2AMLogic/sky130-sar-adc/layout/cdac-array/README.md

# cdac-array/ — differential CDAC array layout (issue #100)

Physical layout for the differential charge-redistribution CDAC array
(`design/cdac/cdac_array.sch`) and its unit cell
(`design/cdac/cdac_unit_cell.sch`), drawn full-custom with `klt`'s
draw → DRC → extract → LVS flow.

```sh
layout/bin/setup-venv.sh              # once, or after bumping requirements.txt
source sim/env.sh                      # exports PDK_ROOT/PDK for xschem
layout/cdac-array/bin/run-flow.sh      # ~8 seconds; exit 0 iff all twelve verdicts hold
cat layout/cdac-array/reports/$(cat layout/cdac-array/reports/LATEST)/record.md
```

## Files

```
layout/cdac-array/
  bin/
    cdac_layout.py             # the generator: emits both top cells' GDS
    generate-lvs-reference.py  # xschem-netlists design/cdac/*.sch -> LVS reference
    render-record.py           # renders record.md, asserts the twelve verdicts
    run-flow.sh                # draw -> DRC -> precheck x2 -> extract -> LVS,
                               #   one record per run
  reference/
    cdac_array.lvs-reference.spice      # GENERATED from the schematic
    cdac_unit_cell.lvs-reference.spice  # GENERATED from the schematic
  reports/
    LATEST                     # record-id of the most recent run
    <record-id>/               # append-only: the GDS, drc/extract/lvs/draw JSON,
                               # the extracted netlist, the reference, record.md
```

Records follow `sim/`'s and `layout/trivial-cell/`'s append-only rule: a
re-run mints a new `<YYYYMMDD>-<HHMMSS>-<short-sha>` directory and never
edits an existing one.

## What the flow asserts

`run-flow.sh` exits non-zero unless **all twelve** of these hold, every one
read out of `klt`'s own JSON envelope rather than off a process exit code:

| # | Verdict |
| --- | --- |
| 1 | `klt drc` **clean** on `cdac_unit_cell` |
| 2 | `klt lvs` **match** on `cdac_unit_cell` vs. `design/cdac/cdac_unit_cell.sch` |
| 3 | `klt drc` **clean** on `cdac_array` |
| 4 | `klt lvs` **match** on `cdac_array` vs. `design/cdac/cdac_array.sch` |
| 5 | `klt extract` finds exactly 1024 MiM caps + 18 nfet + 18 pfet in `cdac_array` |
| 6 | Every bit 8..1 has its unit-cap centroid exactly on the array's centre in Y |
| 7 | Bits 8..4 additionally have it exactly on the centre in X |
| 8 | Every bit's P-side and N-side X centroids coincide |
| 9 | `klt precheck --grid-um 0.001` **pass** on `cdac_unit_cell` (its own database grid) |
| 10 | `klt precheck --grid-um 0.005` **pass** on `cdac_unit_cell` (sky130's manufacturing grid) |
| 11 | `klt precheck --grid-um 0.001` **pass** on `cdac_array` |
| 12 | `klt precheck --grid-um 0.005` **pass** on `cdac_array`, all 1024 units |

Verdicts 1–8 are numbered as they were before issue #498; 9–12 were added by
it and appended rather than interleaved so the numbering this document's own
prose uses did not shift under it.

One committed record predates that decision and does not show it:
`reports/20261001-084525-79abbf8/record.md`, the first post-resize record, was
rendered by a pre-final `render-record.py` that interleaved the four precheck
verdicts at 2/3/6/7, so it cannot be reproduced from its own committed JSON
envelopes by the renderer in this tree. It is left in place — records here are
append-only — and superseded by `reports/20261001-133221-7487784/`, a re-run of
the same flow at the same geometry whose `record.md` re-renders byte-for-byte
from its own envelopes. All twelve verdicts hold in both; only the numbering
differs.

Verdicts 6–8 exist because **1–4 have no opinion at all about placement**:
DRC and LVS are topology-only, silent about where a matched device
physically sits. Verdict 5 is independent confirmation of the same
extracted-device-count fact verdict 4's own literal comparison already
requires (see "`options.combine_devices` — issue #148" below); it stays as
a belt-and-braces check on the extraction side alone, cheap and orthogonal
to the LVS pairing. Verdicts 6–8 pin the placement using centroids computed
from the same placement functions the geometry is drawn from. Without
them, a matching-poor rewrite of this generator that still drew exactly
1024 unit elements in the wrong places would sail through 1–5.

Verdicts 9–12 exist because **1 and 3 are silent about manufacturing-grid
legality**, and that silence is not obvious: `klt drc`'s curated `sky130` deck
carries no `*.ongrid` rule on any layer (grep its own
`rules_checked`/`rules_skipped` lists in any `drc.json` here — there is no
OFFGRID entry), while the PDK's own shipped signoff deck
(`$PDK_ROOT/sky130A/libs.tech/klayout/drc/sky130A.lydrc`, `OFFGRID = true`) runs
`<layer>.ongrid(0.005)` by default on every metal/via layer this block draws. A
"DRC clean" record here therefore said nothing either way about the 5 nm grid
until these verdicts existed. They are a **gate, not an advisory metric**, per
[DR-019](../../spec/decision-records/DR-019-cdac-unit-cap-grid-legal-plate-resize.md)'s
standing policy for any block in this repo that draws a MiM cap.

They were added with DR-019's resize (#498) because before it they could not
have passed: on the old `CAPM_SIDE = 1.898` µm plate (1898 nm, not a multiple of
5) the same command reports **1** off-grid `capm` (89/44) shape in
`cdac_unit_cell` and **1024** in `cdac_array` — one per drawn unit, every one of
them the plate itself, measured directly against
`reports/20260924-233346-66dca3c/`'s committed GDS. On the 1.9000 µm plate both
are **0**, on both grids. `layout/halflsb-offset/`, which inherits this plate
size through DR-009, went 48 → 0 in the same pass.

The LVS reference is **regenerated from the schematic on every run**
(step 0 of `run-flow.sh`), never trusted from the committed copy: a match
against a stale reference proves nothing about today's schematic.

## `options.combine_devices` — issue #148

**`reports/20260825-132454-51cbdd4/`'s LVS "match" verdict did not
reproduce.** Re-running `klt lvs` today against that record's own committed,
byte-identical `cdac_array.gds`/`cdac_array.lvs-reference.spice`, with the
same toolchain versions its own provenance block stamps, reports
**mismatch** (48 errors), not match — and that mismatch reproduces 100% of
the time (10/10 repeat runs against those exact artefacts), so the original
"match" was itself the anomaly, not today's "mismatch" (see issue #148 for
the full diagnosis, including a version matrix ruling out a `klt`/`klayout`
version-drift explanation). **`reports/20260905-220338-9fb9b04/` (this
sub-block's current `LATEST`) supersedes it** with a fix that reproduces
match on every repeat run against its own committed artefacts (20/20, on
the `klt==0.4.0`/`klayout==0.30.12` pin `layout/requirements.txt` now
carries).

Root cause: the original flow's LVS request set `options.combine_devices:
true`, needed (at the time) to fold each bit's `w` physically drawn unit
capacitors into one device before comparing against a reference that
declared one combined `C` card of `w × C_unit` per bit. `w` ranges up to
256 here (the MSB), and issue #148 found that `klayout.db.Netlist.
combine_devices()` does not reliably re-sum `w` identical-valued parallel
capacitors at that scale: it correctly *sums* the capacitor device class's
secondary `A`/`P` (area/perimeter) parameters across the group, but on
some runs leaves the *primary* `C` (capacitance) parameter at a single
input instance's own unmerged unit value instead of the summed total —
silently, with **no exception and no `device.combine_incomplete` warning**
(the documented, already-mitigated nondeterminism from
klayout-tools#1185), so `klt lvs`'s own retry-on-exception mitigation for
that issue has nothing to catch. Depending on which numeric outcome a
given run happens to hit, the comparison can come back as: a spurious
`device.property` mismatch on `a`/`p` (when `C` summed correctly but the
reference has no syntax to declare the layout's now-nonzero combined
`A`/`P`, since a plain SPICE `C` card only carries a value); a spurious
mismatch on `c` itself (when `C` did not sum); or, on the original 2026-08-25
run, evidently neither — a lucky pass.

**The fix (issue #148) does not touch the reference-vs-layout `A`/`P`
question at all — it removes `combine_devices` from the picture entirely.**
`bin/generate-lvs-reference.py` now emits `w` separate unit-value `C` cards
per bit (one reference card per physically drawn unit capacitor) instead of
one combined card of `w × C_unit`, and `bin/run-flow.sh`'s LVS request sets
`options.combine_devices: false`. `klt lvs` now performs a literal,
uncombined, device-for-device comparison — 1024 drawn unit capacitors
against 1024 reference unit cards — which needs no device-merging pass on
either side and is a *strictly stronger* check than the folded comparison
ever was: it already fails if the array is not built from exactly `w`
identical unit elements per bit, with no separate extracted-device-count
verdict required to prove that fact (verdict 5, above, is now a redundant
but harmless independent confirmation of the same thing).

This is a `klayout-tools`/KLayout defect, not a usage error in this repo's
own LVS request (`combine_devices: true` was klt's own documented, intended
mechanism for exactly this folding use case): filed generically (no
design-specific detail, per `CLAUDE.md`'s friction protocol) at
[klayout-tools#1497](https://github.com/2AMLogic/klayout-tools/issues/1497)
-- a distinct failure mode from the already-tracked #1185/#466
(`RuntimeError`-on-partial-match, which has a documented retry mitigation):
this one never raises, so the existing exception-based mitigation for
#1185 cannot catch or retry against it. Should a future `klayout-tools`
release close #1497 with a guarantee that a combined device's primary
parameter (`C`) survives combining intact, `combine_devices: true` plus a
combined-card reference could be restored — but the per-unit form above is
simpler, needs no such guarantee, and is not planned to change back
without a concrete reason to.

## VDD and SELp/SELn landing geometry — issue #165

`cdac_array`'s `VDD` pin used to be a bare `nwell` rectangle with no tap or
contact drawn on it, and each `SELp<i>`/`SELn<i>` (i=0..8) pin used to be a
bare poly strap held at exactly the switch transistors' own channel width
end to end. Both were LVS-clean at this sub-block's own scope (the reference
subckt's ports only need to resolve to *some* named node), but neither had
any drawn conductor a top-level assembly (issue #103) could physically land
a wire on — sky130 has no global n-well connectivity fallback the way it
does for an unconnected p-substrate body (which is why `GND` connects for
free chip-wide but `VDD` did not).

Fixed with:

- **`VDD`**: a real n-well tap (`tap.drawing` + li1 + a licon1 column,
  mirroring `layout/comparator/bin/build_layout.py`'s own `tap_shapes()`
  recipe) contacted up through mcon to a met1 landing pad, placed in the
  open gap between the VREFN riser and the first switch's own diffusion —
  clear of every switch's geometry.
- **`SELp<i>`/`SELn<i>`**: a poly landing extension merged onto each gate-tie
  strap *outside* the diffusion-overlap region — specifically inside
  `SwitchTemplate.GAP_UM`'s own vertical clearance between the nfet and pfet
  blocks, which is diffusion-free by construction — offset away from the
  switch's own drain li1 riser, ending in a licon1/li1 pad sized to the same
  0.42 µm-square field-poly convention `klt gen mos_array`'s own gate pads
  use. The strap itself is untouched at its original channel width, so
  nothing here can be read as widening the transistors' extracted gate
  length.

Verified directly against `klt extract`'s per-device report: every one of
the 18 switch transistors' `L=0.15U` is byte-identical before and after (see
the PR for issue #165), and DRC/LVS both stay clean.

## `VSS` landing geometry — issue #377

Issue #165's parenthesis above — *"`GND` connects for free chip-wide"* — is
true of the **extraction deck** and false of the **layout**, and that gap is
what issue #377 closes here. `cdac_array`'s fourth schematic port (`VSS`,
every switch NFET's bulk) had no drawn conductor of its own at all. Unlike
`VDD` it was not even visible as an uncontactable bare layer: sky130's deck
synthesises one global p-substrate net by construction, so the port resolved
to that global and both `klt extract` and `klt lvs` were satisfied while this
block drew *no ground conductor whatsoever*. The composed assembly's analog
return therefore reached this block through substrate resistance — real, but
not something `klt drc` grades or this repo draws. That is the residue
[DR-012](../../spec/decision-records/DR-012-analog-ground-pad.md)'s own "Open
items" named.

Fixed with the p-substrate counterpart of the `VDD` tie above, by the same
`body_tap()` helper (in sky130 a tap is an n-tap or a p-tap purely by which
tub it sits in, so the drawn shapes are identical and only the placement
differs):

- **`VSS`**: `tap.drawing` + li1 + a licon1 column on **bare substrate**,
  directly below the `VDD` n-well tap and sharing its x, in the empty stripe
  between the switch row's own NFET diffusion (bottom edge y = −30.00) and
  the VREFN met2 rail — contacted up through mcon to a met1 landing pad
  carrying a `VSS` met1.pin label at (1.00, −31.60). That pad is what
  `layout/sar-adc-top/`'s analog ground mesh
  ([DR-013](../../spec/decision-records/DR-013-analog-ground-mesh.md)) lands
  a via riser on.

Clearances, and which of them this flow's DRC verdict actually backs: 0.60 µm
to the NFET block above (sky130's `difftap.3` tap-to-diffusion spacing is
0.27 µm) and 2.59 µm to the n-well's own bottom edge (`nwell.5a`, 0.34 µm)
are **not graded** — the pinned curated deck authors no rule on
`tap.drawing` (65/44) and none on n-well-to-tap spacing at all — so
`cdac_layout.py`'s `_assert_vss_tap_clearances()` asserts them in the
generator instead, where a future switch-row move fails loudly rather than
silently. The met1 landing pad's 2.84 µm to the VREFP rail and 1.79 µm to
the nearest switch riser *are* graded (`met1.space.1`), by every DRC run.

The reference side moved with the layout, not ahead of it:
`generate-lvs-reference.py` used to rename the schematic's `VSS` to `vsubs`
"for a block with no substrate tap of its own", which this block no longer
is, so the rename is retired for `cdac_array` and the reference now says what
the schematic says. `cdac_unit_cell` draws no tap of its own and keeps it.
Record `20260924-233346-66dca3c`: DRC clean on both cells, LVS match on both,
1060/1060 devices, 42/42 nets, 24/24 pins — all unchanged. One finding fewer
than the superseded record, and narrowly: `device.body_unverified` stops
firing on `cdac_array` because its substrate net is now a *named drawn
conductor* (`VSS`) rather than the deck's anonymous global. The deck's
`connect_global` still ties the eighteen NFET bodies together by
construction; nothing here verifies a per-device body tie, and
`cdac_unit_cell` still reports the warning, correctly.

That record is also this flow's first run on `klayout-tools==0.6.0`. A
same-source baseline on the new pin was run first and reproduced the
superseded `20260917-180543-527ec73` exactly (clean/match, 2 findings,
1060/42/24), so the delta above is this change's, not the bump's.

---

# The matching strategy

This is the block's matching-critical sub-block: its unit-capacitor ratios
*are* the converter's INL/DNL, and no amount of DRC/LVS cleanliness speaks
to them. What follows is the deliberate strategy, stated so it can be
argued with — and, where it is measurable, measured in each record.

## 1. Unit elements, never scaled plates

`design/cdac/cdac_array.sch` writes bit `i`'s weight as `MF=2**i` on one
`cap_mim_m3_1` symbol, and `design/cdac/README.md` is explicit that this is
netlist shorthand for `2**i` *parallel unit cells*, "**NOT** a claim about
physical placement". This layout takes that literally: **1024 physically
identical unit capacitors**, 512 per side, one drawn unit per unit of
weight. Every one of them is the same shape — same 1.900 µm capm plate,
same met3 bottom plate, same via2 position, same via1/met1 stub geometry —
so that whatever the process does to one unit, it does to all of them.

This is not merely stylistic. sky130's MiM model (and `klt extract`'s deck)
carries a **perimeter** term as well as an area term, so a single plate of
`w` times the unit area is *not* `w` unit capacitors: it has
`√w` times the perimeter, not `w` times. Ratio accuracy in a
binary-weighted CDAC depends on the weights being exact multiples, and only
a unit-element decomposition delivers that by construction. (It also means
the LVS reference for a bit of weight `w` is `w` separate unit-value `C`
cards, not one combined card of `w × C_unit` — see "`options.combine_devices`
— issue #148" below for why the reference is literal unit cards rather than
a scaled single device.)

## 2. Common centroid in X: dyadic mirror-pair columns

The array is 64 columns × 16 rows on a 3.4 µm pitch, so a column holds 8
units per side. Bits 8..4 own 32/16/8/4/2 columns, always as
**mirror-symmetric pairs about the array's vertical centre line**, and each
bit's columns are spread with a *dyadic* ("ruler") interleave — the largest
bit takes every other column slot, the next takes every other remaining
slot, and so on:

```
h (distance rank from the centre): 0  1  2  3  4  5  6  7  8 ...
bit owning that column:            8  7  8  6  8  7  8  5  8 ...
```

The mirror pairing cancels a **linear** X gradient exactly (verdict 7). The
dyadic spread is what makes the arrangement robust to a **quadratic**
(bowl-shaped) gradient as well: every bit samples the same distribution of
distances from the centre, so a bowl scales every bit's weight by
approximately the same factor — a gain error, not a nonlinearity, and gain
errors do not cost INL or DNL.

## 3. Differential interleave in Y, with a parity flip at the midline

Rows alternate P/N so that a Y gradient sees both sub-arrays equally. A
naive strict alternation would still leave the P set and the N set offset by
one row pitch (P on rows 0,2,4,… averages one row below N on 1,3,5,…), so
the parity **flips at the array's horizontal midline**: P owns the even rows
in the lower half and the odd rows in the upper half. The two sides' Y
centroids then coincide exactly, for every bit (verdict 6 and the record's
own centroid table).

Because P and N share the *same columns* for every bit, their X centroids
coincide by construction too (verdict 8) — a differential pair of
sub-arrays placed side by side, rather than interleaved, would instead have
its whole differential gain riding on the X gradient between the two halves.

## 4. The residuals, stated plainly

A binary-weighted array has a smallest element that cannot be split
symmetrically. Ours are:

- **bit3** owns a single column (col 31) and the
  **bit2+bit1+bit0+termination group** owns a single column (col 32). They
  sit either side of the centre line, so their X centroids are ∓1.7 µm
  (half a column pitch) rather than 0. The two offsets are equal and
  opposite, so the *side total* is still centred; the residual is a
  1.7 µm lever arm on groups worth 8 and 8 units out of 512.
- **bit0 and the termination unit** are one unit per side, so their P/N
  pairs are one row pitch (3.4 µm) apart in Y rather than coincident. This
  is the minimum achievable separation for a single-unit bit.

Both residuals are printed in every record's centroid table, not hidden.

## 5. The guard frame — and why it carries no capm

The array is ringed by one row/column of **guard plates**: the identical
met3 bottom-plate geometry and via2 landing as a real unit, tied to VREFN
(left/right/top collected on met2, the bottom row on met1 so its collector
does not have to cross 128 column straps on their own layer), but with the
**MiM top plate omitted**.

The omission is forced, and it is worth being blunt about the consequence:

- Under `klt` 0.3.0's sky130 extraction deck, *any* capm drawn over met3 is
  recognised as a capacitor device. The deck's dummy-device marker layer
  (`(83, 20)`, which suppresses drawn-but-non-functional MOS, resistor,
  bipolar and diode devices) is **not** consulted for drawn capacitors, so a
  capm-bearing dummy cannot be suppressed. Nor can it be neutralised by
  shorting its plates: the deck's `top_plate_via` overlap exclusion removes
  *every* via3-on-met3 overlap in the layout once any capm exists, so met4
  cannot be routed down to met3 anywhere, and a dummy's top plate has no
  path back to its own bottom plate.
- The result is that a capm dummy ring would appear in the extracted netlist
  as extra capacitors with no schematic counterpart — i.e. it would trade an
  LVS-clean result (an acceptance criterion of issue #100) for an
  etch-density guard.

So this layout guards the **bottom-plate (met3) level** — pattern density,
plate-edge lithography and the etch environment of the outermost active
plates — and leaves the **capm level** unguarded. What that costs is
bounded and uniform in the direction that matters: every column contributes
exactly one unit per side to each of the two edge *rows*, so a
row-edge effect is a pure gain term shared by all bits, with no INL/DNL
contribution. Only the two edge *columns* are bit-specific, and they carry
32 units per side out of 512.

Per `CLAUDE.md`'s friction protocol both tool gaps above are filed
**generically** at `2AMLogic/klayout-tools` — tool behaviour only, no
design detail: klayout-tools#1387 (the `dummy` marker is not honoured for
drawn capacitors) and klayout-tools#1388 (the top-plate-via exclusion is
chip-wide on a zero-oversize deck, so one drawn cap disconnects every
ordinary via between the bottom-plate metal and the metal above it). A
future `klt` that closes #1387 would let this ring grow a capm plate with
no other change to the generator — `draw_unit_cap(..., capm=False)` is a
one-flag switch — and the guard plates would then need only the deck's
dummy-marker layer added on top.

## 6. What this layout does *not* claim

- **No matching evidence.** Nothing here measures σ(ΔC/C), INL or DNL. The
  strategy above is an argument from symmetry, plus centroid arithmetic; the
  evidence is a Monte-Carlo mismatch campaign (issues #28/#29) run against
  a netlist that instantiates literal parallel unit cells. `design/cdac/
  README.md` §3 already flags that an `MF`-scaled schematic netlist may
  understate array mismatch if ngspice scales one mismatch term instead of
  drawing `w` independent ones — this layout is exactly the `w` independent
  units that concern is about.
- **No parasitic extraction.** `klt extract`'s device recognition is not an
  RC extraction; the met2 bottom-plate straps and met4 top-plate rails carry
  real parasitic capacitance to the top plates that is not in any number
  here.
- **No routing-parasitic balancing.** The per-bit strap lengths differ
  (a bit's straps run from its own columns to its own bus row), so the
  bottom-plate wiring capacitance is *not* matched between bits. It sits on
  the bottom plate, which is driven hard to VREFP/VREFN by the switch, so it
  costs settling time rather than charge accuracy — but it is unbalanced and
  unquantified, and a future revision that cares should say so with numbers.
- **Spec ratification.** `C_u` and `V_REF` were ratified by DR-003 via issue
  #27; this layout consumes DR-003 Item 3's plate size, as amended by DR-019
  (`1.9000 µm`, `C_u ≈ 8.664 fF`), and would be regenerated, not patched, if
  that changes again.
- **Grid legality — now checked here, and clean** (verdicts 9–12, added by
  issue #498). This was a known, measured failure until DR-019: on the old
  `CAPM_SIDE = 1.898` µm plate, `klt precheck --grid-um 0.005` reports 1024
  off-grid `capm` shapes in `cdac_array` and 1 in `cdac_unit_cell`, because
  1898 is not a multiple of sky130's 5 nm manufacturing grid and neither the
  plate's corners nor any via/pad a router centres on them can land on-grid.
  `layout/halflsb-offset/`'s own census (#495) is what surfaced the question,
  and
  [DR-019](../../spec/decision-records/DR-019-cdac-unit-cap-grid-legal-plate-resize.md)
  (#496) answered it: it reads the PDK's own shipped signoff DRC deck
  directly, confirms the grid check is real (not a klt-only convention), and
  resizes `C_u`'s plate to a 5 nm-grid-legal `1.9000 µm` rather than waiving
  it. Issue #498 carried that through here (`CAPM_SIDE = 1.900`), re-ran the
  flow, and added the two precheck stages as gating verdicts; the census is
  now 0 across all 1024 instances.

## Provenance

Flow structure (record convention, "assert verdicts from the JSON envelope,
never the exit code", `setup-venv.sh` reuse) follows
`layout/trivial-cell/`'s own flow in this repo, which was in turn ported
from `2AMLogic/sky130-bandgap` per `CLAUDE.md`'s harness-bootstrap
instruction. The layout itself is drawn from `design/cdac/*.sch` and device
physics only — clean room, per `CLAUDE.md`: no other party's CDAC
implementation was consulted, measured, netlisted or reconstructed.

## Tool-pin note

This sub-block requires `klayout-tools` **0.3.0** (bumped from 0.2.0 in
`layout/requirements.txt` by this work). 0.2.0's sky130 extraction deck
stops its `metals`/`vias` connectivity at met1, so a MiM-cap array — whose
bottom plates live on met3 and whose top-plate rails live on met4 — is not
extractable at all on that pin. The bump has one piece of fallout outside
this directory: `layout/trivial-cell/reference.spice` carried 8 M-cards
because 0.2.0 could not tell a dummy MOS from a real one, and 0.3.0 can, so
that reference is now 4 M-cards. Its header records the change; the
six-verdict trivial-cell flow passes on the new pin.

## `klt 0.4.0` → `0.5.0` re-run (issue #323): no change

This flow's sign-off record rested on `klt 0.4.0` (`reports/20260906-020815-38cdbd3/`)
while `layout/requirements.txt` had already moved to `klt 0.5.0` for the other
sub-blocks and the top-level composition — a version-parity gap, not a known
defect (see the parent issue for why that gap mattered). Re-run under the
pinned `klt 0.5.0` (`reports/20260917-180543-527ec73/`, now `reports/LATEST`):
`drc.json` and `lvs.json` (for both `cdac_unit_cell` and `cdac_array`) are
field-identical to the superseded record —

| Field (source, `cdac_array`) | `klt 0.4.0` | `klt 0.5.0` | Delta |
| --- | --- | --- | --- |
| `drc.json` `status` / `violation_count` | clean / 0 | clean / 0 | none |
| `lvs.json` `status` | match | match | none |
| `lvs.json` `mismatch_count` / `error_count` | 2 / 0 | 2 / 0 | none |
| `lvs.json` `counts.devices` (layout/reference/matched) | 1060/1060/1060 | 1060/1060/1060 | none |
| `lvs.json` `counts.nets` (layout/reference/matched) | 42/42/42 | 42/42/42 | none |
| `lvs.json` `counts.pins` (layout/reference/matched) | 24/24/24 | 24/24/24 | none |
| `lvs.json` `category_counts` | `device.body_unverified: 1, topology: 1` | `device.body_unverified: 1, topology: 1` | none |

`cdac_unit_cell`'s own DRC/LVS (clean / match, 3/3/3 devices, 7/7/7 nets) and
the drawn common-centroid geometry (unit capacitance, per-net unit counts,
per-net centroids) are likewise unchanged between the two records. No
regression — including no change in the sub-block's capacitor-heavy device
mix, which is the class of change klayout-tools#1876 (§3 of
`docs/chipalooza/challenge-4-proposal.md`) affected elsewhere in this
repo's `klt 0.5.0` re-runs — so no upstream `klayout-tools` issue was filed
for this re-run.
