2AMLogic/sky130-sar-adc/layout/sar-sequencer/README.md

# layout/sar-sequencer/ — SAR logic/sequencer physical layout (issue #102)

Physical layout for the SAR logic/sequencer sub-block: an (N+1)-stage
walking-one ring sequencer plus a 10-bit SAR register, captured in
`design/sar_sequencer.sch`/`.sym` (issue #55) on `sky130_fd_sc_hd` standard
cells. This directory places and routes that netlist and runs it through the
`klt` DRC/LVS flow, following `layout/README.md`'s (and `layout/trivial-cell/`'s)
conventions.

## Which `klt` flow, and why

**`klt place-and-route` (OpenROAD), not the full-custom `klt draw` flow.**
This sub-block is pure digital standard-cell logic with no analog matching/
symmetry judgement call (unlike the sampling front end, CDAC array, or
comparator sub-blocks) — placement and routing is exactly the kind of
decision a placer/router should make, not a hand-drawn one.

**`klt place-and-route` directly, *not* `klt synthesize` first.** `klt
synthesize` runs Yosys/ABC technology mapping from **RTL** — but this
sub-block has no RTL. `design/sar_sequencer.sch` already specifies exact
`sky130_fd_sc_hd` cell instances (dfrtp_1/mux2_1/or4_1/or3_1/inv_1) and
connectivity, already behaviorally verified against that exact netlist by
`sim/sar-sequencer-behavioral/`'s own testbench. Re-synthesizing from scratch
RTL through Yosys/ABC would let the tool pick *different* cells/drive
strengths than the ones already captured and simulated — laying out an
un-simulated netlist instead of the reviewed one. `layout/sar-sequencer/netlist/sar_sequencer.v`
is therefore a **hand-verified 1:1 structural transliteration** of the
schematic's own SPICE X-card connectivity (cross-checked line-for-line
against a real netlist snapshot in
`sim/sar-sequencer-behavioral/netlist-snapshots/*.spice`) into Verilog module-
instantiation syntax — not RTL synthesis output — and is fed straight to `klt
place-and-route`.

**Clock constraint**: `requests/place-and-route.json`'s `clock_period_ns:
83.33` (12 MHz) is `spec/decision-records/DR-006-sar-sequencer-bit-count-and-timing-budget.md`'s
own derived `f_clk,max` (the faster, more timing-demanding end of its
provisional `1.2 MHz – 12 MHz` range) — not an arbitrary number.

**Power delivery (`requests/place-and-route.json`'s `power` block)**: a real
PDN (`tapcell` well/substrate ties, `VPWR`/`VGND` global-connect, and
met1/met4/met5 straps — parameters taken from
`OpenROAD-flow-scripts`'s own published `platforms/sky130hd/pdn.tcl`
reference config, Apache/BSD-licensed EDA tooling config, not anyone's
silicon), not the row-rail-only obstruction `klt place-and-route` draws by
default when `power` is omitted. This is required for a *connected* `VPWR`/
`VGND`, not just an obstruction-shaped one — see "LVS reference provenance"
below for why an unconnected PDN made this sub-block's own LVS
un-passable, independent of any `klt` tool gap.

## Running the flow

```sh
layout/bin/setup-venv.sh              # once, or after bumping requirements.txt
source sim/env.sh                      # exports PDK_ROOT/PDK
layout/sar-sequencer/bin/run-flow.sh   # ~1-2 minutes; place-and-route -> DRC -> LVS
```

Requires an `openroad` binary on `$PATH` in addition to `layout/README.md`'s
own prerequisites (`klt place-and-route` invokes it as a subprocess) — see
`docs/environment-setup.md`.

Each run mints a new timestamped, append-only record under
`reports/<record-id>/` (same convention as `layout/trivial-cell/reports/`,
see `layout/README.md`): the input netlist, the resolved P&R request, the
routed GDS/DEF, the post-route netlist, the generated LVS reference, every
`klt` JSON envelope, and a human-readable `record.md`. `reports/LATEST`
points at the newest record id.

## Current status (as of the record referenced by `reports/LATEST`)

- **Place-and-route: succeeds.** Floorplan → global/detailed placement →
  clock-tree synthesis → global/detailed routing all complete at the 12 MHz
  clock constraint above with **zero setup/hold timing violations**.
- **DRC: clean.** `klt drc --deck sky130` reports 0 violations against the
  routed GDS.
- **LVS: clean.** `klt lvs` reports `status: "match"`, 760/760 devices and
  395/395 nets matched, 0 mismatches — see "LVS reference provenance" below
  for the three-part fix that got here from the `mismatch` verdict PR #105
  originally recorded.

## WITHDRAWN 2026-09-24 (issue #363): the "112 metal minimum-area violations" were a measurement artifact

**This section used to be a dated waiver over 112 sub-minimum-area shapes,
issued under issue #333 on 2026-09-19. It is withdrawn, not reaffirmed: there
were never 112 violations, and there are none now.** The count came from
`docs/chipalooza/measure_metal_min_area.py`, which issue #363 found
**under-merges** the region it measures.

The script built its region as `kdb.Region(); region.insert(iter);
region.merge()`. `Region#insert(RecursiveShapeIterator)` carries each shape's
GDS user properties across, and KLayout's merge is **property-aware**: two
overlapping polygons whose property sets differ are never merged into one. The
DEF→GDS merge attaches a net-name property (`[[1, "VPWR"]]`, `[[1, "VGND"]]`)
to every PDN strap and none to the via cells sitting inside it, so a covered
via pad stayed its own polygon and was counted as a standalone violation. Every
one of the 112 was of exactly that kind — a tech-LEF via enclosure that *is*
merged into the wire it terminates in the drawn GDS, which is precisely what
the LEF expects of it.

Re-measured 2026-09-24 against the same
`reports/20260917-180601-527ec73/sar_sequencer.gds`, same pinned toolchain
(`klayout 0.30.12`, open_pdks `c6d73a35f524070e85faff4a6a9eef49553ebc2b`),
with the corrected construction:

| Rule | Threshold | Merged polygons (pre-#363 → corrected) | Shapes below (pre-#363 → corrected) |
| --- | --- | --- | --- |
| `m1.6` | 0.083 um² | 499 → 224 | 96 → **0** |
| `m2.6` | 0.0676 um² | 305 → 92 | 6 → **0** |
| `m3.6` | 0.240 um² | 40 → 18 | 8 → **0** |
| `m4.4a` | 0.240 um² | 18 → 2 | 0 → **0** |
| `m5.4` | 4.0 um² | 4 → 2 | 2 → **0** |

**112 → 0.** The "merged polygons" column is the tell: the corrected
construction merges roughly half as many polygons out of the same drawn
shapes, because the property-tagged ones can finally merge with the untagged
ones they overlap.

**Independent corroboration.** This flow's own record predates the
`klayout-tools==0.6.0` bump, so its `drc.json` carries no `area`-kind rule. But
this block's GDS is composed verbatim into `layout/sar-adc-top/`, whose current
record `20260924-190817-f3622fc` was minted on the 0.6.0 pin and whose
`drc.json` `coverage.rules_checked` **does** include `met1.area.1` …
`met5.area.1` (52 rules, status `clean`, **0 violations**) over geometry that
contains this block's. Two independent measurements of the same five foundry
rules now agree at zero; before #363 they disagreed, and the hand-rolled one
was wrong.

The regression is pinned by `sim/tests/test_measure_metal_min_area.py` and run
in CI's headless `checks` job, so this count cannot silently drift again.

**Upstream filings, now superseded.** The following were filed (generically,
per CLAUDE.md's friction protocol) against the artifact counts and their
premise, and should be read as withdrawn on this repo's side:

- `2AMLogic/klayout-tools#2139` — filed as the live tool gap for this
  "defect", with a generic 48-stage inverter chain reproducer whose 99 sub-
  `m1.6`/`m5.4` shapes were counted with the same under-merging measurement.
  Its premise does not survive #363. **Corrected upstream 2026-09-24**
  (issue #373): the reproducer was re-run from its own quoted inputs and
  measured both ways on the identical output GDS — 76 shapes below threshold
  under the pre-#363 construction (58 `m1.6` + 18 `m5.4`, the same two
  geometry classes the filing named), **0 under the corrected one**, with
  `klt drc --deck sky130` at the 0.6.0 pin agreeing at 0. `#2139` had already
  been closed upstream (`COMPLETED`, 2026-09-19) by merged PR
  `2AMLogic/klayout-tools#2144`, which ships a post-route minimum-area repair
  pass that the 0.6.0 pin therefore carries; on this reproducer that pass is a
  no-op (`min_area_repair: patches 0, repaired 0, remaining 0`, byte-identical
  merged GDS). No revert was requested: `#2144` defends against tech-LEF via
  enclosures and PDN via landings that are genuinely sub-threshold in
  isolation, which is independent of the inflated count that motivated it.
- `2AMLogic/klayout-tools#2072` / `#2075` — the earlier pair. `#2075`'s
  `klt gen-compose` landing-pad fix was a real, separate defect (issue #326's
  17 shapes were genuinely isolated pads) and stands; the place-and-route half
  `#2139` was filed to supply a reproducer for does not.
- `2AMLogic/klayout-tools#1989` — merged and, as of the 0.6.0 pin, **released**;
  it is what gives `klt drc` its own `met*.area.1` rules and therefore the
  corroboration above.

## `klt 0.4.0` → `0.5.0` re-run (issue #323): no change

This flow's sign-off record rested on `klt 0.4.0` (`reports/20260905-191258-4c6c655/`)
while `layout/requirements.txt` had already moved to `klt 0.5.0` for the other
sub-blocks and the top-level composition — a version-parity gap, not a known
defect (see the parent issue for why that gap mattered). Re-run under the
pinned `klt 0.5.0` (`reports/20260917-180601-527ec73/`, now `reports/LATEST`):
`drc.json` and `lvs.json` are field-identical to the superseded record —

| Field (source) | `klt 0.4.0` | `klt 0.5.0` | Delta |
| --- | --- | --- | --- |
| `drc.json` `status` / `violation_count` | clean / 0 | clean / 0 | none |
| `lvs.json` `status` | match | match | none |
| `lvs.json` `mismatch_count` / `error_count` | 0 / 0 | 0 / 0 | none |
| `lvs.json` `counts.devices` (layout/reference/matched) | 760/760/760 | 760/760/760 | none |
| `lvs.json` `counts.nets` (layout/reference/matched) | 395/395/395 | 395/395/395 | none |
| `lvs.json` `counts.pins` (layout/reference/matched) | 30/28/30 | 30/28/30 | none |
| `lvs.json` `category_counts` | `{}` | `{}` | none |

The 30/28/30 pin-count asymmetry (two post-CTS clock-tree leaf nets promoted
as pins beyond the reference `.SUBCKT`'s 28 declared ports — issue #322) is
unchanged under `klt 0.5.0`, so it is not `klt`-version-sensitive: whatever
is producing it is present in both builds. No regression, so no upstream
`klayout-tools` issue was filed for this re-run.

## LVS reference provenance

`klt extract --deck sky130` is a **flat, transistor-level** extractor (its
own docstring: "extraction is flat"), so a `klt lvs` reference has to be flat
and transistor-level too — a hierarchical reference with `X`-instances of
`sky130_fd_sc_hd__*` standard cells cannot be compared circuit-for-circuit
against a flat layout netlist. `klt extract`'s sky130 deck also generalizes
every drawn NMOS/PMOS into two device classes, `nfet`/`pfet` (not
`nfet_01v8`/`special_nfet_01v8`/`pfet_01v8_hvt`), so the reference has to use
those same two generic model names.

`bin/generate-lvs-reference.py` builds that reference mechanically: it
parses `klt place-and-route`'s own **post-route** `write_verilog` dump (the
gate-level netlist *as actually routed* — `clock_tree_synthesis`/
`repair_design`/`repair_timing` legitimately insert clock buffers and repair
cells beyond the pre-P&R input netlist; verified by direct diff that these
are the *only* additions — no combinational-logic instance, port, or gate-
level connection differs from `netlist/sar_sequencer.v`'s own schematic-
derived topology) and flattens every instance against the sky130 PDK's own
official per-cell transistor-level CDL models
(`$PDK_ROOT/sky130A/libs.ref/sky130_fd_sc_hd/cdl/sky130_fd_sc_hd.cdl`,
Apache-2.0 licensed, SkyWater's own release — not reverse-engineered from
anyone's silicon or netlist).

### History: from `mismatch` (PR #105) to `match` (issue #102's own re-investigation)

PR #105 reached place-and-route + DRC-clean but recorded `klt lvs` as
`mismatch` with `matched: 0` nets/devices on both sides, despite the
reference's device count matching the layout-extracted netlist's own
**exactly** (760 = 760). It root-caused that to a `klt extract`
pin-name-promotion gap on a DEF→GDS-merged layout and filed
`2AMLogic/klayout-tools#1385` (fixed upstream by klt#1391/#1397, released in
klayout-tools 0.4.0). Bumping `layout/requirements.txt`'s pin to 0.4.0 and
switching this flow's LVS step from inline extraction
(`layout.top_cell_pins: true`) to a pre-extraction pass using the new `klt
extract --def-pins <def_path>` (deriving the declared pin set directly from
the routed DEF's own `PINS` section, instead of guessing from GDS label
nesting) did produce clean, canonical top-level pin names — but `klt lvs`
**still** reported a full `mismatch` (0/760, 0/415 nets/devices), even with
an explicit `hints.same_nets` assertion pairing `CLK` to `CLK` outright
rejected. Since `klt lvs` self-compare (the extracted netlist against an
unmodified copy of itself) matched 100% at this same scale, and neither pin
order nor a wholesale net-identity merge broke that self-compare, the
remaining full mismatch was not a `klt` engine limitation — it was a real
topological difference between the routed layout and this reference. Direct
inspection of the extracted netlist found two:

1. **The layout's `VPWR`/`VGND` were not single, unified nets.** `klt
   place-and-route` without a `request.power` block only draws a row-rail
   *obstruction* (`add_pdn_stripe -followpins` + `pdngen -dont_add_pins`,
   with no vertical straps) — enough to keep the router from routing through
   the rail, but not enough to tie every row's local power/ground segment
   into one global net. The routed GDS carried **7 disconnected `VGND`
   islands and 7 disconnected `VPWR` islands** (`VGND`, `VGND$1`..`VGND$6`,
   and the `VPWR` equivalents) — while the reference, like every real
   integration of this sub-block, assumes one global `VPWR` and one global
   `VGND`. Since nearly every device's body/supply terminal touches one of
   these nets, a 7-way split versus a 1-node reference poisoned enough of
   the graph to prevent `NetlistComparer` from establishing *any*
   correspondence, even with an exact device-count match and an explicit
   `same_nets` hint. Fixed by adding a real PDN
   (`requests/place-and-route.json`'s `power` block: `tapcell`
   well/substrate ties, `add_global_connection`/`pdngen` merging every
   `VPWR`/`VPB`/`VDDPE`/`VDDCE`-pattern pin into one `VPWR` net and every
   `VGND`/`VNB`/`VSSE`-pattern pin into one `VGND` net, plus met1/met4/met5
   straps) — parameters taken directly from `OpenROAD-flow-scripts`'s own
   published `platforms/sky130hd/pdn.tcl` reference config (Apache/BSD EDA
   tooling config, not anyone's silicon). This is a place-and-route
   *request* fix in this repo's own files, not a `klt` defect or gap: `klt
   place-and-route` already supports a full PDN via `request.power` — this
   sub-block's own request just hadn't asked for one. With the PDN in
   place, `VPWR`/`VGND` also become genuine promoted top-level pins (a real
   block-level P/G interface `pdngen`'s own `-pins` promotes), so
   `top_ports` in `generate-lvs-reference.py` now declares them too.
2. **`generate-lvs-reference.py` ignored the CDL's `m=` (finger-count)
   parameter.** `sky130_fd_sc_hd__buf_4`'s own CDL declares its output-stage
   transistors as `m=4` (four parallel fingers, not one finger at 4x the
   width) — `klt extract`'s `combine_devices` correctly folds the four
   physically-drawn layout fingers into one schematic-equivalent device at
   4x the per-finger width (confirmed: this sub-block's raw pre-fold
   `device_count` of 778 folds to exactly 760, matching 3 `buf_4` instances
   x 2 multi-finger output transistors x 3 folded-away redundant fingers),
   but the reference generator was reading only the CDL's bare per-finger
   `w=` and ignoring `m=` — understating that folded device's true width 4x
   for every `buf_4` instance's output stage. Fixed by scaling
   `w = CDL's w= * CDL's m=` when building each device's SPICE card (using
   `decimal.Decimal`, not `float`, so e.g. `0.65 * 4` prints as the exact
   `2.6` a human would write). With this fixed, the residual mismatch (24
   entries, all on the three `buf_4` clock-buffer instances'
   `device.unmatched`/`net.merged`/`net.split`) also cleared.

Once both were fixed, a fresh run reached `status: "match"`, 760/760
devices and 395/395 nets, 0 mismatches — with `--def-pins` alone (no
`--def-net-names` needed): `klt lvs` compares topology, not net *names*, so
the merged/joined pin-label names `--def-pins` still leaves in place (e.g.
`A0|DOUT0|Q`) never blocked the match once the underlying connectivity graph
was actually correct. `bin/run-flow.sh` always records whichever verdict
`klt lvs` actually reports, so a regression would show up as `mismatch` in
`record.md` with no script change required to detect it.

### Why the pin counts read 30/28/30, not 28/28/28 (issue #322)

`reports/LATEST`'s `lvs.json` reports `pins: {"layout": 30, "reference": 28,
"matched": 30}` — asymmetric, with the layout/matched side *exceeding* the
reference's own port count. This is **not** a sign of a bad match: `status`
is `"match"` with 0 mismatches/errors and 760/760 devices, 395/395 nets, all
exactly matched. The pin-count field is a separate accounting that only
counts *which* nets got flagged as pins on each side, and it is understood
to be wrong-by-two on the layout side. The figure is kept as recorded here
(not hand-edited) because it is what `klt lvs` actually reported for this
run, and this repo's records are append-only evidence, not smoothed
numbers.

**Root cause, verified directly against this record's own committed
artefacts** (`sar_sequencer.def`, `extract.json`, `lvs.json`,
`sar_sequencer.lvs-reference.spice`):

- `sar_sequencer.def`'s `PINS` block declares exactly the reference's 28
  names (`PINS 28 ;`, confirmed by reading the block — no `CLKNET_*` entry
  is present). `--def-pins` was passed to `klt extract` as documented above,
  so the DEF's declared pin set — not GDS label nesting — is what step 5 of
  `bin/run-flow.sh` asks the extractor to treat as authoritative.
- `extract.json`'s `merged_net_labels[]` records two merged nets whose
  constituent GDS labels include the real `CLK` port label alongside
  internal clock-buffer instance labels (`A`/`X`, the `sky130_fd_sc_hd__buf_4`
  cells' own pin names): `{"net": "A|CLK|X", "labels": ["A", "CLK", "X"]}`
  and `{"net": "CLK|X", "labels": ["CLK", "X"]}`. `extract.json`'s `nets[]`
  entries for both merged nets carry `"pin": true` — that flag comes from
  `klt extract`'s own net-label-merging pin-flagging heuristic, and it
  survives even though `--def-pins` was supplied; those two merged names
  are not in the DEF's declared 28-pin set. This inflates `pin_count` to 30
  and is baked directly into the extracted netlist's own `.SUBCKT` port
  list (`sar_sequencer.extract.spice`), not just a JSON metadata field —
  confirmed by reading that file's `.SUBCKT` line, which lists 30 ports
  including `A|CLK|X`.
- The LVS engine's own reference-side pairing for those two layout pins
  (`lvs.json`'s `net_correspondence`) resolves to `CLKNET_1_0__LEAF_CLK` and
  `CLKNET_1_1__LEAF_CLK` — genuine *internal* nets of the reference
  netlist (OpenROAD's own CTS-inserted clock-buffer leaf nets), confirmed
  absent from `sar_sequencer.lvs-reference.spice`'s 28-port `.SUBCKT` line.
  The reference side is behaving correctly; the false "pin" flag
  originates entirely on the layout-extraction side.

This is a `klt extract` behavior gap, not a request-file choice in this
flow: filed generically (no design-specific detail) at
`2AMLogic/klayout-tools#2000` — a merged net's pin flag isn't gated by an
explicit declared-pin-set input (`--def-pins`/`--pins`), so a merged net
that happens to include a real pin's GDS label among its constituent labels
still gets promoted to a pin regardless of whether the merged net *itself*
is in the declared set. No repo-local fix is applied here: correcting the
`.SUBCKT` port list by hand would mean hand-editing a generated deliverable
of `klt extract` (`sar_sequencer.extract.spice`) after the fact, which
would misrepresent what the tool actually produced for this run — exactly
the "smoothed record" this flow's append-only-evidence convention exists to
avoid. A future run against a `klt` release that fixes
`2AMLogic/klayout-tools#2000` will mint a new dated record with the
corrected count; no script change is needed to pick that up, per
`bin/run-flow.sh`'s "always records whichever verdict `klt lvs` actually
reports" convention above.

## Files

```
layout/sar-sequencer/
  README.md                        # this file
  netlist/
    sar_sequencer.v                # hand-verified structural netlist (not RTL) -- see "Which klt flow" above
  requests/
    place-and-route.json           # klt place-and-route request (clock/floorplan/io/power per above)
  bin/
    run-flow.sh                    # place-and-route -> DRC -> post-route netlist dump -> LVS reference -> extract --def-pins -> LVS -> record
    generate-lvs-reference.py      # flattens a structural Verilog netlist against the PDK's own CDL models
    render-record.py               # renders record.md from the JSON envelopes run-flow.sh produced
  reference/                       # generate-lvs-reference.py's own output -- regenerated per run, git-ignored
  reports/
    LATEST                         # record-id of the most recent run
    <record-id>/                   # append-only: netlist, request, routed GDS/DEF, post-route netlist,
                                    # generated LVS reference, klt JSON envelopes, record.md
```

## Provenance

Structure follows `layout/trivial-cell/`'s own conventions (append-only
timestamped records, `reports/LATEST` pointer, `record.md` provenance
stamping) per `CLAUDE.md`'s "Harness bootstrap" instruction, adapted for the
digital place-and-route flow this sub-block uses instead of `klt gen`/`klt
draw`. Clean room: the topology placed and routed is this repo's own
`design/sar_sequencer.sch` (issue #55); the only external inputs are the
sky130 PDK's own official, freely-licensed standard-cell library (LEF/
liberty/GDS/CDL) and OpenROAD's own placement/routing/CTS algorithms — never
another party's implementation.
