2AMLogic/sky130-sar-adc/sim/spec-coverage.md

<!-- GENERATED FILE -- do not edit by hand.
     Source of truth: sim/spec-coverage.json
     Regenerate:      python3 sim/check_spec_coverage.py --render
     Checked by:      npm run check:spec-coverage (part of npm run check:ci) -->

# Spec-row coverage index

Which `spec/target-spec.md` row is addressed by which committed testbench, which evidence record it rests on, and the exact command a third party runs to reproduce it. This answers "is this row addressed?" without reading every directory under `sim/`.

Generated from `sim/spec-coverage.json` and enforced by `sim/check_spec_coverage.py` (T1 item 9: testbench completeness, cold-start invocation, pinned PDK revision). A claimed spec row with no bench fails the check; so does a stale copy of this file.

## Cold start

One-time machine bootstrap: `docs/environment-setup.md` sections 1-3. Then, from the repo root:

```sh
# One-time machine bootstrap: docs/environment-setup.md sections 1-3
#   (xschem + ngspice + ciel install, `ciel enable` of the pinned
#    open_pdks commit, PDK_ROOT/PDK convention).
source sim/env.sh
python3 sim/run_corners.py --check-env   # exit 3 = tools/PDK missing, 1 = pin drifted
```

followed by the per-bench command in the table below. Each of those commands is checked to appear verbatim in the file named under "documented in", to use only flags its runner actually accepts, and to name the same script the record's own `Written by` footer names.

## Coverage summary

| Spec row | Status | Coverage | Testbench(es) | Evidence record(s) |
|---|---|---|---|---|
| Architecture | DRAFT | benched (structural row, exercised block by block) | `sim/sampling-frontend`<br>`sim/sampling-cdac-handoff`<br>`sim/cdac-array-transfer`<br>`sim/top-plate-cpar`<br>`sim/sar-sequencer-behavioral` | `20260821-072657-433a294.md`<br>`20260824-231304-144edeb.md`<br>`20261001-135431-7487784.md`<br>`20260821-062504-433a294.md`<br>`20261101-183325-60421e38.md`<br>`20260823-152752-47640c8.md` |
| Resolution `N` | RATIFIED | benched (ratified, graded pass/fail) | `sim/sar-sequencer-behavioral` | `20260827-211956-e13bc1e.md` |
| Sample rate | DRAFT | benched (DRAFT row, evidence informational) | `sim/cdac-bit-trial-settling`<br>`sim/sequencer-logic-delay`<br>`sim/sampling-acquisition-settling`<br>`sim/vcm-drive-budget`<br>`sim/input-drive-budget`<br>`sim/reference-drive-budget`<br>`sim/full-conversion-transient`<br>`sim/full-conversion-transient`<br>`sim/full-conversion-transient` | `20261001-140017-7487784.md`<br>`20260906-230516-0904419.md`<br>`20260908-051436-6ccd72d.md`<br>`20260908-100413-f3e2914.md`<br>`20261113-110421-e03343e.md`<br>`20261113-113808-6b72b9f3.md`<br>`20261011-112119-188e94c.md`<br>`20261001-105439-c324f80.md`<br>`20261011-064547-a6dcdd7.md` |
| ENOB | DRAFT | benched (DRAFT row, evidence informational) | `sim/enob-estimate`<br>`sim/full-conversion-transient`<br>`sim/full-conversion-transient`<br>`sim/full-conversion-transient`<br>`sim/full-conversion-transient`<br>`sim/full-conversion-transient` | `20260828-005033-0c70212.md`<br>`20261011-110009-320dbc6.md`<br>`20261010-070734-f968286.md`<br>`20261010-204225-57a55c1.md`<br>`20261011-021527-8d0c19a.md`<br>`20261011-022915-877794b.md`<br>`20261011-023419-877794b.md`<br>`20261011-064924-ad4bfff.md`<br>`20261011-064408-ad4bfff.md` |
| INL / DNL | DRAFT | benched (DRAFT row, evidence informational) | `sim/cdac-array-transfer` | `20261001-124049-5207381.md` |
| `V_REF` | RATIFIED | benched (ratified, graded pass/fail) | `sim/cdac-array-transfer` | `20261001-120402-d24f700.md` |
| LSB (differential) | RATIFIED | benched (ratified, graded pass/fail) | `sim/cdac-array-transfer` | `20261001-120402-d24f700.md` |
| Sampling cap (CDAC unit × array) | RATIFIED | benched (ratified, graded pass/fail) | `sim/cdac-array-transfer` | `20261001-120402-d24f700.md` |
| Comparator input-referred noise | RATIFIED | benched (ratified, graded pass/fail) | `sim/comparator-decision` | `20260827-212404-e13bc1e.md` |
| Kickback | DRAFT | benched (DRAFT row, evidence informational) | `sim/comparator-decision` | `20261106-190623-7bdf8c4.md` |
| Gain error, systematic | DRAFT | NOT benched -- deliberately, see reason | — | — |
| Power | DRAFT | benched (DRAFT row, evidence informational) | `sim/full-conversion-transient`<br>`sim/full-conversion-transient`<br>`sim/full-conversion-transient`<br>`sim/supply-impedance-sensitivity`<br>`sim/supply-impedance-sensitivity`<br>`sim/supply-impedance-sensitivity`<br>`sim/supply-impedance-sensitivity`<br>`sim/supply-impedance-sensitivity`<br>`sim/supply-impedance-sensitivity`<br>`sim/digital-partition` | `20261011-112119-188e94c.md`<br>`20261001-105439-c324f80.md`<br>`20261011-064547-a6dcdd7.md`<br>`20260925-073912-0e385e5.md`<br>`20260925-204633-7339971.md`<br>`20260925-164447-722fcb0.md`<br>`20260926-000929-ce12f9b.md`<br>`20260926-012944-a966fdf.md`<br>`20260926-050045-8e62675.md`<br>`20261010-132019-f757b0e.md` |
| Corners | RATIFIED | benched (methodology row, evidenced by the campaigns that ran it) | `sim/sar-sequencer-behavioral`<br>`sim/cdac-array-transfer`<br>`sim/comparator-decision` | `20260827-211956-e13bc1e.md`<br>`20261001-120402-d24f700.md`<br>`20260827-212404-e13bc1e.md` |

## Per-row detail

### Architecture

- **Status**: DRAFT
- **Claim class**: `structural`
- **Note**: A topology statement (charge-redistribution, differential, top-plate sampling), not a measured quantity: it is realized in design/ and kept honest by design/regen_netlist.sh --check (staleness is failure). The benches below exercise the topology block by block -- none of them asserts a numeric spec value, and none is listed under a numeric row.

**`sim/sampling-frontend`** — Top-plate sampling: in-sample settling and the post-edge delta on TOP_P/TOP_N (issue #52).

- Testbench: `sim/sampling-frontend/testbench/sampling_frontend_dut.spice`
- Runner: `sim/sampling-frontend/run_transient.py`
- Cold start: `python3 sim/sampling-frontend/run_transient.py --record`
- Documented in: `sim/sampling-frontend/run_transient.py`
- Evidence: `sim/sampling-frontend/records/20260821-072657-433a294.md`

**`sim/sampling-cdac-handoff`** — The front-end/array bottom-plate interface as design/sar_adc_top.sch actually wires it (issue #95), and -- at that same assembled top-plate load -- the acquisition residual at the DR-006 worst-case phase budget across the ratified PVT grid (issue #469).

- Testbench: `sim/sampling-cdac-handoff/testbench/sampling_frontend_dut.spice`, `sim/sampling-cdac-handoff/testbench/cdac_array_dut.spice`
- Runner: `sim/sampling-cdac-handoff/run_handoff.py`
- Cold start: `python3 sim/sampling-cdac-handoff/run_handoff.py --corners --record`
- Documented in: `sim/sampling-cdac-handoff/run_handoff.py`
- Evidence: `sim/sampling-cdac-handoff/records/20260824-231304-144edeb.md`
- Evidence: `sim/sampling-cdac-handoff/records/20261001-135431-7487784.md`

**`sim/cdac-array-transfer`** — Charge redistribution: the array's own code-to-output transfer characteristic (issue #53).

- Testbench: `sim/cdac-array-transfer/testbench/tb_cdac_array_transfer.spice`
- Runner: `sim/cdac-array-transfer/run_transfer.py`
- Cold start: `python3 sim/cdac-array-transfer/run_transfer.py --record`
- Documented in: `sim/cdac-array-transfer/README.md`
- Evidence: `sim/cdac-array-transfer/records/20260821-062504-433a294.md`

**`sim/top-plate-cpar`** — Top-plate parasitic capacitance C_par of the as-committed netlist: C(V), leave-one-out composition, per PVT and MiM r+c corner (issue #754; informational, asserts no numeric spec value).

- Testbench: `sim/top-plate-cpar/run_top_plate_cpar.py`
- Deck note: The deck is assembled by the runner from design/sar_adc_top.spice plus testbench-only sources; there is no committed fragment (deck bodies are frozen per record under corners/).
- Runner: `sim/top-plate-cpar/run_top_plate_cpar.py`
- Cold start: `python3 sim/top-plate-cpar/run_top_plate_cpar.py --record`
- Documented in: `sim/top-plate-cpar/README.md`
- Evidence: `sim/top-plate-cpar/records/20261101-183325-60421e38.md`

**`sim/sar-sequencer-behavioral`** — Successive approximation: MSB-first bit-by-bit search and phase sequencing (issue #55).

- Testbench: `sim/sar-sequencer-behavioral/testbench/sar_sequencer_tb_fragment.spice`
- Runner: `sim/sar-sequencer-behavioral/run_testbench.py`
- Cold start: `python3 sim/sar-sequencer-behavioral/run_testbench.py --record`
- Documented in: `sim/sar-sequencer-behavioral/run_testbench.py`
- Evidence: `sim/sar-sequencer-behavioral/records/20260823-152752-47640c8.md`

### Resolution `N`

- **Status**: RATIFIED
- **Claim class**: `ratified-measured`
- **Note**: N = 10 bit, RATIFIED (DR-003 via #27). Graded by issue #28's full ratified-corner campaign: correct MSB-first capture of all 10 bits, correct phase sequencing, and the ring sequencer's auto-restart at every point of the ratified corner set.

**`sim/sar-sequencer-behavioral`** — Ratified N=10 across the full ratified corner set (issue #28).

- Testbench: `sim/sar-sequencer-behavioral/testbench/sar_sequencer_tb_fragment.spice`
- Runner: `sim/sar-sequencer-behavioral/run_testbench.py`
- Cold start: `python3 sim/sar-sequencer-behavioral/run_testbench.py --corners --record`
- Documented in: `sim/sar-sequencer-behavioral/run_testbench.py`
- Evidence: `sim/sar-sequencer-behavioral/records/20260827-211956-e13bc1e.md`
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
