2AMLogic/sky130-sar-adc/sim/yield-requirements.txt

# Pinned klayout-tools (`klt`) build + extra expected to MINT `klt yield`
# envelopes (issue #625). Third pin, deliberately separate from
# layout/requirements.txt (mints layout evidence) and signoff/requirements.txt
# (grades the manifest): it only runs the statistical yield step over the
# persisted samples documents under sim/*/yield-reports/*.samples.json.
#
#   python3 -m venv .venv-yield
#   .venv-yield/bin/pip install -r sim/yield-requirements.txt
#   .venv-yield/bin/klt yield <samples.json> --format json
#
# STATUS AS OF 2026-11-06: THIS PIN RESOLVES. klayout-tools 0.8.0 declares extra
# `yield` -> `klt-yield-native>=0.1.0,<0.2`, and klt-yield-native 0.1.0 (published
# to PyPI 2026-11-05) installed in a fresh venv from this file; `klt yield` ran
# and minted sim/enob-estimate/yield-reports/20261008-233032-8bc3d1f.json (issue
# #803). Without the native extension `klt yield` returns "the klt_yield_native
# extension is not installed", and sim/harness/evidence.py:run_klt_yield()
# records no verdict. This file is the checked statement of what to install;
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
