2AMLogic/sky130-sar-adc/docs/characterization-report-digital.md

# sky130-sar-adc — Digital Partition Characterization

Generated by `sim/report/generate.py` from the immutable digital-partition campaign (`sim/digital-partition/`). **Do not hand-edit.** Regenerate with `python3 sim/report/generate.py --write`; `--check` (wired into `npm run check:report`) fails if this file drifted, the cited record was superseded, or the partition netlist / routed layout changed without a regenerated campaign.

This document backs T1 item 8's *digital* requirement (Fmax, area and power across the corner set). It characterizes the **digital partition only**: the walking-one ring sequencer / 10-bit register plus the top-level standard-cell glue named in `signoff/block-manifest.json`. **A digital clock-frequency bracket is not the ADC's conversion capability or sample rate**, which also depend on the sampling front end, the CDAC settling and the comparator decision time and remain governed by the analog report (`docs/characterization-report.md`) and the still-DRAFT sample-rate row.

Evidence: [`sim/digital-partition/records/20261010-132019-f757b0e.md`](../sim/digital-partition/records/20261010-132019-f757b0e.md) (raw reports and decks under `sim/digital-partition/corners/20261010-132019-f757b0e/`, machine-readable results in `sim/digital-partition/runs/20261010-132019-f757b0e/campaign.json`).

**Item-8 digital checklist (corner coverage, Fmax bracket or declared lower bound, power, area, negative control): MET.**

## Frequency bracket (functional limit of the digital partition)

Search grid 12 MHz x 2^(i/8) (adjacent points 9.05 % apart = the declared tolerance), ceiling 1536 MHz. A censored row is a **lower bound**, not an Fmax.

| Corner | State | Highest passing (MHz) | Next failing (MHz) | Non-monotone |
|---|---|---:|---:|---|
| `ff_27c_1.80v` | bracket | 913.31 | 995.97 | no |
| `fs_27c_1.80v` | bracket | 768.00 | 837.51 | no |
| `sf_27c_1.80v` | bracket | 645.81 | 704.26 | no |
| `ss_27c_1.80v` | bracket | 543.06 | 592.21 | no |
| `tt_-40c_1.80v` | bracket | 704.26 | 768.00 | no |
| `tt_125c_1.80v` | bracket | 768.00 | 837.51 | no |
| `tt_27c_1.62v` | bracket | 592.21 | 645.81 | no |
| `tt_27c_1.80v` | bracket | 704.26 | 768.00 | no |
| `tt_27c_1.98v` | bracket | 837.51 | 913.31 | no |

Negative control (6000 MHz, far too fast): graded FAIL at every corner, as required.

## Power and energy at the provisional 12 MHz operating point

| Corner | Functional | P_active (uW) | P_idle/reset (uW) | E/conversion (pJ) |
|---|---|---:|---:|---:|
| `ff_27c_1.80v` | yes | 10.978 | 6.723 | 10.978 |
| `fs_27c_1.80v` | yes | 10.444 | 6.299 | 10.444 |
| `sf_27c_1.80v` | yes | 10.720 | 6.624 | 10.720 |
| `ss_27c_1.80v` | yes | 10.188 | 6.192 | 10.188 |
| `tt_-40c_1.80v` | yes | 10.276 | 6.277 | 10.276 |
| `tt_125c_1.80v` | yes | 11.077 | 6.779 | 11.077 |
| `tt_27c_1.62v` | yes | 8.333 | 5.073 | 8.333 |
| `tt_27c_1.80v` | yes | 10.548 | 6.441 | 10.548 |
| `tt_27c_1.98v` | yes | 13.131 | 8.043 | 13.131 |

Digital rail `VPWR` (positive) against `VGND`; declared interface loads and a deterministic four-conversion COMP_OUT pattern; input-driver energy is outside the boundary. Full statement of loads, windows and switching pattern is in the record.

## Area (routed artifacts; geometry, not corner-dependent)

- Composed footprint (bounding box of the two placed macros): 9663.8 um^2
- Macro area (sum of the two DEF die areas; macros proven disjoint): 6975.3 um^2
- Placed-cell area (LEF footprints, incl. fill/tap): 5734.2 um^2; logic cells only: 925.9 um^2

## Declared limitations

- Schematic-level transistor SPICE; no extracted parasitics, no routing RC. Not extracted timing and not static timing analysis; full-block post-layout verification remains separate.
- Loads and COMP_OUT arrival are experiment assumptions, not ratified spec values; the 12 MHz point is the provisional DR-006-derived planning figure and the sample-rate target remains DRAFT.
- Interface loads (experiment assumptions, not spec values): PH_SAMPLE 20 fF, PH_PHASE 5 fF, BUSY 5 fF, DOUT 5 fF, SEL 20 fF, CLKN 50 fF, HALF_LSB 20 fF, ADCOUT 10 fF. Their switching energy is inside the power figures; the bracket holds only under these loads.
- COMP_OUT is an ideal source that changes 0.25 T after each launching edge; the comparator decision time is not included, so the bracket is not valid for a later COMP_OUT arrival.
- Code coverage: only the codes 811, 212, 682, 341 are exercised; the all-ones and all-zeros codes are NOT exercised.
- Reset coverage: the power-up reset state, its release and the automatic restart after each conversion. No mid-conversion asynchronous reset is injected, so reset behaviour during a conversion is NOT characterized.
- Idle/reset power is measured with RST_B asserted and the clock running; clock-stopped static leakage is NOT measured.
- Execution: fleet runner klt 0.5.0 vs submitting client klt 0.7.0+g8eec069c7576 (run with `batch.runner_version_check: warn`); see the record's version-skew section.
- Pass means every sampled check held 0.9 T after each launching edge for every one of the four conversions.

## Pins

- PDK: `sky130A @ c6d73a35f524070e85faff4a6a9eef49553ebc2b`
- design/sar_adc_top.sch sha256: `sha256:fbd3643f1988a5ed243a1f14d67251640272dd8ca2d923b69bc907179e0b9fc8`
- design/sar_adc_top.spice sha256 (informational; whole file incl. analog): `sha256:3a519b41e0bea4e82ec20828066ea31d123fe6879d922077ab0c0c5eec0d83e6`
- design/sar_sequencer.sch sha256: `sha256:9d76813255ceb43a7f2dcde6cba04d6396cb9e7767c3e0f2cce178b5db849999`
- digital deck generator sha256 (informational): `sha256:fc70c53ac4f9f79919f9217d456550d21787dd66371e76225b10c07637db91a2`
- digital partition netlist sha256: `sha256:31e3fa2611279013e630c589eeda151b278b6ab0ece7729242e684121df1fdfc`
- frequency grid: `12 MHz x 2^(i/8), ceiling index 56`
- netlist-snapshot sha256: `sha256:faab644936395dadf30eea0d81d4331823ad647f44f0c029c65cbb22ded7cd99`
