2AMLogic/sky130-sar-adc/docs/klt-0.8.0-evaluation/note-20261027.md

# klayout-tools 0.8.0 pin bump (issue #727)

Dated 2026-10-27. Runs used a throwaway venv (`pip install klayout-tools==0.8.0`,
`klt --version` printed `klt 0.8.0`); single-unit runs only, no SPICE.

## What moved, what did not

| pin | before | after | why |
|---|---|---|---|
| `signoff/requirements.txt`, `signoff/run-signoff.sh` | 0.6.0 | **0.8.0** | grader; verdicts unchanged (below) |
| `layout/erc-requirements.txt` | 0.7.0 | **0.8.0** | ERC reads a GDS + JSON spec only; no DRC deck involved |
| `sim/yield-requirements.txt` | `[yield]==0.7.0` | `[yield]==0.8.0` | not a batch-client pin; still unresolvable (below) |
| `layout/requirements.txt` | 0.6.0 | **0.6.0 (held)** | 0.8.0 DRC is not clean (below) |

## Signoff grading (0.6.0 -> 0.8.0)

`klt signoff --manifest signoff/block-manifest.json --check` under 0.8.0 on the
unchanged 0.6.0-era report: `status: match`, `doc_drift: true` (checklist
wording only). `signoff/t1-report.json` was then re-rendered. Comparing the old
and new report item by item, every field other than `text`/`notes` is equal
(25 items, same ids); the top-level fields other than `build`, `items` and
`source_doc_content_hash` are equal. Changed: `build` (0.8.0, `v0.8.0`),
`grading_ruleset_id` `sha256:0d8cc27c...` -> `sha256:46c446d8...`,
`source_doc_content_hash` `sha256:63eeec72...` -> `sha256:a26b9026...`, and
descriptive text. `signoff/check_evidence_hashes.py` still passes.
`signoff/evidence/characterization-report.generic.json` was not regenerated:
the `--check` above passes with it unchanged.

## `klt drc --deck sky130` on the top-level streams (0.8.0, deck hash `sha256:ba0f9788...`, released)

| stream | 0.6.0 (cited) | 0.7.0 (#649 note) | 0.8.0 |
|---|---|---|---|
| `20261001-211249-1ca34e6` (item 3's stream) | 0 | 32726 | **34211** |
| `20261003-041400-571f036` (LATEST) | 0 | 10 | **1495** |

Breakdown of the 0.8.0 findings by rule: first stream: `*.ongrid.1` 32716,
`met2.enclosing_adjacent.via2.1` 1171, `met1.enclosing_adjacent.via.1` 157,
`poly.endcap.diff.1` 91, `met2.enclosing_adjacent.via.1` 66, `via3.width.1` 10.
LATEST stream: the same without the ongrid family. The three
`*.enclosing_adjacent.*` families and `poly.endcap.diff.1` did not appear in the
0.7.0 note's summary of these streams. This note did not triage any of them or
establish whether they are deck changes or real drawn-geometry findings.
**`layout/requirements.txt` therefore stays at 0.6.0**; no spec line was touched.
The LATEST-stream envelope is stored as
`drc-klt-0.8.0.superseding-gds.json` (1.1 MB); the first stream's envelope
(17.7 MB, sha256 `7ac8e4c65fd9baf3...`) is not committed.

## `sim/yield-requirements.txt`

Not a batch-runner pin (its header concerns resolvability). The string moved to
0.8.0, but per the PyPI metadata for 0.8.0 the `yield` extra still requires
`klt-yield-native<0.2,>=0.1.0`; I did not test whether it resolves, so the file's
"does not yet resolve" status is unchanged and unverified for 0.8.0.

## `supply_v` audit (klayout-tools#2867)

Scope: the 17 committed `sim/**/request*.json` files. Every `corners.supply_v`
dict key in them is `vdig` (351 occurrences) and the netlists they reference
contain a voltage source `Vdig` (`Vdig VPWR 0 DC 1.8`; checked by grep, not by
running `klt sim`). Zero keys found that do not name a voltage source. The other
`"supply_v"` hits in `.py` harness files are Python dict keys, not klt request
keys; those were not individually audited. No SPICE was run.

## Not checked

`combine_devices` LVS uses and the `klt artifact` call sites
(`sim/check_artifact_manifests.py` is a stdlib twin and does not call klt) were
not re-run; no LVS was re-run under 0.8.0.
