2AMLogic/sky130-sar-adc/sim/sar-sequencer-behavioral/testbench/sar_sequencer_tb_fragment.spice

* sar_sequencer_tb_fragment.spice -- standalone behavioral testbench
* fragment for design/sar_sequencer.sch (issue #55). Devices/sources only;
* sim/sar-sequencer-behavioral/run_testbench.py supplies the model .lib,
* the sky130_fd_sc_hd combined-cell .include, the freshly-netlisted DUT
* body, and the closing .end -- see that script and sim/README.md
* 'Divergence from the shared PVT/MC harness' note in this experiment's
* own record for why this experiment does not go through
* sim/run_corners.py (that harness's .control block only supports .op
* analysis; this is a transient/digital sequencing check).
*
* Drives an IDEAL comparator-decision stimulus (COMP_OUT) against the
* DUT's CLK/RST_B inputs and exercises two full back-to-back conversions
* with two different fixed target codes, proving MSB-first bit-by-bit
* capture, phase timing, and the ring sequencer's auto-restart.
*
* CLK: 100 ns period (f_clk=10 MHz; DR-006's derived provisional range is
* 1.2-12 MHz). RST_B releases at t=220 ns (before the first rising edge
* at t=250 ns).
* Cycle 1 target code (b9..b0) = 1100101011b = 811 decimal
* Cycle 2 target code (b9..b0) = 0011010100b = 212 decimal
*
* UPDATE (#263): design/sar_sequencer.sch now derives each bit-8..0
* decision from COMP_EFF = XNOR(COMP_OUT, DOUT9), not raw COMP_OUT --
* DOUT9 (this design's free sign bit, decided first with no trial
* perturbation, unaffected by this change) selects which single CDAC side
* each subsequent bit's trial perturbation switches (design/sar_adc_top.sch),
* and the comparator's fixed polarity means "keep the trial" is COMP_OUT=1
* for the DOUT9=1 branch but COMP_OUT=0 for the DOUT9=0 branch -- see
* design/sar_sequencer.sch's own "COMP_EFF" header comment for the full
* derivation. Cycle 1's target code has b9=1, so COMP_EFF=COMP_OUT
* (passthrough) throughout cycle 1 and its stimulus below is UNCHANGED
* (bit i's driven COMP_OUT level already equals its target bit, exactly as
* before this issue). Cycle 2's target code has b9=0, so COMP_EFF=NOT
* (COMP_OUT) for its bit8..0 windows: the driven COMP_OUT level for each of
* those nine windows is the CODE2 target bit INVERTED (bit9's own window is
* unaffected, same direct-capture convention as cycle 1's). EXPECTED_BITS
* in run_testbench.py is unchanged by this -- it still asserts the CODE1/
* CODE2 TARGET values; only what COMP_OUT must be DRIVEN AT to produce that
* target under the new decision-directed logic changed here.
*
* Rail-referenced via the {vdd_val} .param (issue #28's PVT corner
* campaign): the caller (sim/sar-sequencer-behavioral/run_testbench.py)
* supplies `.param vdd_val = <supply_v>` ahead of this fragment so the
* supply axis of the ratified corner set (-40/27/125C, +-10% of 1.8V,
* sky130 process corners -- spec/target-spec.md) can be swept without
* editing this file per corner point.

VVPWR VPWR 0 DC {vdd_val}
VVGND VGND 0 DC 0

VCLK CLK 0 PULSE(0 {vdd_val} 50n 1n 1n 50n 100n)
VRSTB RST_B 0 PWL(0 0 219n 0 221n {vdd_val} 2700n {vdd_val})
VCOMP COMP_OUT 0 PWL(0.0n 0.00 269.9n 0.00 270.1n {vdd_val} 369.9n {vdd_val} 370.1n {vdd_val} 469.9n {vdd_val} 470.1n 0.00 569.9n 0.00 570.1n 0.00 669.9n 0.00 670.1n {vdd_val} 769.9n {vdd_val} 770.1n 0.00 869.9n 0.00 870.1n {vdd_val} 969.9n {vdd_val} 970.1n 0.00 1069.9n 0.00 1070.1n {vdd_val} 1169.9n {vdd_val} 1170.1n {vdd_val} 1469.9n {vdd_val} 1470.1n 0.00 1569.9n 0.00 1570.1n {vdd_val} 1669.9n {vdd_val} 1670.1n 0.00 1769.9n 0.00 1770.1n 0.00 1869.9n 0.00 1870.1n {vdd_val} 1969.9n {vdd_val} 1970.1n 0.00 2069.9n 0.00 2070.1n {vdd_val} 2169.9n {vdd_val} 2170.1n 0.00 2269.9n 0.00 2270.1n {vdd_val} 2369.9n {vdd_val} 2370.1n {vdd_val} 2700.0n {vdd_val})

.tran 0.5n 2700n

* --- cycle 1: full phase-timing coverage + all 10 captured bits ---
.meas tran phsample_c1 find v(ph_sample) at=200.0n
.meas tran phb9_c1 find v(ph_b9) at=300.0n
.meas tran phb8_c1 find v(ph_b8) at=400.0n
.meas tran phb7_c1 find v(ph_b7) at=500.0n
.meas tran phb6_c1 find v(ph_b6) at=600.0n
.meas tran phb5_c1 find v(ph_b5) at=700.0n
.meas tran phb4_c1 find v(ph_b4) at=800.0n
.meas tran phb3_c1 find v(ph_b3) at=900.0n
.meas tran phb2_c1 find v(ph_b2) at=1000.0n
.meas tran phb1_c1 find v(ph_b1) at=1100.0n
.meas tran phb0_c1 find v(ph_b0) at=1200.0n
.meas tran pheoc_c1 find v(ph_eoc) at=1300.0n
.meas tran dout9_c1 find v(dout9) at=1300.0n
.meas tran dout8_c1 find v(dout8) at=1300.0n
.meas tran dout7_c1 find v(dout7) at=1300.0n
.meas tran dout6_c1 find v(dout6) at=1300.0n
.meas tran dout5_c1 find v(dout5) at=1300.0n
.meas tran dout4_c1 find v(dout4) at=1300.0n
.meas tran dout3_c1 find v(dout3) at=1300.0n
.meas tran dout2_c1 find v(dout2) at=1300.0n
.meas tran dout1_c1 find v(dout1) at=1300.0n
.meas tran dout0_c1 find v(dout0) at=1300.0n
.meas tran dout9_early_c1 find v(dout9) at=400.0n

* --- cycle 2: abbreviated phase coverage (proves auto-restart timing) ---
* --- + all 10 captured bits (proves a DIFFERENT code converts correctly) ---
.meas tran phb9_c2 find v(ph_b9) at=1500.0n
.meas tran pheoc_c2 find v(ph_eoc) at=2500.0n
.meas tran dout9_c2 find v(dout9) at=2500.0n
.meas tran dout8_c2 find v(dout8) at=2500.0n
.meas tran dout7_c2 find v(dout7) at=2500.0n
.meas tran dout6_c2 find v(dout6) at=2500.0n
.meas tran dout5_c2 find v(dout5) at=2500.0n
.meas tran dout4_c2 find v(dout4) at=2500.0n
.meas tran dout3_c2 find v(dout3) at=2500.0n
.meas tran dout2_c2 find v(dout2) at=2500.0n
.meas tran dout1_c2 find v(dout1) at=2500.0n
.meas tran dout0_c2 find v(dout0) at=2500.0n
