2AMLogic/sky130-sar-adc/layout/sar-adc-top/reports/20261027-183429-b96026c2/sar_adc_top.extract.lvs.spice

* extracted by klt extract --deck sky130

* cell gen_compose_0
* pin A,A0,B,DOUT0,Q
* pin A,A0,B,DOUT1,Q
* pin A,A0,B,DOUT2,Q
* pin A,A0,B,DOUT3,Q
* pin A,A0,B,DOUT4,Q
* pin A,A0,B,DOUT5,Q
* pin A,A0,B,DOUT6,Q
* pin A,A0,B,DOUT7,Q
* pin A,A0,B,DOUT8,Q
* pin A,A0,B,DOUT9,Q
* pin A,B,BUSY,X
* pin A,CLK
* pin GND,VGND,VSS
* pin RESET_B,RST_B
* pin VCM
* pin VDD
* pin VINN
* pin VINP
* pin VPB,VPWR
* pin VREFN
* pin VREFP
.SUBCKT gen_compose_0 A|A0|B|DOUT0|Q A|A0|B|DOUT1|Q A|A0|B|DOUT2|Q
+ A|A0|B|DOUT3|Q A|A0|B|DOUT4|Q A|A0|B|DOUT5|Q A|A0|B|DOUT6|Q A|A0|B|DOUT7|Q
+ A|A0|B|DOUT8|Q A|A0|B|DOUT9|Q A|B|BUSY|X A|CLK GND|VGND|VSS RESET_B|RST_B VCM
+ VDD VINN VINP VPB|VPWR VREFN VREFP
* device instance $1 r0 *1 51.95,-146.835 nfet
M$1 GND|VGND|VSS A|CLK|X \$3 GND|VGND|VSS nfet L=0.15U W=0.42U AS=0.1092P
+ AD=0.0567P PS=1.36U PD=0.69U
* device instance $2 r0 *1 52.37,-146.835 nfet
M$2 \$4 \$3 GND|VGND|VSS GND|VGND|VSS nfet L=0.15U W=0.42U AS=0.0567P
+ AD=0.1092P PS=0.69U PD=1.36U
* device instance $3 r0 *1 54.12,-146.865 nfet
M$3 \$7 \$3 \$6 GND|VGND|VSS nfet L=0.15U W=0.36U AS=0.066P AD=0.0594P
+ PS=0.745U PD=0.69U
* device instance $4 r0 *1 54.6,-146.865 nfet
M$4 \$13 \$4 \$7 GND|VGND|VSS nfet L=0.15U W=0.36U AS=0.0594P AD=0.1401P
+ PS=0.69U PD=1.1U
* device instance $5 r0 *1 56.945,-146.865 nfet
M$5 \$10 \$4 \$9 GND|VGND|VSS nfet L=0.15U W=0.36U AS=0.0999P AD=0.0711P
+ PS=0.985U PD=0.755U
* device instance $6 r0 *1 57.49,-146.865 nfet
M$6 \$15 \$3 \$10 GND|VGND|VSS nfet L=0.15U W=0.36U AS=0.0711P AD=0.0669P
+ PS=0.755U PD=0.75U
* device instance $7 r0 *1 53.645,-146.835 nfet
M$7 \$6 B|D|PH_B8|Q|S GND|VGND|VSS GND|VGND|VSS nfet L=0.15U W=0.42U AS=0.2205P
+ AD=0.066P PS=1.89U PD=0.745U
* device instance $8 r0 *1 55.43,-146.835 nfet
M$8 \$14 \$9 \$13 GND|VGND|VSS nfet L=0.15U W=0.42U AS=0.1401P AD=0.0441P
+ PS=1.1U PD=0.63U
* device instance $9 r0 *1 55.79,-146.835 nfet
M$9 GND|VGND|VSS RESET_B|RST_B \$14 GND|VGND|VSS nfet L=0.15U W=0.42U
+ AS=0.0441P AD=0.1346P PS=0.63U PD=1.15U
* device instance $10 r0 *1 57.97,-146.835 nfet
M$10 GND|VGND|VSS \$11 \$15 GND|VGND|VSS nfet L=0.15U W=0.42U AS=0.0669P
+ AD=0.12495P PS=0.75U PD=1.015U
* device instance $11 r0 *1 58.715,-146.835 nfet
M$11 \$16 RESET_B|RST_B GND|VGND|VSS GND|VGND|VSS nfet L=0.15U W=0.42U
+ AS=0.12495P AD=0.06405P PS=1.015U PD=0.725U
* device instance $12 r0 *1 59.17,-146.835 nfet
M$12 \$11 \$10 \$16 GND|VGND|VSS nfet L=0.15U W=0.42U AS=0.06405P AD=0.1092P
+ PS=0.725U PD=1.36U
* device instance $13 r0 *1 56.45,-146.725 nfet
M$13 \$9 \$7 GND|VGND|VSS GND|VGND|VSS nfet L=0.15U W=0.64U AS=0.1346P
+ AD=0.0999P PS=1.15U PD=0.985U
* device instance $14 r0 *1 60.21,-146.72 nfet
M$14 C|D|PH_B7|Q|S \$11 GND|VGND|VSS GND|VGND|VSS nfet L=0.15U W=0.65U
+ AS=0.2087P AD=0.169P PS=2.02U PD=1.82U
* device instance $15 r0 *1 35.39,-142.285 nfet
M$15 GND|VGND|VSS A|CLK|X \$18 GND|VGND|VSS nfet L=0.15U W=0.42U AS=0.1092P
+ AD=0.0567P PS=1.36U PD=0.69U
* device instance $16 r0 *1 35.81,-142.285 nfet
M$16 \$19 \$18 GND|VGND|VSS GND|VGND|VSS nfet L=0.15U W=0.42U AS=0.0567P
+ AD=0.1092P PS=0.69U PD=1.36U
* device instance $17 r0 *1 37.085,-142.285 nfet
M$17 \$21 D|X GND|VGND|VSS GND|VGND|VSS nfet L=0.15U W=0.42U AS=0.2205P
+ AD=0.066P PS=1.89U PD=0.745U
* device instance $18 r0 *1 37.56,-142.255 nfet
M$18 \$22 \$18 \$21 GND|VGND|VSS nfet L=0.15U W=0.36U AS=0.066P AD=0.0594P
+ PS=0.745U PD=0.69U
* device instance $19 r0 *1 38.04,-142.255 nfet
M$19 \$22 \$19 \$38 GND|VGND|VSS nfet L=0.15U W=0.36U AS=0.1401P AD=0.0594P
+ PS=1.1U PD=0.69U
* device instance $20 r0 *1 38.87,-142.285 nfet
M$20 \$39 \$25 \$38 GND|VGND|VSS nfet L=0.15U W=0.42U AS=0.1401P AD=0.0441P
+ PS=1.1U PD=0.63U
* device instance $21 r0 *1 39.23,-142.285 nfet
M$21 \$39 RESET_B|RST_B GND|VGND|VSS GND|VGND|VSS nfet L=0.15U W=0.42U
+ AS=0.1346P AD=0.0441P PS=1.15U PD=0.63U
* device instance $22 r0 *1 39.89,-142.395 nfet
M$22 \$25 \$22 GND|VGND|VSS GND|VGND|VSS nfet L=0.15U W=0.64U AS=0.1346P
+ AD=0.0999P PS=1.15U PD=0.985U
* device instance $23 r0 *1 40.385,-142.255 nfet
M$23 \$26 \$19 \$25 GND|VGND|VSS nfet L=0.15U W=0.36U AS=0.0999P AD=0.0711P
+ PS=0.985U PD=0.755U
* device instance $24 r0 *1 40.93,-142.255 nfet
M$24 \$26 \$18 \$40 GND|VGND|VSS nfet L=0.15U W=0.36U AS=0.0669P AD=0.0711P
+ PS=0.75U PD=0.755U
* device instance $25 r0 *1 41.41,-142.285 nfet
M$25 GND|VGND|VSS \$27 \$40 GND|VGND|VSS nfet L=0.15U W=0.42U AS=0.0669P
+ AD=0.12495P PS=0.75U PD=1.015U
* device instance $26 r0 *1 42.155,-142.285 nfet
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
* device instance $92 r0 *1 42.62,-135.985 nfet
M$92 \$115 \$112 \$114 GND|VGND|VSS nfet L=0.15U W=0.36U AS=0.066P AD=0.0594P
+ PS=0.745U PD=0.69U
* device instance $93 r0 *1 43.1,-135.985 nfet
M$93 \$132 \$113 \$115 GND|VGND|VSS nfet L=0.15U W=0.36U AS=0.0594P AD=0.1401P
+ PS=0.69U PD=1.1U
* device instance $94 r0 *1 45.445,-135.985 nfet
M$94 \$118 \$113 \$117 GND|VGND|VSS nfet L=0.15U W=0.36U AS=0.0999P AD=0.0711P
+ PS=0.985U PD=0.755U
* device instance $95 r0 *1 45.99,-135.985 nfet
M$95 \$133 \$112 \$118 GND|VGND|VSS nfet L=0.15U W=0.36U AS=0.0711P AD=0.0669P
+ PS=0.755U PD=0.75U
* device instance $96 r0 *1 42.145,-135.955 nfet
M$96 \$114 D|PH_B6|Q|S GND|VGND|VSS GND|VGND|VSS nfet L=0.15U W=0.42U
+ AS=0.2205P AD=0.066P PS=1.89U PD=0.745U
* device instance $97 r0 *1 43.93,-135.955 nfet
M$97 \$131 \$117 \$132 GND|VGND|VSS nfet L=0.15U W=0.42U AS=0.1401P AD=0.0441P
+ PS=1.1U PD=0.63U
* device instance $98 r0 *1 44.29,-135.955 nfet
M$98 GND|VGND|VSS RESET_B|RST_B \$131 GND|VGND|VSS nfet L=0.15U W=0.42U
+ AS=0.0441P AD=0.1346P PS=0.63U PD=1.15U
* device instance $99 r0 *1 46.47,-135.955 nfet
M$99 GND|VGND|VSS \$119 \$133 GND|VGND|VSS nfet L=0.15U W=0.42U AS=0.0669P
+ AD=0.12495P PS=0.75U PD=1.015U
* device instance $100 r0 *1 47.215,-135.955 nfet
M$100 \$134 RESET_B|RST_B GND|VGND|VSS GND|VGND|VSS nfet L=0.15U W=0.42U
+ AS=0.12495P AD=0.06405P PS=1.015U PD=0.725U
* device instance $101 r0 *1 47.67,-135.955 nfet
M$101 \$119 \$118 \$134 GND|VGND|VSS nfet L=0.15U W=0.42U AS=0.06405P
+ AD=0.1092P PS=0.725U PD=1.36U
* device instance $102 r0 *1 44.95,-135.845 nfet
M$102 \$117 \$115 GND|VGND|VSS GND|VGND|VSS nfet L=0.15U W=0.64U AS=0.1346P
+ AD=0.0999P PS=1.15U PD=0.985U
* device instance $103 r0 *1 44.59,-136.96 nfet
M$103 GND|VGND|VSS A|X$1 \$84 GND|VGND|VSS nfet L=0.15U W=0.65U AS=0.169P
+ AD=0.08775P PS=1.82U PD=0.92U
* device instance $104 r0 *1 45.01,-136.96 nfet
M$104 A|CLK|X \$84 GND|VGND|VSS GND|VGND|VSS nfet L=0.15U W=0.65U AS=0.08775P
+ AD=0.08775P PS=0.92U PD=0.92U
* device instance $105 r0 *1 45.43,-136.96 nfet
M$105 GND|VGND|VSS \$84 A|CLK|X GND|VGND|VSS nfet L=0.15U W=0.65U AS=0.08775P
+ AD=0.08775P PS=0.92U PD=0.92U
* device instance $106 r0 *1 45.85,-136.96 nfet
M$106 A|CLK|X \$84 GND|VGND|VSS GND|VGND|VSS nfet L=0.15U W=0.65U AS=0.08775P
+ AD=0.08775P PS=0.92U PD=0.92U
* device instance $107 r0 *1 46.27,-136.96 nfet
M$107 GND|VGND|VSS \$84 A|CLK|X GND|VGND|VSS nfet L=0.15U W=0.65U AS=0.08775P
+ AD=0.169P PS=0.92U PD=1.82U
* device instance $108 r0 *1 48.71,-135.84 nfet
M$108 A|D|PH_B5|Q|S \$119 GND|VGND|VSS GND|VGND|VSS nfet L=0.15U W=0.65U
+ AS=0.2087P AD=0.169P PS=2.02U PD=1.82U
* device instance $109 r0 *1 50.57,-135.955 nfet
M$109 GND|VGND|VSS A|CLK|X \$121 GND|VGND|VSS nfet L=0.15U W=0.42U AS=0.1092P
+ AD=0.0567P PS=1.36U PD=0.69U
* device instance $110 r0 *1 50.99,-135.955 nfet
M$110 \$122 \$121 GND|VGND|VSS GND|VGND|VSS nfet L=0.15U W=0.42U AS=0.0567P
+ AD=0.1092P PS=0.69U PD=1.36U
* device instance $111 r0 *1 51.95,-136.96 nfet
M$111 GND|VGND|VSS \$86 D|X$3 GND|VGND|VSS nfet L=0.15U W=0.65U AS=0.169P
+ AD=0.11285P PS=1.82U PD=1.045U
* device instance $112 r0 *1 52.495,-136.845 nfet
M$112 \$100 C|D|PH_B7|Q|S GND|VGND|VSS GND|VGND|VSS nfet L=0.15U W=0.42U
+ AS=0.11285P AD=0.0693P PS=1.045U PD=0.75U
* device instance $113 r0 *1 52.975,-136.845 nfet
M$113 \$86 A1|COMP_OUT|OUTP \$100 GND|VGND|VSS nfet L=0.15U W=0.42U AS=0.0693P
+ AD=0.09975P PS=0.75U PD=0.895U
* device instance $114 r0 *1 53.6,-136.845 nfet
M$114 \$102 A|A0|B|DOUT7|Q \$86 GND|VGND|VSS nfet L=0.15U W=0.42U AS=0.09975P
+ AD=0.0693P PS=0.895U PD=0.75U
* device instance $115 r0 *1 54.08,-136.845 nfet
M$115 GND|VGND|VSS \$88 \$102 GND|VGND|VSS nfet L=0.15U W=0.42U AS=0.0693P
+ AD=0.1449P PS=0.75U PD=1.11U
* device instance $116 r0 *1 54.92,-136.845 nfet
M$116 \$88 C|D|PH_B7|Q|S GND|VGND|VSS GND|VGND|VSS nfet L=0.15U W=0.42U
+ AS=0.1449P AD=0.1092P PS=1.11U PD=1.36U
* device instance $117 r0 *1 52.74,-135.985 nfet
M$117 \$124 \$121 \$123 GND|VGND|VSS nfet L=0.15U W=0.36U AS=0.066P AD=0.0594P
+ PS=0.745U PD=0.69U
* device instance $118 r0 *1 53.22,-135.985 nfet
M$118 \$135 \$122 \$124 GND|VGND|VSS nfet L=0.15U W=0.36U AS=0.0594P AD=0.1401P
+ PS=0.69U PD=1.1U
* device instance $119 r0 *1 55.565,-135.985 nfet
M$119 \$127 \$122 \$126 GND|VGND|VSS nfet L=0.15U W=0.36U AS=0.0999P AD=0.0711P
+ PS=0.985U PD=0.755U
* device instance $120 r0 *1 56.11,-135.985 nfet
M$120 \$137 \$121 \$127 GND|VGND|VSS nfet L=0.15U W=0.36U AS=0.0711P AD=0.0669P
+ PS=0.755U PD=0.75U
* device instance $121 r0 *1 52.265,-135.955 nfet
M$121 \$123 A|A_N|D|PH_B9|Q|S GND|VGND|VSS GND|VGND|VSS nfet L=0.15U W=0.42U
+ AS=0.2205P AD=0.066P PS=1.89U PD=0.745U
* device instance $122 r0 *1 54.05,-135.955 nfet
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
M$149 \$176 A1|COMP_OUT|OUTP \$190 GND|VGND|VSS nfet L=0.15U W=0.42U AS=0.0693P
+ AD=0.09975P PS=0.75U PD=0.895U
* device instance $150 r0 *1 35.2,-130.515 nfet
M$150 \$193 A|A0|B|DOUT2|Q \$176 GND|VGND|VSS nfet L=0.15U W=0.42U AS=0.09975P
+ AD=0.0693P PS=0.895U PD=0.75U
* device instance $151 r0 *1 35.68,-130.515 nfet
M$151 GND|VGND|VSS \$178 \$193 GND|VGND|VSS nfet L=0.15U W=0.42U AS=0.0693P
+ AD=0.1449P PS=0.75U PD=1.11U
* device instance $152 r0 *1 36.52,-130.515 nfet
M$152 \$178 D|PH_B2|Q|S GND|VGND|VSS GND|VGND|VSS nfet L=0.15U W=0.42U
+ AS=0.1449P AD=0.1092P PS=1.11U PD=1.36U
* device instance $153 r0 *1 33.55,-130.4 nfet
M$153 GND|VGND|VSS \$176 D|X$5 GND|VGND|VSS nfet L=0.15U W=0.65U AS=0.169P
+ AD=0.11285P PS=1.82U PD=1.045U
* device instance $154 r0 *1 38.13,-131.52 nfet
M$154 A|A0|B|DOUT2|Q \$151 GND|VGND|VSS GND|VGND|VSS nfet L=0.15U W=0.65U
+ AS=0.2087P AD=0.169P PS=2.02U PD=1.82U
* device instance $155 r0 *1 40.45,-130.4 nfet
M$155 GND|VGND|VSS A|CLK \$180 GND|VGND|VSS nfet L=0.15U W=0.65U AS=0.169P
+ AD=0.08775P PS=1.82U PD=0.92U
* device instance $156 r0 *1 40.87,-130.4 nfet
M$156 A|X$1 \$180 GND|VGND|VSS GND|VGND|VSS nfet L=0.15U W=0.65U AS=0.08775P
+ AD=0.08775P PS=0.92U PD=0.92U
* device instance $157 r0 *1 41.29,-130.4 nfet
M$157 GND|VGND|VSS \$180 A|X$1 GND|VGND|VSS nfet L=0.15U W=0.65U AS=0.08775P
+ AD=0.08775P PS=0.92U PD=0.92U
* device instance $158 r0 *1 41.71,-130.4 nfet
M$158 A|X$1 \$180 GND|VGND|VSS GND|VGND|VSS nfet L=0.15U W=0.65U AS=0.08775P
+ AD=0.08775P PS=0.92U PD=0.92U
* device instance $159 r0 *1 42.13,-130.4 nfet
M$159 GND|VGND|VSS \$180 A|X$1 GND|VGND|VSS nfet L=0.15U W=0.65U AS=0.08775P
+ AD=0.169P PS=0.92U PD=1.82U
* device instance $160 r0 *1 48.73,-131.435 nfet
M$160 \$152 D|PH_B6|Q|S GND|VGND|VSS GND|VGND|VSS nfet L=0.15U W=0.42U
+ AS=0.1092P AD=0.0693P PS=1.36U PD=0.75U
* device instance $161 r0 *1 49.21,-131.435 nfet
M$161 GND|VGND|VSS C|D|PH_B7|Q|S \$152 GND|VGND|VSS nfet L=0.15U W=0.42U
+ AS=0.0693P AD=0.0567P PS=0.75U PD=0.69U
* device instance $162 r0 *1 49.63,-131.435 nfet
M$162 \$152 B|D|PH_B8|Q|S GND|VGND|VSS GND|VGND|VSS nfet L=0.15U W=0.42U
+ AS=0.0567P AD=0.0567P PS=0.69U PD=0.69U
* device instance $163 r0 *1 50.05,-131.435 nfet
M$163 \$152 A|A_N|D|PH_B9|Q|S GND|VGND|VSS GND|VGND|VSS nfet L=0.15U W=0.42U
+ AS=0.101875P AD=0.0567P PS=0.99U PD=0.69U
* device instance $164 r0 *1 50.54,-131.52 nfet
M$164 A|X \$152 GND|VGND|VSS GND|VGND|VSS nfet L=0.15U W=0.65U AS=0.101875P
+ AD=0.1755P PS=0.99U PD=1.84U
* device instance $165 r0 *1 49.19,-130.515 nfet
M$165 GND|VGND|VSS A|CLK|X \$182 GND|VGND|VSS nfet L=0.15U W=0.42U AS=0.1092P
+ AD=0.0567P PS=1.36U PD=0.69U
* device instance $166 r0 *1 49.61,-130.515 nfet
M$166 \$183 \$182 GND|VGND|VSS GND|VGND|VSS nfet L=0.15U W=0.42U AS=0.0567P
+ AD=0.1092P PS=0.69U PD=1.36U
* device instance $167 r0 *1 51.36,-130.545 nfet
M$167 \$185 \$182 \$184 GND|VGND|VSS nfet L=0.15U W=0.36U AS=0.066P AD=0.0594P
+ PS=0.745U PD=0.69U
* device instance $168 r0 *1 51.84,-130.545 nfet
M$168 \$194 \$183 \$185 GND|VGND|VSS nfet L=0.15U W=0.36U AS=0.0594P AD=0.1401P
+ PS=0.69U PD=1.1U
* device instance $169 r0 *1 54.185,-130.545 nfet
M$169 \$188 \$183 \$187 GND|VGND|VSS nfet L=0.15U W=0.36U AS=0.0999P AD=0.0711P
+ PS=0.985U PD=0.755U
* device instance $170 r0 *1 54.73,-130.545 nfet
M$170 \$197 \$182 \$188 GND|VGND|VSS nfet L=0.15U W=0.36U AS=0.0711P AD=0.0669P
+ PS=0.755U PD=0.75U
* device instance $171 r0 *1 50.885,-130.515 nfet
M$171 \$184 D|X$3 GND|VGND|VSS GND|VGND|VSS nfet L=0.15U W=0.42U AS=0.2205P
+ AD=0.066P PS=1.89U PD=0.745U
* device instance $172 r0 *1 52.67,-130.515 nfet
M$172 \$195 \$187 \$194 GND|VGND|VSS nfet L=0.15U W=0.42U AS=0.1401P AD=0.0441P
+ PS=1.1U PD=0.63U
* device instance $173 r0 *1 53.03,-130.515 nfet
M$173 GND|VGND|VSS RESET_B|RST_B \$195 GND|VGND|VSS nfet L=0.15U W=0.42U
+ AS=0.0441P AD=0.1346P PS=0.63U PD=1.15U
* device instance $174 r0 *1 55.21,-130.515 nfet
M$174 GND|VGND|VSS \$189 \$197 GND|VGND|VSS nfet L=0.15U W=0.42U AS=0.0669P
+ AD=0.12495P PS=0.75U PD=1.015U
* device instance $175 r0 *1 55.955,-130.515 nfet
M$175 \$198 RESET_B|RST_B GND|VGND|VSS GND|VGND|VSS nfet L=0.15U W=0.42U
+ AS=0.12495P AD=0.06405P PS=1.015U PD=0.725U
* device instance $176 r0 *1 56.41,-130.515 nfet
M$176 \$189 \$188 \$198 GND|VGND|VSS nfet L=0.15U W=0.42U AS=0.06405P
+ AD=0.1092P PS=0.725U PD=1.36U
* device instance $177 r0 *1 53.69,-130.405 nfet
M$177 \$187 \$185 GND|VGND|VSS GND|VGND|VSS nfet L=0.15U W=0.64U AS=0.1346P
+ AD=0.0999P PS=1.15U PD=0.985U
* device instance $178 r0 *1 51.95,-131.405 nfet
M$178 GND|VGND|VSS A|CLK|X \$154 GND|VGND|VSS nfet L=0.15U W=0.42U AS=0.1092P
+ AD=0.0567P PS=1.36U PD=0.69U
* device instance $179 r0 *1 52.37,-131.405 nfet
M$179 \$155 \$154 GND|VGND|VSS GND|VGND|VSS nfet L=0.15U W=0.42U AS=0.0567P
+ AD=0.1092P PS=0.69U PD=1.36U
* device instance $180 r0 *1 53.645,-131.405 nfet
M$180 \$157 D|PH_SAMPLE|SAMPLE|Y GND|VGND|VSS GND|VGND|VSS nfet L=0.15U W=0.42U
+ AS=0.2205P AD=0.066P PS=1.89U PD=0.745U
* device instance $181 r0 *1 54.12,-131.375 nfet
M$181 \$158 \$154 \$157 GND|VGND|VSS nfet L=0.15U W=0.36U AS=0.066P AD=0.0594P
+ PS=0.745U PD=0.69U
* device instance $182 r0 *1 54.6,-131.375 nfet
M$182 \$158 \$155 \$171 GND|VGND|VSS nfet L=0.15U W=0.36U AS=0.1401P AD=0.0594P
+ PS=1.1U PD=0.69U
* device instance $183 r0 *1 55.43,-131.405 nfet
M$183 \$170 \$160 \$171 GND|VGND|VSS nfet L=0.15U W=0.42U AS=0.1401P AD=0.0441P
+ PS=1.1U PD=0.63U
* device instance $184 r0 *1 55.79,-131.405 nfet
M$184 \$170 RESET_B|RST_B GND|VGND|VSS GND|VGND|VSS nfet L=0.15U W=0.42U
+ AS=0.1346P AD=0.0441P PS=1.15U PD=0.63U
* device instance $185 r0 *1 56.45,-131.515 nfet
M$185 \$160 \$158 GND|VGND|VSS GND|VGND|VSS nfet L=0.15U W=0.64U AS=0.1346P
+ AD=0.0999P PS=1.15U PD=0.985U
* device instance $186 r0 *1 56.945,-131.375 nfet
M$186 \$161 \$155 \$160 GND|VGND|VSS nfet L=0.15U W=0.36U AS=0.0999P AD=0.0711P
+ PS=0.985U PD=0.755U
* device instance $187 r0 *1 57.49,-131.375 nfet
M$187 \$161 \$154 \$169 GND|VGND|VSS nfet L=0.15U W=0.36U AS=0.0669P AD=0.0711P
+ PS=0.75U PD=0.755U
* device instance $188 r0 *1 57.97,-131.405 nfet
M$188 GND|VGND|VSS \$162 \$169 GND|VGND|VSS nfet L=0.15U W=0.42U AS=0.0669P
+ AD=0.12495P PS=0.75U PD=1.015U
* device instance $189 r0 *1 58.715,-131.405 nfet
M$189 \$168 RESET_B|RST_B GND|VGND|VSS GND|VGND|VSS nfet L=0.15U W=0.42U
+ AS=0.12495P AD=0.06405P PS=1.015U PD=0.725U
* device instance $190 r0 *1 59.17,-131.405 nfet
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
