2AMLogic/sky130-sar-adc/layout/sar-adc-top/reports/20261027-183429-b96026c2/sar_adc_top.lvs-reference.spice

* sar_adc_top.lvs-reference.spice -- GENERATED, do not edit by hand.
* Regenerate with: layout/sar-adc-top/bin/generate-lvs-reference.py
* Assembles the six already-verified sub-block reference subckts
* below (unmodified) into one hierarchical top-level netlist whose
* composition is DERIVED from design/sar_adc_top.spice on every run
* (issues #387/#401) -- see this script's own module docstring.

* --- from layout/sampling-frontend/reference.spice --------------------
* Hand-written LVS reference netlist for the FULL sampling front end sub-block
* (issue #99), against which layout/sampling-frontend/bin/run-flow.sh's
* composed layout is compared.
*
* Scope: every device design/sampling_frontend.sch instantiates -- eleven
* `sky130_fd_pr__nfet_01v8`, nine `sky130_fd_pr__pfet_01v8` and four
* `sky130_fd_pr__cap_mim_m3_1` -- unlike
* layout/sampling-frontend-wells/reference.spice, which is deliberately the
* PFET-only slice that issue #122 needed to falsify a well-isolation claim.
*
* Topology and device sizing are transcribed 1:1 from
* sim/sampling-frontend/testbench/sampling_frontend_dut.spice -- the
* xschem-derived, already-simulated device fragment for
* design/sampling_frontend.sch (issue #52) -- and generalized to the generic
* `pfet`/`nfet` device classes and the `sky130_fd_pr__model__cap_mim` class
* that `klt extract --deck sky130`'s curated deck reports (the same convention
* layout/comparator/reference.spice, layout/cdac-array/'s generated reference
* and layout/trivial-cell/reference.spice all use, and for the same reason:
* the layout side can only ever report the generic class).
*
* Re-verified against design/sampling_frontend.sch post-issue-#236 (issue
* #245): M_SA_P/M_SA_N's gate moved from SAMPLE to the switch's own gate
* node G_P/G_N (a net reconnection only, no device added/removed), and
* M_CMSWN_P/M_CMSWN_N/M_CMSWP_P/M_CMSWP_N widened from W=1U to W=16U --
* both transcribed 1:1 from the same regenerated
* sim/sampling-frontend/testbench/sampling_frontend_dut.spice fragment this
* file has always tracked, per that schematic's own "Bootstrap precharge
* gating" / "Cmswn/Cmswp sizing" header comments.
*
* THE BODY COLUMN IS LOAD-BEARING, per DR-004 / DR-007.
* In an M-card `M<name> D G S B ...` the fourth net is the body terminal. Four
* of the nine PFETs declare a body that is NOT VDD:
*
*   M_SA_P / M_SE_P  -> BOOST_P
*   M_SA_N / M_SE_N  -> BOOST_N
*
* because BOOST_x rises above VDD during sampling, so a VDD-tied body would
* forward-bias those devices' drain/body junction once BOOST exceeds VDD by a
* diode drop. bin/build_layout.py draws three physically separate n-well
* islands and routes each island's tap to its own domain net, so `klt extract`
* resolves each PMOS body from the island it actually sits in;
* reference.broken-body-tie.spice is the negative control that proves LVS can
* *see* the body column at all.
*
* THE CAPACITOR TOP PLATES ARE ALSO LOAD-BEARING, and are the reason this file
* could not exist before layout/requirements.txt moved to klt 0.4.0. On the
* 0.3.0 pin, `klt extract`'s MiM-cap top-plate-via exclusion was scoped to the
* whole drawn met3 layer rather than to met3 that actually touches a capm
* plate, so every legal via3 in the layout was dropped from the deck's generic
* via3 connectivity and all four cap top plates extracted as isolated,
* single-terminal nets (`extract.json`'s own `single_terminal_nets[]` flagged
* them). reference.broken-topology.spice is the negative control for exactly
* that failure mode: it moves the two sampling caps' top plates off TOP_P/TOP_N
* and must be reported as a mismatch.
*
* Capacitance values are the curated deck's own two-term law for
* sky130_fd_pr__cap_mim_m3_1, C = camimc*W*L + cpmimc*2*(W+L) with
* camimc = 2.0 fF/um^2 and cpmimc = 0.19 fF/um (klt's sky130 extraction deck,
* tt corner), evaluated at the schematic's drawn plate sizes:
*   Cboot: W=L=9.8 um  -> 2.0e-15*96.04   + 1.9e-16*39.2  = 1.99528e-13 F
*   Csamp: W=L=46.9 um -> 2.0e-15*2199.61 + 1.9e-16*187.6 = 4.434864e-12 F
*
* Net names below match design/sampling_frontend.sch's own net names;
* `klt lvs`/`NetlistComparer` compares topology rather than net names, but the
* layout side draws eleven of them as met2.pin labels so the reported net
* correspondence reads directly. GND is the twelfth port: it has no drawn pin
* label, because `klt extract` synthesizes the NMOS body/substrate net
* (`vsubs`) globally and the drawn p-substrate tap merges GND into it (see
* bin/build_layout.py's docstring).
*
* Provenance: pattern (generic device classes, schematic-derived topology,
* positive + negative controls) follows layout/comparator/reference.spice and
* layout/sampling-frontend-wells/reference.spice; the device list is
* re-derived from this repo's own design/sampling_frontend.sch, not copied from
* any sibling or external implementation -- clean-room, per CLAUDE.md.
.SUBCKT sampling_frontend VDD GND SAMPLE VCM VINP VINN TOP_P TOP_N BPREF_P
+ BPREF_N BOOST_P BOOST_N
* --- input sampling switches (the matched differential pair) ---------------
M_MSW_P   VINP    G_P     TOP_P   GND     nfet L=0.15U W=2U
M_MSW_N   VINN    G_N     TOP_N   GND     nfet L=0.15U W=2U
* --- bootstrap / precharge NFETs -------------------------------------------
M_SB_P    BSBOT_P SAMPLEB GND     GND     nfet L=0.15U W=1U
M_SCN_P   BSBOT_P SAMPLE  VINP    GND     nfet L=0.15U W=1U
M_SD_P    G_P     SAMPLEB GND     GND     nfet L=0.5U  W=1U
M_CMSWN_P BPREF_P SAMPLE  VCM     GND     nfet L=0.15U W=16U
M_CMSWN_N BPREF_N SAMPLE  VCM     GND     nfet L=0.15U W=16U
M_SD_N    G_N     SAMPLEB GND     GND     nfet L=0.5U  W=1U
M_SCN_N   BSBOT_N SAMPLE  VINN    GND     nfet L=0.15U W=1U
M_SB_N    BSBOT_N SAMPLEB GND     GND     nfet L=0.15U W=1U
M_INVN    SAMPLEB SAMPLE  GND     GND     nfet L=0.15U W=1U
* --- bootstrap / precharge PFETs (body column per DR-004) ------------------
M_SA_P    BOOST_P G_P     VDD     BOOST_P pfet L=0.5U  W=1U
M_SE_P    G_P     SAMPLEB BOOST_P BOOST_P pfet L=0.15U W=1U
M_SCP_P   BSBOT_P SAMPLEB VINP    VDD     pfet L=0.15U W=1U
M_CMSWP_P BPREF_P SAMPLEB VCM     VDD     pfet L=0.15U W=16U
M_INVP    SAMPLEB SAMPLE  VDD     VDD     pfet L=0.15U W=2U
M_CMSWP_N BPREF_N SAMPLEB VCM     VDD     pfet L=0.15U W=16U
M_SCP_N   BSBOT_N SAMPLEB VINN    VDD     pfet L=0.15U W=1U
M_SE_N    G_N     SAMPLEB BOOST_N BOOST_N pfet L=0.15U W=1U
M_SA_N    BOOST_N G_N     VDD     BOOST_N pfet L=0.5U  W=1U
* --- MiM capacitors: bottom plate first (P1), top plate second (P2) --------
C_CBOOT_P BSBOT_P BOOST_P 1.99528e-13 sky130_fd_pr__model__cap_mim
C_CBOOT_N BSBOT_N BOOST_N 1.99528e-13 sky130_fd_pr__model__cap_mim
C_CSAMP_P BPREF_P TOP_P   4.434864e-12 sky130_fd_pr__model__cap_mim
C_CSAMP_N BPREF_N TOP_N   4.434864e-12 sky130_fd_pr__model__cap_mim
.ENDS sampling_frontend

* --- from layout/cdac-array/reference/cdac_array.lvs-reference.spice --------------------
* cdac_array.lvs-reference.spice -- GENERATED, do not edit by hand.
*
* Regenerate with: layout/cdac-array/bin/generate-lvs-reference.py
* Source of truth: design/cdac/cdac_array.sch (issue #53), netlisted headlessly
* by xschem and rewritten into `klt extract --deck sky130`'s own device
* vocabulary. See that script's docstring for the three rewrites and why
* each is a change of vocabulary rather than of topology.
*
* Unit capacitor: the schematic sizes the MiM plate W=L=1.9000 um (DR-019,
* #496/#498 -- a side that is legal on both the 1 nm database grid and
* sky130's 5 nm manufacturing grid), and the drawn plate is that exact
* value, 1.9 um, with no rounding step between them. Its
* capacitance under the extraction deck's own published coefficients
* (area 2.0 fF/um^2, perimeter 0.19 fF/um) is
* C_unit = 8.664000000e-15 F. A bit of weight w carries `MF=w` in the
* schematic and w drawn unit capacitors in the layout, so its reference is
* w separate C cards of C_unit each -- one per physically drawn unit,
* compared 1:1 against the layout's own w extracted unit devices with no
* `klt lvs` `combine_devices` folding needed on either side (issue #148:
* `Netlist.combine_devices()` does not reliably re-sum w identical-valued
* parallel capacitors into one device for w in the hundreds).
*
* Substrate: the schematic's VSS (every nfet bulk) appears here
* under its own schematic name. No rename is needed: since issue #377
* this layout draws a real p-substrate tap of its own, contacted up to a
* met1 landing pad labelled `VSS`, so `klt extract` reports that net by
* that name rather than by the deck's synthesized `vsubs` global.
.SUBCKT cdac_array VREFP VREFN VDD VSS SELn0 SELp0 SELn1 SELp1 SELn2 SELp2 SELn3 SELp3 SELn4 SELp4 TOP_N TOP_P SELp5 SELn5 SELp6 SELn6 SELn7 SELp7 SELn8 SELp8
Cp0 BOT_p0 TOP_P 8.664000000e-15 sky130_fd_pr__model__cap_mim
Mp0n BOT_p0 SELp0 VREFN VSS nfet L=0.15U W=1U
Mp0p BOT_p0 SELp0 VREFP VDD pfet L=0.15U W=2U
Cp1_0 BOT_p1 TOP_P 8.664000000e-15 sky130_fd_pr__model__cap_mim
Cp1_1 BOT_p1 TOP_P 8.664000000e-15 sky130_fd_pr__model__cap_mim
Mp1n BOT_p1 SELp1 VREFN VSS nfet L=0.15U W=1U
Mp1p BOT_p1 SELp1 VREFP VDD pfet L=0.15U W=2U
Cp2_0 BOT_p2 TOP_P 8.664000000e-15 sky130_fd_pr__model__cap_mim
Cp2_1 BOT_p2 TOP_P 8.664000000e-15 sky130_fd_pr__model__cap_mim
Cp2_2 BOT_p2 TOP_P 8.664000000e-15 sky130_fd_pr__model__cap_mim
Cp2_3 BOT_p2 TOP_P 8.664000000e-15 sky130_fd_pr__model__cap_mim
Mp2n BOT_p2 SELp2 VREFN VSS nfet L=0.15U W=1U
Mp2p BOT_p2 SELp2 VREFP VDD pfet L=0.15U W=2U
Cp3_0 BOT_p3 TOP_P 8.664000000e-15 sky130_fd_pr__model__cap_mim
Cp3_1 BOT_p3 TOP_P 8.664000000e-15 sky130_fd_pr__model__cap_mim
Cp3_2 BOT_p3 TOP_P 8.664000000e-15 sky130_fd_pr__model__cap_mim
Cp3_3 BOT_p3 TOP_P 8.664000000e-15 sky130_fd_pr__model__cap_mim
Cp3_4 BOT_p3 TOP_P 8.664000000e-15 sky130_fd_pr__model__cap_mim
Cp3_5 BOT_p3 TOP_P 8.664000000e-15 sky130_fd_pr__model__cap_mim
Cp3_6 BOT_p3 TOP_P 8.664000000e-15 sky130_fd_pr__model__cap_mim
Cp3_7 BOT_p3 TOP_P 8.664000000e-15 sky130_fd_pr__model__cap_mim
Mp3n BOT_p3 SELp3 VREFN VSS nfet L=0.15U W=1U
Mp3p BOT_p3 SELp3 VREFP VDD pfet L=0.15U W=2U
Cp4_0 BOT_p4 TOP_P 8.664000000e-15 sky130_fd_pr__model__cap_mim
Cp4_1 BOT_p4 TOP_P 8.664000000e-15 sky130_fd_pr__model__cap_mim
Cp4_2 BOT_p4 TOP_P 8.664000000e-15 sky130_fd_pr__model__cap_mim
Cp4_3 BOT_p4 TOP_P 8.664000000e-15 sky130_fd_pr__model__cap_mim
Cp4_4 BOT_p4 TOP_P 8.664000000e-15 sky130_fd_pr__model__cap_mim
Cp4_5 BOT_p4 TOP_P 8.664000000e-15 sky130_fd_pr__model__cap_mim
Cp4_6 BOT_p4 TOP_P 8.664000000e-15 sky130_fd_pr__model__cap_mim
Cp4_7 BOT_p4 TOP_P 8.664000000e-15 sky130_fd_pr__model__cap_mim
Cp4_8 BOT_p4 TOP_P 8.664000000e-15 sky130_fd_pr__model__cap_mim
Cp4_9 BOT_p4 TOP_P 8.664000000e-15 sky130_fd_pr__model__cap_mim
Cp4_10 BOT_p4 TOP_P 8.664000000e-15 sky130_fd_pr__model__cap_mim
Cp4_11 BOT_p4 TOP_P 8.664000000e-15 sky130_fd_pr__model__cap_mim
Cp4_12 BOT_p4 TOP_P 8.664000000e-15 sky130_fd_pr__model__cap_mim
Cp4_13 BOT_p4 TOP_P 8.664000000e-15 sky130_fd_pr__model__cap_mim
Cp4_14 BOT_p4 TOP_P 8.664000000e-15 sky130_fd_pr__model__cap_mim
Cp4_15 BOT_p4 TOP_P 8.664000000e-15 sky130_fd_pr__model__cap_mim
Mp4n BOT_p4 SELp4 VREFN VSS nfet L=0.15U W=1U
Mp4p BOT_p4 SELp4 VREFP VDD pfet L=0.15U W=2U
Cp5_0 BOT_p5 TOP_P 8.664000000e-15 sky130_fd_pr__model__cap_mim
Cp5_1 BOT_p5 TOP_P 8.664000000e-15 sky130_fd_pr__model__cap_mim
Cp5_2 BOT_p5 TOP_P 8.664000000e-15 sky130_fd_pr__model__cap_mim
Cp5_3 BOT_p5 TOP_P 8.664000000e-15 sky130_fd_pr__model__cap_mim
Cp5_4 BOT_p5 TOP_P 8.664000000e-15 sky130_fd_pr__model__cap_mim
Cp5_5 BOT_p5 TOP_P 8.664000000e-15 sky130_fd_pr__model__cap_mim
Cp5_6 BOT_p5 TOP_P 8.664000000e-15 sky130_fd_pr__model__cap_mim
Cp5_7 BOT_p5 TOP_P 8.664000000e-15 sky130_fd_pr__model__cap_mim
Cp5_8 BOT_p5 TOP_P 8.664000000e-15 sky130_fd_pr__model__cap_mim
Cp5_9 BOT_p5 TOP_P 8.664000000e-15 sky130_fd_pr__model__cap_mim
Cp5_10 BOT_p5 TOP_P 8.664000000e-15 sky130_fd_pr__model__cap_mim
Cp5_11 BOT_p5 TOP_P 8.664000000e-15 sky130_fd_pr__model__cap_mim
Cp5_12 BOT_p5 TOP_P 8.664000000e-15 sky130_fd_pr__model__cap_mim
Cp5_13 BOT_p5 TOP_P 8.664000000e-15 sky130_fd_pr__model__cap_mim
Cp5_14 BOT_p5 TOP_P 8.664000000e-15 sky130_fd_pr__model__cap_mim
Cp5_15 BOT_p5 TOP_P 8.664000000e-15 sky130_fd_pr__model__cap_mim
Cp5_16 BOT_p5 TOP_P 8.664000000e-15 sky130_fd_pr__model__cap_mim
Cp5_17 BOT_p5 TOP_P 8.664000000e-15 sky130_fd_pr__model__cap_mim
Cp5_18 BOT_p5 TOP_P 8.664000000e-15 sky130_fd_pr__model__cap_mim
Cp5_19 BOT_p5 TOP_P 8.664000000e-15 sky130_fd_pr__model__cap_mim
Cp5_20 BOT_p5 TOP_P 8.664000000e-15 sky130_fd_pr__model__cap_mim
Cp5_21 BOT_p5 TOP_P 8.664000000e-15 sky130_fd_pr__model__cap_mim
Cp5_22 BOT_p5 TOP_P 8.664000000e-15 sky130_fd_pr__model__cap_mim
Cp5_23 BOT_p5 TOP_P 8.664000000e-15 sky130_fd_pr__model__cap_mim
Cp5_24 BOT_p5 TOP_P 8.664000000e-15 sky130_fd_pr__model__cap_mim
Cp5_25 BOT_p5 TOP_P 8.664000000e-15 sky130_fd_pr__model__cap_mim
Cp5_26 BOT_p5 TOP_P 8.664000000e-15 sky130_fd_pr__model__cap_mim
Cp5_27 BOT_p5 TOP_P 8.664000000e-15 sky130_fd_pr__model__cap_mim
Cp5_28 BOT_p5 TOP_P 8.664000000e-15 sky130_fd_pr__model__cap_mim
Cp5_29 BOT_p5 TOP_P 8.664000000e-15 sky130_fd_pr__model__cap_mim
Cp5_30 BOT_p5 TOP_P 8.664000000e-15 sky130_fd_pr__model__cap_mim
Cp5_31 BOT_p5 TOP_P 8.664000000e-15 sky130_fd_pr__model__cap_mim
Mp5n BOT_p5 SELp5 VREFN VSS nfet L=0.15U W=1U
Mp5p BOT_p5 SELp5 VREFP VDD pfet L=0.15U W=2U
Cp6_0 BOT_p6 TOP_P 8.664000000e-15 sky130_fd_pr__model__cap_mim
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
Cp8_54 BOT_p8 TOP_P 8.664000000e-15 sky130_fd_pr__model__cap_mim
Cp8_55 BOT_p8 TOP_P 8.664000000e-15 sky130_fd_pr__model__cap_mim
Cp8_56 BOT_p8 TOP_P 8.664000000e-15 sky130_fd_pr__model__cap_mim
Cp8_57 BOT_p8 TOP_P 8.664000000e-15 sky130_fd_pr__model__cap_mim
Cp8_58 BOT_p8 TOP_P 8.664000000e-15 sky130_fd_pr__model__cap_mim
Cp8_59 BOT_p8 TOP_P 8.664000000e-15 sky130_fd_pr__model__cap_mim
Cp8_60 BOT_p8 TOP_P 8.664000000e-15 sky130_fd_pr__model__cap_mim
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
