2AMLogic/sky130-sar-adc/layout/sar-sequencer/reports/20261021-104530-ddc1d72/sar_sequencer.lvs-reference.spice

* LVS reference for the SAR logic/sequencer sub-block (issue #102).
*
* Mechanically generated -- DO NOT HAND-EDIT. Regenerate with:
*   layout/sar-sequencer/bin/generate-lvs-reference.py [netlist.v]
*
* Topology source: sar-sequencer/reports/20261021-104530-ddc1d72/sar_sequencer_post_route.v
* (klt place-and-route's own post-route `write_verilog` dump -- see
* layout/sar-sequencer/README.md, 'LVS reference provenance', for
* why the LVS reference has to be the *post-route* netlist, not the
* pre-P&R structural netlist).
*
* Flat, transistor-level (klt extract --deck sky130 is a flat
* extractor), device classes generalized to nfet/pfet (matching that
* deck's own generalization of every drawn NMOS/PMOS regardless of
* flavor). Device models: the sky130 PDK's own official CDL
* (libs.ref/sky130_fd_sc_hd/cdl/sky130_fd_sc_hd.cdl), Apache-2.0
* licensed, SkyWater's own release -- not reverse-engineered.
.SUBCKT sar_sequencer CLK RST_B COMP_OUT PH_B9 PH_B8 PH_B7 PH_B6 PH_B5 PH_B4 PH_B3 PH_B2 PH_B1 PH_B0 PH_EOC PH_SAMPLE BUSY DOUT9 DOUT8 DOUT7 DOUT6 DOUT5 DOUT4 DOUT3 DOUT2 DOUT1 DOUT0 VPWR VGND
Mclkbuf_0_CLK_MMIN1 clkbuf_0_CLK_Ab CLK VGND VGND nfet L=0.15U W=0.65U
Mclkbuf_0_CLK_MMIN2 clknet_0_CLK clkbuf_0_CLK_Ab VGND VGND nfet L=0.15U W=2.60U
Mclkbuf_0_CLK_MMIP1 clkbuf_0_CLK_Ab CLK VPWR VPWR pfet L=0.15U W=1.0U
Mclkbuf_0_CLK_MMIP2 clknet_0_CLK clkbuf_0_CLK_Ab VPWR VPWR pfet L=0.15U W=4.0U
Mclkbuf_1_0__f_CLK_MMIN1 clkbuf_1_0__f_CLK_Ab clknet_0_CLK VGND VGND nfet L=0.15U W=0.65U
Mclkbuf_1_0__f_CLK_MMIN2 clknet_1_0__leaf_CLK clkbuf_1_0__f_CLK_Ab VGND VGND nfet L=0.15U W=2.60U
Mclkbuf_1_0__f_CLK_MMIP1 clkbuf_1_0__f_CLK_Ab clknet_0_CLK VPWR VPWR pfet L=0.15U W=1.0U
Mclkbuf_1_0__f_CLK_MMIP2 clknet_1_0__leaf_CLK clkbuf_1_0__f_CLK_Ab VPWR VPWR pfet L=0.15U W=4.0U
Mclkbuf_1_1__f_CLK_MMIN1 clkbuf_1_1__f_CLK_Ab clknet_0_CLK VGND VGND nfet L=0.15U W=0.65U
Mclkbuf_1_1__f_CLK_MMIN2 clknet_1_1__leaf_CLK clkbuf_1_1__f_CLK_Ab VGND VGND nfet L=0.15U W=2.60U
Mclkbuf_1_1__f_CLK_MMIP1 clkbuf_1_1__f_CLK_Ab clknet_0_CLK VPWR VPWR pfet L=0.15U W=1.0U
Mclkbuf_1_1__f_CLK_MMIP2 clknet_1_1__leaf_CLK clkbuf_1_1__f_CLK_Ab VPWR VPWR pfet L=0.15U W=4.0U
Mclkload0_MMIN1 clkload0_Y clknet_1_0__leaf_CLK VGND VGND nfet L=0.15U W=0.65U
Mclkload0_MMIP1 clkload0_Y clknet_1_0__leaf_CLK VPWR VPWR pfet L=0.15U W=1.0U
Mxbreg0_MI46 xbreg0_clkpos xbreg0_clkneg VGND VGND nfet L=0.15U W=0.42U
Mxbreg0_MI42 xbreg0_db xbreg0_clkneg xbreg0_M0 VGND nfet L=0.15U W=0.36U
Mxbreg0_MI656 xbreg0_net82 xbreg0_s0 xbreg0_net108 VGND nfet L=0.15U W=0.42U
Mxbreg0_MI657 xbreg0_net108 RST_B VGND VGND nfet L=0.15U W=0.42U
Mxbreg0_MI33 xbreg0_net101 RST_B VGND VGND nfet L=0.15U W=0.42U
Mxbreg0_MI4 xbreg0_M0 xbreg0_clkpos xbreg0_net93 VGND nfet L=0.15U W=0.36U
Mxbreg0_MI34 xbreg0_net93 xbreg0_M1 xbreg0_net101 VGND nfet L=0.15U W=0.42U
Mxbreg0_MI655 xbreg0_s0 xbreg0_clkneg xbreg0_net81 VGND nfet L=0.15U W=0.36U
Mxbreg0_MI653 DOUT0 xbreg0_net82 VGND VGND nfet L=0.15U W=0.65U
Mxbreg0_MI654 xbreg0_net81 xbreg0_net82 VGND VGND nfet L=0.15U W=0.42U
Mxbreg0_MI44 xbreg0_clkneg clknet_1_1__leaf_CLK VGND VGND nfet L=0.15U W=0.42U
Mxbreg0_MI647 xbreg0_M1 xbreg0_M0 VGND VGND nfet L=0.15U W=0.64U
Mxbreg0_MI39 xbreg0_db MUXOUT0 VGND VGND nfet L=0.15U W=0.42U
Mxbreg0_MI649 xbreg0_M1 xbreg0_clkpos xbreg0_s0 VGND nfet L=0.15U W=0.36U
Mxbreg0_MI47 xbreg0_clkpos xbreg0_clkneg VPWR VPWR pfet L=0.15U W=0.64U
Mxbreg0_MI43 xbreg0_db xbreg0_clkpos xbreg0_M0 VPWR pfet L=0.15U W=0.42U
Mxbreg0_MI662 xbreg0_net165 xbreg0_net82 VPWR VPWR pfet L=0.15U W=0.42U
Mxbreg0_MI659 xbreg0_net82 RST_B VPWR VPWR pfet L=0.15U W=0.42U
Mxbreg0_MI664 xbreg0_s0 xbreg0_clkpos xbreg0_net165 VPWR pfet L=0.15U W=0.42U
Mxbreg0_MI658 xbreg0_net82 xbreg0_s0 VPWR VPWR pfet L=0.15U W=0.42U
Mxbreg0_MI30 xbreg0_net144 xbreg0_M1 VPWR VPWR pfet L=0.15U W=0.42U
Mxbreg0_MI31 xbreg0_M0 xbreg0_clkneg xbreg0_net144 VPWR pfet L=0.15U W=0.42U
Mxbreg0_MI32 xbreg0_net144 RST_B VPWR VPWR pfet L=0.15U W=0.42U
Mxbreg0_MI660 DOUT0 xbreg0_net82 VPWR VPWR pfet L=0.15U W=1.0U
Mxbreg0_MI45 xbreg0_clkneg clknet_1_1__leaf_CLK VPWR VPWR pfet L=0.15U W=0.64U
Mxbreg0_MI648 xbreg0_M1 xbreg0_M0 VPWR VPWR pfet L=0.15U W=0.84U
Mxbreg0_MI40 xbreg0_db MUXOUT0 VPWR VPWR pfet L=0.15U W=0.42U
Mxbreg0_MI650 xbreg0_M1 xbreg0_clkneg xbreg0_s0 VPWR pfet L=0.15U W=0.42U
Mxbreg1_MI46 xbreg1_clkpos xbreg1_clkneg VGND VGND nfet L=0.15U W=0.42U
Mxbreg1_MI42 xbreg1_db xbreg1_clkneg xbreg1_M0 VGND nfet L=0.15U W=0.36U
Mxbreg1_MI656 xbreg1_net82 xbreg1_s0 xbreg1_net108 VGND nfet L=0.15U W=0.42U
Mxbreg1_MI657 xbreg1_net108 RST_B VGND VGND nfet L=0.15U W=0.42U
Mxbreg1_MI33 xbreg1_net101 RST_B VGND VGND nfet L=0.15U W=0.42U
Mxbreg1_MI4 xbreg1_M0 xbreg1_clkpos xbreg1_net93 VGND nfet L=0.15U W=0.36U
Mxbreg1_MI34 xbreg1_net93 xbreg1_M1 xbreg1_net101 VGND nfet L=0.15U W=0.42U
Mxbreg1_MI655 xbreg1_s0 xbreg1_clkneg xbreg1_net81 VGND nfet L=0.15U W=0.36U
Mxbreg1_MI653 DOUT1 xbreg1_net82 VGND VGND nfet L=0.15U W=0.65U
Mxbreg1_MI654 xbreg1_net81 xbreg1_net82 VGND VGND nfet L=0.15U W=0.42U
Mxbreg1_MI44 xbreg1_clkneg clknet_1_1__leaf_CLK VGND VGND nfet L=0.15U W=0.42U
Mxbreg1_MI647 xbreg1_M1 xbreg1_M0 VGND VGND nfet L=0.15U W=0.64U
Mxbreg1_MI39 xbreg1_db MUXOUT1 VGND VGND nfet L=0.15U W=0.42U
Mxbreg1_MI649 xbreg1_M1 xbreg1_clkpos xbreg1_s0 VGND nfet L=0.15U W=0.36U
Mxbreg1_MI47 xbreg1_clkpos xbreg1_clkneg VPWR VPWR pfet L=0.15U W=0.64U
Mxbreg1_MI43 xbreg1_db xbreg1_clkpos xbreg1_M0 VPWR pfet L=0.15U W=0.42U
Mxbreg1_MI662 xbreg1_net165 xbreg1_net82 VPWR VPWR pfet L=0.15U W=0.42U
Mxbreg1_MI659 xbreg1_net82 RST_B VPWR VPWR pfet L=0.15U W=0.42U
Mxbreg1_MI664 xbreg1_s0 xbreg1_clkpos xbreg1_net165 VPWR pfet L=0.15U W=0.42U
Mxbreg1_MI658 xbreg1_net82 xbreg1_s0 VPWR VPWR pfet L=0.15U W=0.42U
Mxbreg1_MI30 xbreg1_net144 xbreg1_M1 VPWR VPWR pfet L=0.15U W=0.42U
Mxbreg1_MI31 xbreg1_M0 xbreg1_clkneg xbreg1_net144 VPWR pfet L=0.15U W=0.42U
Mxbreg1_MI32 xbreg1_net144 RST_B VPWR VPWR pfet L=0.15U W=0.42U
Mxbreg1_MI660 DOUT1 xbreg1_net82 VPWR VPWR pfet L=0.15U W=1.0U
Mxbreg1_MI45 xbreg1_clkneg clknet_1_1__leaf_CLK VPWR VPWR pfet L=0.15U W=0.64U
Mxbreg1_MI648 xbreg1_M1 xbreg1_M0 VPWR VPWR pfet L=0.15U W=0.84U
Mxbreg1_MI40 xbreg1_db MUXOUT1 VPWR VPWR pfet L=0.15U W=0.42U
Mxbreg1_MI650 xbreg1_M1 xbreg1_clkneg xbreg1_s0 VPWR pfet L=0.15U W=0.42U
Mxbreg2_MI46 xbreg2_clkpos xbreg2_clkneg VGND VGND nfet L=0.15U W=0.42U
Mxbreg2_MI42 xbreg2_db xbreg2_clkneg xbreg2_M0 VGND nfet L=0.15U W=0.36U
Mxbreg2_MI656 xbreg2_net82 xbreg2_s0 xbreg2_net108 VGND nfet L=0.15U W=0.42U
Mxbreg2_MI657 xbreg2_net108 RST_B VGND VGND nfet L=0.15U W=0.42U
Mxbreg2_MI33 xbreg2_net101 RST_B VGND VGND nfet L=0.15U W=0.42U
Mxbreg2_MI4 xbreg2_M0 xbreg2_clkpos xbreg2_net93 VGND nfet L=0.15U W=0.36U
Mxbreg2_MI34 xbreg2_net93 xbreg2_M1 xbreg2_net101 VGND nfet L=0.15U W=0.42U
Mxbreg2_MI655 xbreg2_s0 xbreg2_clkneg xbreg2_net81 VGND nfet L=0.15U W=0.36U
Mxbreg2_MI653 DOUT2 xbreg2_net82 VGND VGND nfet L=0.15U W=0.65U
Mxbreg2_MI654 xbreg2_net81 xbreg2_net82 VGND VGND nfet L=0.15U W=0.42U
Mxbreg2_MI44 xbreg2_clkneg clknet_1_0__leaf_CLK VGND VGND nfet L=0.15U W=0.42U
Mxbreg2_MI647 xbreg2_M1 xbreg2_M0 VGND VGND nfet L=0.15U W=0.64U
Mxbreg2_MI39 xbreg2_db MUXOUT2 VGND VGND nfet L=0.15U W=0.42U
Mxbreg2_MI649 xbreg2_M1 xbreg2_clkpos xbreg2_s0 VGND nfet L=0.15U W=0.36U
Mxbreg2_MI47 xbreg2_clkpos xbreg2_clkneg VPWR VPWR pfet L=0.15U W=0.64U
Mxbreg2_MI43 xbreg2_db xbreg2_clkpos xbreg2_M0 VPWR pfet L=0.15U W=0.42U
Mxbreg2_MI662 xbreg2_net165 xbreg2_net82 VPWR VPWR pfet L=0.15U W=0.42U
Mxbreg2_MI659 xbreg2_net82 RST_B VPWR VPWR pfet L=0.15U W=0.42U
Mxbreg2_MI664 xbreg2_s0 xbreg2_clkpos xbreg2_net165 VPWR pfet L=0.15U W=0.42U
Mxbreg2_MI658 xbreg2_net82 xbreg2_s0 VPWR VPWR pfet L=0.15U W=0.42U
Mxbreg2_MI30 xbreg2_net144 xbreg2_M1 VPWR VPWR pfet L=0.15U W=0.42U
Mxbreg2_MI31 xbreg2_M0 xbreg2_clkneg xbreg2_net144 VPWR pfet L=0.15U W=0.42U
Mxbreg2_MI32 xbreg2_net144 RST_B VPWR VPWR pfet L=0.15U W=0.42U
Mxbreg2_MI660 DOUT2 xbreg2_net82 VPWR VPWR pfet L=0.15U W=1.0U
Mxbreg2_MI45 xbreg2_clkneg clknet_1_0__leaf_CLK VPWR VPWR pfet L=0.15U W=0.64U
Mxbreg2_MI648 xbreg2_M1 xbreg2_M0 VPWR VPWR pfet L=0.15U W=0.84U
Mxbreg2_MI40 xbreg2_db MUXOUT2 VPWR VPWR pfet L=0.15U W=0.42U
Mxbreg2_MI650 xbreg2_M1 xbreg2_clkneg xbreg2_s0 VPWR pfet L=0.15U W=0.42U
Mxbreg3_MI46 xbreg3_clkpos xbreg3_clkneg VGND VGND nfet L=0.15U W=0.42U
Mxbreg3_MI42 xbreg3_db xbreg3_clkneg xbreg3_M0 VGND nfet L=0.15U W=0.36U
Mxbreg3_MI656 xbreg3_net82 xbreg3_s0 xbreg3_net108 VGND nfet L=0.15U W=0.42U
Mxbreg3_MI657 xbreg3_net108 RST_B VGND VGND nfet L=0.15U W=0.42U
Mxbreg3_MI33 xbreg3_net101 RST_B VGND VGND nfet L=0.15U W=0.42U
Mxbreg3_MI4 xbreg3_M0 xbreg3_clkpos xbreg3_net93 VGND nfet L=0.15U W=0.36U
Mxbreg3_MI34 xbreg3_net93 xbreg3_M1 xbreg3_net101 VGND nfet L=0.15U W=0.42U
Mxbreg3_MI655 xbreg3_s0 xbreg3_clkneg xbreg3_net81 VGND nfet L=0.15U W=0.36U
Mxbreg3_MI653 DOUT3 xbreg3_net82 VGND VGND nfet L=0.15U W=0.65U
Mxbreg3_MI654 xbreg3_net81 xbreg3_net82 VGND VGND nfet L=0.15U W=0.42U
Mxbreg3_MI44 xbreg3_clkneg clknet_1_1__leaf_CLK VGND VGND nfet L=0.15U W=0.42U
Mxbreg3_MI647 xbreg3_M1 xbreg3_M0 VGND VGND nfet L=0.15U W=0.64U
Mxbreg3_MI39 xbreg3_db MUXOUT3 VGND VGND nfet L=0.15U W=0.42U
Mxbreg3_MI649 xbreg3_M1 xbreg3_clkpos xbreg3_s0 VGND nfet L=0.15U W=0.36U
Mxbreg3_MI47 xbreg3_clkpos xbreg3_clkneg VPWR VPWR pfet L=0.15U W=0.64U
Mxbreg3_MI43 xbreg3_db xbreg3_clkpos xbreg3_M0 VPWR pfet L=0.15U W=0.42U
Mxbreg3_MI662 xbreg3_net165 xbreg3_net82 VPWR VPWR pfet L=0.15U W=0.42U
Mxbreg3_MI659 xbreg3_net82 RST_B VPWR VPWR pfet L=0.15U W=0.42U
Mxbreg3_MI664 xbreg3_s0 xbreg3_clkpos xbreg3_net165 VPWR pfet L=0.15U W=0.42U
Mxbreg3_MI658 xbreg3_net82 xbreg3_s0 VPWR VPWR pfet L=0.15U W=0.42U
Mxbreg3_MI30 xbreg3_net144 xbreg3_M1 VPWR VPWR pfet L=0.15U W=0.42U
Mxbreg3_MI31 xbreg3_M0 xbreg3_clkneg xbreg3_net144 VPWR pfet L=0.15U W=0.42U
Mxbreg3_MI32 xbreg3_net144 RST_B VPWR VPWR pfet L=0.15U W=0.42U
Mxbreg3_MI660 DOUT3 xbreg3_net82 VPWR VPWR pfet L=0.15U W=1.0U
Mxbreg3_MI45 xbreg3_clkneg clknet_1_1__leaf_CLK VPWR VPWR pfet L=0.15U W=0.64U
Mxbreg3_MI648 xbreg3_M1 xbreg3_M0 VPWR VPWR pfet L=0.15U W=0.84U
Mxbreg3_MI40 xbreg3_db MUXOUT3 VPWR VPWR pfet L=0.15U W=0.42U
Mxbreg3_MI650 xbreg3_M1 xbreg3_clkneg xbreg3_s0 VPWR pfet L=0.15U W=0.42U
Mxbreg4_MI46 xbreg4_clkpos xbreg4_clkneg VGND VGND nfet L=0.15U W=0.42U
Mxbreg4_MI42 xbreg4_db xbreg4_clkneg xbreg4_M0 VGND nfet L=0.15U W=0.36U
Mxbreg4_MI656 xbreg4_net82 xbreg4_s0 xbreg4_net108 VGND nfet L=0.15U W=0.42U
Mxbreg4_MI657 xbreg4_net108 RST_B VGND VGND nfet L=0.15U W=0.42U
Mxbreg4_MI33 xbreg4_net101 RST_B VGND VGND nfet L=0.15U W=0.42U
Mxbreg4_MI4 xbreg4_M0 xbreg4_clkpos xbreg4_net93 VGND nfet L=0.15U W=0.36U
Mxbreg4_MI34 xbreg4_net93 xbreg4_M1 xbreg4_net101 VGND nfet L=0.15U W=0.42U
Mxbreg4_MI655 xbreg4_s0 xbreg4_clkneg xbreg4_net81 VGND nfet L=0.15U W=0.36U
Mxbreg4_MI653 DOUT4 xbreg4_net82 VGND VGND nfet L=0.15U W=0.65U
Mxbreg4_MI654 xbreg4_net81 xbreg4_net82 VGND VGND nfet L=0.15U W=0.42U
Mxbreg4_MI44 xbreg4_clkneg clknet_1_1__leaf_CLK VGND VGND nfet L=0.15U W=0.42U
Mxbreg4_MI647 xbreg4_M1 xbreg4_M0 VGND VGND nfet L=0.15U W=0.64U
Mxbreg4_MI39 xbreg4_db MUXOUT4 VGND VGND nfet L=0.15U W=0.42U
Mxbreg4_MI649 xbreg4_M1 xbreg4_clkpos xbreg4_s0 VGND nfet L=0.15U W=0.36U
Mxbreg4_MI47 xbreg4_clkpos xbreg4_clkneg VPWR VPWR pfet L=0.15U W=0.64U
Mxbreg4_MI43 xbreg4_db xbreg4_clkpos xbreg4_M0 VPWR pfet L=0.15U W=0.42U
Mxbreg4_MI662 xbreg4_net165 xbreg4_net82 VPWR VPWR pfet L=0.15U W=0.42U
Mxbreg4_MI659 xbreg4_net82 RST_B VPWR VPWR pfet L=0.15U W=0.42U
Mxbreg4_MI664 xbreg4_s0 xbreg4_clkpos xbreg4_net165 VPWR pfet L=0.15U W=0.42U
Mxbreg4_MI658 xbreg4_net82 xbreg4_s0 VPWR VPWR pfet L=0.15U W=0.42U
Mxbreg4_MI30 xbreg4_net144 xbreg4_M1 VPWR VPWR pfet L=0.15U W=0.42U
Mxbreg4_MI31 xbreg4_M0 xbreg4_clkneg xbreg4_net144 VPWR pfet L=0.15U W=0.42U
Mxbreg4_MI32 xbreg4_net144 RST_B VPWR VPWR pfet L=0.15U W=0.42U
Mxbreg4_MI660 DOUT4 xbreg4_net82 VPWR VPWR pfet L=0.15U W=1.0U
Mxbreg4_MI45 xbreg4_clkneg clknet_1_1__leaf_CLK VPWR VPWR pfet L=0.15U W=0.64U
Mxbreg4_MI648 xbreg4_M1 xbreg4_M0 VPWR VPWR pfet L=0.15U W=0.84U
Mxbreg4_MI40 xbreg4_db MUXOUT4 VPWR VPWR pfet L=0.15U W=0.42U
Mxbreg4_MI650 xbreg4_M1 xbreg4_clkneg xbreg4_s0 VPWR pfet L=0.15U W=0.42U
Mxbreg5_MI46 xbreg5_clkpos xbreg5_clkneg VGND VGND nfet L=0.15U W=0.42U
Mxbreg5_MI42 xbreg5_db xbreg5_clkneg xbreg5_M0 VGND nfet L=0.15U W=0.36U
Mxbreg5_MI656 xbreg5_net82 xbreg5_s0 xbreg5_net108 VGND nfet L=0.15U W=0.42U
Mxbreg5_MI657 xbreg5_net108 RST_B VGND VGND nfet L=0.15U W=0.42U
Mxbreg5_MI33 xbreg5_net101 RST_B VGND VGND nfet L=0.15U W=0.42U
Mxbreg5_MI4 xbreg5_M0 xbreg5_clkpos xbreg5_net93 VGND nfet L=0.15U W=0.36U
Mxbreg5_MI34 xbreg5_net93 xbreg5_M1 xbreg5_net101 VGND nfet L=0.15U W=0.42U
Mxbreg5_MI655 xbreg5_s0 xbreg5_clkneg xbreg5_net81 VGND nfet L=0.15U W=0.36U
Mxbreg5_MI653 DOUT5 xbreg5_net82 VGND VGND nfet L=0.15U W=0.65U
Mxbreg5_MI654 xbreg5_net81 xbreg5_net82 VGND VGND nfet L=0.15U W=0.42U
Mxbreg5_MI44 xbreg5_clkneg clknet_1_0__leaf_CLK VGND VGND nfet L=0.15U W=0.42U
Mxbreg5_MI647 xbreg5_M1 xbreg5_M0 VGND VGND nfet L=0.15U W=0.64U
Mxbreg5_MI39 xbreg5_db MUXOUT5 VGND VGND nfet L=0.15U W=0.42U
Mxbreg5_MI649 xbreg5_M1 xbreg5_clkpos xbreg5_s0 VGND nfet L=0.15U W=0.36U
Mxbreg5_MI47 xbreg5_clkpos xbreg5_clkneg VPWR VPWR pfet L=0.15U W=0.64U
Mxbreg5_MI43 xbreg5_db xbreg5_clkpos xbreg5_M0 VPWR pfet L=0.15U W=0.42U
Mxbreg5_MI662 xbreg5_net165 xbreg5_net82 VPWR VPWR pfet L=0.15U W=0.42U
Mxbreg5_MI659 xbreg5_net82 RST_B VPWR VPWR pfet L=0.15U W=0.42U
Mxbreg5_MI664 xbreg5_s0 xbreg5_clkpos xbreg5_net165 VPWR pfet L=0.15U W=0.42U
Mxbreg5_MI658 xbreg5_net82 xbreg5_s0 VPWR VPWR pfet L=0.15U W=0.42U
Mxbreg5_MI30 xbreg5_net144 xbreg5_M1 VPWR VPWR pfet L=0.15U W=0.42U
Mxbreg5_MI31 xbreg5_M0 xbreg5_clkneg xbreg5_net144 VPWR pfet L=0.15U W=0.42U
Mxbreg5_MI32 xbreg5_net144 RST_B VPWR VPWR pfet L=0.15U W=0.42U
Mxbreg5_MI660 DOUT5 xbreg5_net82 VPWR VPWR pfet L=0.15U W=1.0U
Mxbreg5_MI45 xbreg5_clkneg clknet_1_0__leaf_CLK VPWR VPWR pfet L=0.15U W=0.64U
Mxbreg5_MI648 xbreg5_M1 xbreg5_M0 VPWR VPWR pfet L=0.15U W=0.84U
Mxbreg5_MI40 xbreg5_db MUXOUT5 VPWR VPWR pfet L=0.15U W=0.42U
Mxbreg5_MI650 xbreg5_M1 xbreg5_clkneg xbreg5_s0 VPWR pfet L=0.15U W=0.42U
Mxbreg6_MI46 xbreg6_clkpos xbreg6_clkneg VGND VGND nfet L=0.15U W=0.42U
Mxbreg6_MI42 xbreg6_db xbreg6_clkneg xbreg6_M0 VGND nfet L=0.15U W=0.36U
Mxbreg6_MI656 xbreg6_net82 xbreg6_s0 xbreg6_net108 VGND nfet L=0.15U W=0.42U
Mxbreg6_MI657 xbreg6_net108 RST_B VGND VGND nfet L=0.15U W=0.42U
Mxbreg6_MI33 xbreg6_net101 RST_B VGND VGND nfet L=0.15U W=0.42U
Mxbreg6_MI4 xbreg6_M0 xbreg6_clkpos xbreg6_net93 VGND nfet L=0.15U W=0.36U
Mxbreg6_MI34 xbreg6_net93 xbreg6_M1 xbreg6_net101 VGND nfet L=0.15U W=0.42U
Mxbreg6_MI655 xbreg6_s0 xbreg6_clkneg xbreg6_net81 VGND nfet L=0.15U W=0.36U
Mxbreg6_MI653 DOUT6 xbreg6_net82 VGND VGND nfet L=0.15U W=0.65U
Mxbreg6_MI654 xbreg6_net81 xbreg6_net82 VGND VGND nfet L=0.15U W=0.42U
Mxbreg6_MI44 xbreg6_clkneg clknet_1_0__leaf_CLK VGND VGND nfet L=0.15U W=0.42U
Mxbreg6_MI647 xbreg6_M1 xbreg6_M0 VGND VGND nfet L=0.15U W=0.64U
Mxbreg6_MI39 xbreg6_db MUXOUT6 VGND VGND nfet L=0.15U W=0.42U
Mxbreg6_MI649 xbreg6_M1 xbreg6_clkpos xbreg6_s0 VGND nfet L=0.15U W=0.36U
Mxbreg6_MI47 xbreg6_clkpos xbreg6_clkneg VPWR VPWR pfet L=0.15U W=0.64U
Mxbreg6_MI43 xbreg6_db xbreg6_clkpos xbreg6_M0 VPWR pfet L=0.15U W=0.42U
Mxbreg6_MI662 xbreg6_net165 xbreg6_net82 VPWR VPWR pfet L=0.15U W=0.42U
Mxbreg6_MI659 xbreg6_net82 RST_B VPWR VPWR pfet L=0.15U W=0.42U
Mxbreg6_MI664 xbreg6_s0 xbreg6_clkpos xbreg6_net165 VPWR pfet L=0.15U W=0.42U
Mxbreg6_MI658 xbreg6_net82 xbreg6_s0 VPWR VPWR pfet L=0.15U W=0.42U
Mxbreg6_MI30 xbreg6_net144 xbreg6_M1 VPWR VPWR pfet L=0.15U W=0.42U
Mxbreg6_MI31 xbreg6_M0 xbreg6_clkneg xbreg6_net144 VPWR pfet L=0.15U W=0.42U
Mxbreg6_MI32 xbreg6_net144 RST_B VPWR VPWR pfet L=0.15U W=0.42U
Mxbreg6_MI660 DOUT6 xbreg6_net82 VPWR VPWR pfet L=0.15U W=1.0U
Mxbreg6_MI45 xbreg6_clkneg clknet_1_0__leaf_CLK VPWR VPWR pfet L=0.15U W=0.64U
Mxbreg6_MI648 xbreg6_M1 xbreg6_M0 VPWR VPWR pfet L=0.15U W=0.84U
Mxbreg6_MI40 xbreg6_db MUXOUT6 VPWR VPWR pfet L=0.15U W=0.42U
Mxbreg6_MI650 xbreg6_M1 xbreg6_clkneg xbreg6_s0 VPWR pfet L=0.15U W=0.42U
Mxbreg7_MI46 xbreg7_clkpos xbreg7_clkneg VGND VGND nfet L=0.15U W=0.42U
Mxbreg7_MI42 xbreg7_db xbreg7_clkneg xbreg7_M0 VGND nfet L=0.15U W=0.36U
Mxbreg7_MI656 xbreg7_net82 xbreg7_s0 xbreg7_net108 VGND nfet L=0.15U W=0.42U
Mxbreg7_MI657 xbreg7_net108 RST_B VGND VGND nfet L=0.15U W=0.42U
Mxbreg7_MI33 xbreg7_net101 RST_B VGND VGND nfet L=0.15U W=0.42U
Mxbreg7_MI4 xbreg7_M0 xbreg7_clkpos xbreg7_net93 VGND nfet L=0.15U W=0.36U
Mxbreg7_MI34 xbreg7_net93 xbreg7_M1 xbreg7_net101 VGND nfet L=0.15U W=0.42U
Mxbreg7_MI655 xbreg7_s0 xbreg7_clkneg xbreg7_net81 VGND nfet L=0.15U W=0.36U
Mxbreg7_MI653 DOUT7 xbreg7_net82 VGND VGND nfet L=0.15U W=0.65U
Mxbreg7_MI654 xbreg7_net81 xbreg7_net82 VGND VGND nfet L=0.15U W=0.42U
Mxbreg7_MI44 xbreg7_clkneg clknet_1_0__leaf_CLK VGND VGND nfet L=0.15U W=0.42U
Mxbreg7_MI647 xbreg7_M1 xbreg7_M0 VGND VGND nfet L=0.15U W=0.64U
Mxbreg7_MI39 xbreg7_db MUXOUT7 VGND VGND nfet L=0.15U W=0.42U
Mxbreg7_MI649 xbreg7_M1 xbreg7_clkpos xbreg7_s0 VGND nfet L=0.15U W=0.36U
Mxbreg7_MI47 xbreg7_clkpos xbreg7_clkneg VPWR VPWR pfet L=0.15U W=0.64U
Mxbreg7_MI43 xbreg7_db xbreg7_clkpos xbreg7_M0 VPWR pfet L=0.15U W=0.42U
Mxbreg7_MI662 xbreg7_net165 xbreg7_net82 VPWR VPWR pfet L=0.15U W=0.42U
Mxbreg7_MI659 xbreg7_net82 RST_B VPWR VPWR pfet L=0.15U W=0.42U
Mxbreg7_MI664 xbreg7_s0 xbreg7_clkpos xbreg7_net165 VPWR pfet L=0.15U W=0.42U
Mxbreg7_MI658 xbreg7_net82 xbreg7_s0 VPWR VPWR pfet L=0.15U W=0.42U
Mxbreg7_MI30 xbreg7_net144 xbreg7_M1 VPWR VPWR pfet L=0.15U W=0.42U
Mxbreg7_MI31 xbreg7_M0 xbreg7_clkneg xbreg7_net144 VPWR pfet L=0.15U W=0.42U
Mxbreg7_MI32 xbreg7_net144 RST_B VPWR VPWR pfet L=0.15U W=0.42U
Mxbreg7_MI660 DOUT7 xbreg7_net82 VPWR VPWR pfet L=0.15U W=1.0U
Mxbreg7_MI45 xbreg7_clkneg clknet_1_0__leaf_CLK VPWR VPWR pfet L=0.15U W=0.64U
Mxbreg7_MI648 xbreg7_M1 xbreg7_M0 VPWR VPWR pfet L=0.15U W=0.84U
Mxbreg7_MI40 xbreg7_db MUXOUT7 VPWR VPWR pfet L=0.15U W=0.42U
Mxbreg7_MI650 xbreg7_M1 xbreg7_clkneg xbreg7_s0 VPWR pfet L=0.15U W=0.42U
Mxbreg8_MI46 xbreg8_clkpos xbreg8_clkneg VGND VGND nfet L=0.15U W=0.42U
Mxbreg8_MI42 xbreg8_db xbreg8_clkneg xbreg8_M0 VGND nfet L=0.15U W=0.36U
Mxbreg8_MI656 xbreg8_net82 xbreg8_s0 xbreg8_net108 VGND nfet L=0.15U W=0.42U
Mxbreg8_MI657 xbreg8_net108 RST_B VGND VGND nfet L=0.15U W=0.42U
Mxbreg8_MI33 xbreg8_net101 RST_B VGND VGND nfet L=0.15U W=0.42U
Mxbreg8_MI4 xbreg8_M0 xbreg8_clkpos xbreg8_net93 VGND nfet L=0.15U W=0.36U
Mxbreg8_MI34 xbreg8_net93 xbreg8_M1 xbreg8_net101 VGND nfet L=0.15U W=0.42U
Mxbreg8_MI655 xbreg8_s0 xbreg8_clkneg xbreg8_net81 VGND nfet L=0.15U W=0.36U
Mxbreg8_MI653 DOUT8 xbreg8_net82 VGND VGND nfet L=0.15U W=0.65U
Mxbreg8_MI654 xbreg8_net81 xbreg8_net82 VGND VGND nfet L=0.15U W=0.42U
Mxbreg8_MI44 xbreg8_clkneg clknet_1_0__leaf_CLK VGND VGND nfet L=0.15U W=0.42U
Mxbreg8_MI647 xbreg8_M1 xbreg8_M0 VGND VGND nfet L=0.15U W=0.64U
Mxbreg8_MI39 xbreg8_db MUXOUT8 VGND VGND nfet L=0.15U W=0.42U
Mxbreg8_MI649 xbreg8_M1 xbreg8_clkpos xbreg8_s0 VGND nfet L=0.15U W=0.36U
Mxbreg8_MI47 xbreg8_clkpos xbreg8_clkneg VPWR VPWR pfet L=0.15U W=0.64U
Mxbreg8_MI43 xbreg8_db xbreg8_clkpos xbreg8_M0 VPWR pfet L=0.15U W=0.42U
Mxbreg8_MI662 xbreg8_net165 xbreg8_net82 VPWR VPWR pfet L=0.15U W=0.42U
Mxbreg8_MI659 xbreg8_net82 RST_B VPWR VPWR pfet L=0.15U W=0.42U
Mxbreg8_MI664 xbreg8_s0 xbreg8_clkpos xbreg8_net165 VPWR pfet L=0.15U W=0.42U
Mxbreg8_MI658 xbreg8_net82 xbreg8_s0 VPWR VPWR pfet L=0.15U W=0.42U
Mxbreg8_MI30 xbreg8_net144 xbreg8_M1 VPWR VPWR pfet L=0.15U W=0.42U
Mxbreg8_MI31 xbreg8_M0 xbreg8_clkneg xbreg8_net144 VPWR pfet L=0.15U W=0.42U
Mxbreg8_MI32 xbreg8_net144 RST_B VPWR VPWR pfet L=0.15U W=0.42U
Mxbreg8_MI660 DOUT8 xbreg8_net82 VPWR VPWR pfet L=0.15U W=1.0U
Mxbreg8_MI45 xbreg8_clkneg clknet_1_0__leaf_CLK VPWR VPWR pfet L=0.15U W=0.64U
Mxbreg8_MI648 xbreg8_M1 xbreg8_M0 VPWR VPWR pfet L=0.15U W=0.84U
Mxbreg8_MI40 xbreg8_db MUXOUT8 VPWR VPWR pfet L=0.15U W=0.42U
Mxbreg8_MI650 xbreg8_M1 xbreg8_clkneg xbreg8_s0 VPWR pfet L=0.15U W=0.42U
Mxbreg9_MI46 xbreg9_clkpos xbreg9_clkneg VGND VGND nfet L=0.15U W=0.42U
Mxbreg9_MI42 xbreg9_db xbreg9_clkneg xbreg9_M0 VGND nfet L=0.15U W=0.36U
Mxbreg9_MI656 xbreg9_net82 xbreg9_s0 xbreg9_net108 VGND nfet L=0.15U W=0.42U
Mxbreg9_MI657 xbreg9_net108 RST_B VGND VGND nfet L=0.15U W=0.42U
Mxbreg9_MI33 xbreg9_net101 RST_B VGND VGND nfet L=0.15U W=0.42U
Mxbreg9_MI4 xbreg9_M0 xbreg9_clkpos xbreg9_net93 VGND nfet L=0.15U W=0.36U
Mxbreg9_MI34 xbreg9_net93 xbreg9_M1 xbreg9_net101 VGND nfet L=0.15U W=0.42U
Mxbreg9_MI655 xbreg9_s0 xbreg9_clkneg xbreg9_net81 VGND nfet L=0.15U W=0.36U
Mxbreg9_MI653 DOUT9 xbreg9_net82 VGND VGND nfet L=0.15U W=0.65U
Mxbreg9_MI654 xbreg9_net81 xbreg9_net82 VGND VGND nfet L=0.15U W=0.42U
Mxbreg9_MI44 xbreg9_clkneg clknet_1_1__leaf_CLK VGND VGND nfet L=0.15U W=0.42U
Mxbreg9_MI647 xbreg9_M1 xbreg9_M0 VGND VGND nfet L=0.15U W=0.64U
Mxbreg9_MI39 xbreg9_db MUXOUT9 VGND VGND nfet L=0.15U W=0.42U
Mxbreg9_MI649 xbreg9_M1 xbreg9_clkpos xbreg9_s0 VGND nfet L=0.15U W=0.36U
Mxbreg9_MI47 xbreg9_clkpos xbreg9_clkneg VPWR VPWR pfet L=0.15U W=0.64U
Mxbreg9_MI43 xbreg9_db xbreg9_clkpos xbreg9_M0 VPWR pfet L=0.15U W=0.42U
Mxbreg9_MI662 xbreg9_net165 xbreg9_net82 VPWR VPWR pfet L=0.15U W=0.42U
Mxbreg9_MI659 xbreg9_net82 RST_B VPWR VPWR pfet L=0.15U W=0.42U
Mxbreg9_MI664 xbreg9_s0 xbreg9_clkpos xbreg9_net165 VPWR pfet L=0.15U W=0.42U
Mxbreg9_MI658 xbreg9_net82 xbreg9_s0 VPWR VPWR pfet L=0.15U W=0.42U
Mxbreg9_MI30 xbreg9_net144 xbreg9_M1 VPWR VPWR pfet L=0.15U W=0.42U
Mxbreg9_MI31 xbreg9_M0 xbreg9_clkneg xbreg9_net144 VPWR pfet L=0.15U W=0.42U
Mxbreg9_MI32 xbreg9_net144 RST_B VPWR VPWR pfet L=0.15U W=0.42U
Mxbreg9_MI660 DOUT9 xbreg9_net82 VPWR VPWR pfet L=0.15U W=1.0U
Mxbreg9_MI45 xbreg9_clkneg clknet_1_1__leaf_CLK VPWR VPWR pfet L=0.15U W=0.64U
Mxbreg9_MI648 xbreg9_M1 xbreg9_M0 VPWR VPWR pfet L=0.15U W=0.84U
Mxbreg9_MI40 xbreg9_db MUXOUT9 VPWR VPWR pfet L=0.15U W=0.42U
Mxbreg9_MI650 xbreg9_M1 xbreg9_clkneg xbreg9_s0 VPWR pfet L=0.15U W=0.42U
Mxinv_sample_MMIN1 PH_SAMPLE BUSY VGND VGND nfet L=0.15U W=0.65U
Mxinv_sample_MMIP1 PH_SAMPLE BUSY VPWR VPWR pfet L=0.15U W=1.0U
Mxmux0_MMNA00 xmux0_xb DOUT0 xmux0_smdNA0 VGND nfet L=0.15U W=0.42U
Mxmux0_MMNA01 xmux0_smdNA0 xmux0_Sb VGND VGND nfet L=0.15U W=0.42U
Mxmux0_MMNA10 xmux0_xb COMP_OUT xmux0_sndNA1 VGND nfet L=0.15U W=0.42U
Mxmux0_MMNA11 xmux0_sndNA1 PH_B0 VGND VGND nfet L=0.15U W=0.42U
Mxmux0_MMIN1 xmux0_Sb PH_B0 VGND VGND nfet L=0.15U W=0.42U
Mxmux0_MMIN2 MUXOUT0 xmux0_xb VGND VGND nfet L=0.15U W=0.65U
Mxmux0_MMPA00 VPWR PH_B0 xmux0_sndPS VPWR pfet L=0.15U W=0.42U
Mxmux0_MMPA01 xmux0_sndPS DOUT0 xmux0_xb VPWR pfet L=0.15U W=0.42U
Mxmux0_MMPA10 VPWR xmux0_Sb xmux0_sndPSb VPWR pfet L=0.15U W=0.42U
Mxmux0_MMPA11 xmux0_sndPSb COMP_OUT xmux0_xb VPWR pfet L=0.15U W=0.42U
Mxmux0_MMIP1 xmux0_Sb PH_B0 VPWR VPWR pfet L=0.15U W=0.42U
Mxmux0_MMIP2 MUXOUT0 xmux0_xb VPWR VPWR pfet L=0.15U W=1.0U
Mxmux1_MMNA00 xmux1_xb DOUT1 xmux1_smdNA0 VGND nfet L=0.15U W=0.42U
Mxmux1_MMNA01 xmux1_smdNA0 xmux1_Sb VGND VGND nfet L=0.15U W=0.42U
Mxmux1_MMNA10 xmux1_xb COMP_OUT xmux1_sndNA1 VGND nfet L=0.15U W=0.42U
Mxmux1_MMNA11 xmux1_sndNA1 PH_B1 VGND VGND nfet L=0.15U W=0.42U
Mxmux1_MMIN1 xmux1_Sb PH_B1 VGND VGND nfet L=0.15U W=0.42U
Mxmux1_MMIN2 MUXOUT1 xmux1_xb VGND VGND nfet L=0.15U W=0.65U
Mxmux1_MMPA00 VPWR PH_B1 xmux1_sndPS VPWR pfet L=0.15U W=0.42U
Mxmux1_MMPA01 xmux1_sndPS DOUT1 xmux1_xb VPWR pfet L=0.15U W=0.42U
Mxmux1_MMPA10 VPWR xmux1_Sb xmux1_sndPSb VPWR pfet L=0.15U W=0.42U
Mxmux1_MMPA11 xmux1_sndPSb COMP_OUT xmux1_xb VPWR pfet L=0.15U W=0.42U
Mxmux1_MMIP1 xmux1_Sb PH_B1 VPWR VPWR pfet L=0.15U W=0.42U
Mxmux1_MMIP2 MUXOUT1 xmux1_xb VPWR VPWR pfet L=0.15U W=1.0U
Mxmux2_MMNA00 xmux2_xb DOUT2 xmux2_smdNA0 VGND nfet L=0.15U W=0.42U
Mxmux2_MMNA01 xmux2_smdNA0 xmux2_Sb VGND VGND nfet L=0.15U W=0.42U
Mxmux2_MMNA10 xmux2_xb COMP_OUT xmux2_sndNA1 VGND nfet L=0.15U W=0.42U
Mxmux2_MMNA11 xmux2_sndNA1 PH_B2 VGND VGND nfet L=0.15U W=0.42U
Mxmux2_MMIN1 xmux2_Sb PH_B2 VGND VGND nfet L=0.15U W=0.42U
Mxmux2_MMIN2 MUXOUT2 xmux2_xb VGND VGND nfet L=0.15U W=0.65U
Mxmux2_MMPA00 VPWR PH_B2 xmux2_sndPS VPWR pfet L=0.15U W=0.42U
Mxmux2_MMPA01 xmux2_sndPS DOUT2 xmux2_xb VPWR pfet L=0.15U W=0.42U
Mxmux2_MMPA10 VPWR xmux2_Sb xmux2_sndPSb VPWR pfet L=0.15U W=0.42U
Mxmux2_MMPA11 xmux2_sndPSb COMP_OUT xmux2_xb VPWR pfet L=0.15U W=0.42U
Mxmux2_MMIP1 xmux2_Sb PH_B2 VPWR VPWR pfet L=0.15U W=0.42U
Mxmux2_MMIP2 MUXOUT2 xmux2_xb VPWR VPWR pfet L=0.15U W=1.0U
Mxmux3_MMNA00 xmux3_xb DOUT3 xmux3_smdNA0 VGND nfet L=0.15U W=0.42U
Mxmux3_MMNA01 xmux3_smdNA0 xmux3_Sb VGND VGND nfet L=0.15U W=0.42U
Mxmux3_MMNA10 xmux3_xb COMP_OUT xmux3_sndNA1 VGND nfet L=0.15U W=0.42U
Mxmux3_MMNA11 xmux3_sndNA1 PH_B3 VGND VGND nfet L=0.15U W=0.42U
Mxmux3_MMIN1 xmux3_Sb PH_B3 VGND VGND nfet L=0.15U W=0.42U
Mxmux3_MMIN2 MUXOUT3 xmux3_xb VGND VGND nfet L=0.15U W=0.65U
Mxmux3_MMPA00 VPWR PH_B3 xmux3_sndPS VPWR pfet L=0.15U W=0.42U
Mxmux3_MMPA01 xmux3_sndPS DOUT3 xmux3_xb VPWR pfet L=0.15U W=0.42U
Mxmux3_MMPA10 VPWR xmux3_Sb xmux3_sndPSb VPWR pfet L=0.15U W=0.42U
Mxmux3_MMPA11 xmux3_sndPSb COMP_OUT xmux3_xb VPWR pfet L=0.15U W=0.42U
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
Mxmux9_MMNA11 xmux9_sndNA1 PH_B9 VGND VGND nfet L=0.15U W=0.42U
Mxmux9_MMIN1 xmux9_Sb PH_B9 VGND VGND nfet L=0.15U W=0.42U
Mxmux9_MMIN2 MUXOUT9 xmux9_xb VGND VGND nfet L=0.15U W=0.65U
Mxmux9_MMPA00 VPWR PH_B9 xmux9_sndPS VPWR pfet L=0.15U W=0.42U
Mxmux9_MMPA01 xmux9_sndPS DOUT9 xmux9_xb VPWR pfet L=0.15U W=0.42U
Mxmux9_MMPA10 VPWR xmux9_Sb xmux9_sndPSb VPWR pfet L=0.15U W=0.42U
Mxmux9_MMPA11 xmux9_sndPSb COMP_OUT xmux9_xb VPWR pfet L=0.15U W=0.42U
Mxmux9_MMIP1 xmux9_Sb PH_B9 VPWR VPWR pfet L=0.15U W=0.42U
Mxmux9_MMIP2 MUXOUT9 xmux9_xb VPWR VPWR pfet L=0.15U W=1.0U
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
