2AMLogic/sky130-sar-adc/(list of files, drawings)

Other design files:
layout/halflsb-offset/reports/20261001-084713-79abbf8/schematic-parity.json
