2AMLogic/sky130-sar-adc/layout/top-glue/reports/20260925-043546-0259924/top_glue_post_route.v

module top_glue (ADCOUT0,
    ADCOUT1,
    ADCOUT2,
    ADCOUT3,
    ADCOUT4,
    ADCOUT5,
    ADCOUT6,
    ADCOUT7,
    ADCOUT8,
    BUSY,
    CLK,
    CLKN,
    DOUT0,
    DOUT1,
    DOUT2,
    DOUT3,
    DOUT4,
    DOUT5,
    DOUT6,
    DOUT7,
    DOUT8,
    DOUT9,
    DUMLOAD_MUX_NC,
    DUMLOAD_XNOR_NC,
    HALF_LSB_EN,
    HALF_LSB_ENN,
    OUTN_NC,
    PH_B9,
    SELn0,
    SELn1,
    SELn2,
    SELn3,
    SELn4,
    SELn5,
    SELn6,
    SELn7,
    SELn8,
    SELp0,
    SELp1,
    SELp2,
    SELp3,
    SELp4,
    SELp5,
    SELp6,
    SELp7,
    SELp8);
 output ADCOUT0;
 output ADCOUT1;
 output ADCOUT2;
 output ADCOUT3;
 output ADCOUT4;
 output ADCOUT5;
 output ADCOUT6;
 output ADCOUT7;
 output ADCOUT8;
 input BUSY;
 input CLK;
 output CLKN;
 input DOUT0;
 input DOUT1;
 input DOUT2;
 input DOUT3;
 input DOUT4;
 input DOUT5;
 input DOUT6;
 input DOUT7;
 input DOUT8;
 input DOUT9;
 output DUMLOAD_MUX_NC;
 output DUMLOAD_XNOR_NC;
 output HALF_LSB_EN;
 output HALF_LSB_ENN;
 input OUTN_NC;
 input PH_B9;
 output SELn0;
 output SELn1;
 output SELn2;
 output SELn3;
 output SELn4;
 output SELn5;
 output SELn6;
 output SELn7;
 output SELn8;
 output SELp0;
 output SELp1;
 output SELp2;
 output SELp3;
 output SELp4;
 output SELp5;
 output SELp6;
 output SELp7;
 output SELp8;

 wire DOUT9N;

 sky130_fd_sc_hd__fill_8 FILLER_0_0 ();
 sky130_fd_sc_hd__fill_8 FILLER_0_107 ();
 sky130_fd_sc_hd__fill_4 FILLER_0_115 ();
 sky130_fd_sc_hd__fill_1 FILLER_0_119 ();
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
    .B(DOUT9N),
    .X(ADCOUT5));
 sky130_fd_sc_hd__xor2_1 xxor_code6 (.A(DOUT6),
    .B(DOUT9N),
    .X(ADCOUT6));
 sky130_fd_sc_hd__xor2_1 xxor_code7 (.A(DOUT7),
    .B(DOUT9N),
    .X(ADCOUT7));
 sky130_fd_sc_hd__xor2_1 xxor_code8 (.A(DOUT8),
    .B(DOUT9N),
    .X(ADCOUT8));
endmodule
