2AMLogic/sky130-sar-adc/layout/seln-inverters/reports/20260917-180644-527ec73/seln_inverters_post_route.v

module seln_inverters (DOUT0,
    DOUT1,
    DOUT2,
    DOUT3,
    DOUT4,
    DOUT5,
    DOUT6,
    DOUT7,
    DOUT8,
    SELn0,
    SELn1,
    SELn2,
    SELn3,
    SELn4,
    SELn5,
    SELn6,
    SELn7,
    SELn8);
 input DOUT0;
 input DOUT1;
 input DOUT2;
 input DOUT3;
 input DOUT4;
 input DOUT5;
 input DOUT6;
 input DOUT7;
 input DOUT8;
 output SELn0;
 output SELn1;
 output SELn2;
 output SELn3;
 output SELn4;
 output SELn5;
 output SELn6;
 output SELn7;
 output SELn8;


 sky130_fd_sc_hd__fill_8 FILLER_0_0 ();
 sky130_fd_sc_hd__fill_8 FILLER_0_107 ();
 sky130_fd_sc_hd__fill_4 FILLER_0_115 ();
 sky130_fd_sc_hd__fill_1 FILLER_0_119 ();
 sky130_fd_sc_hd__fill_8 FILLER_0_121 ();
 sky130_fd_sc_hd__fill_8 FILLER_0_129 ();
 sky130_fd_sc_hd__fill_8 FILLER_0_137 ();
 sky130_fd_sc_hd__fill_4 FILLER_0_145 ();
 sky130_fd_sc_hd__fill_1 FILLER_0_149 ();
 sky130_fd_sc_hd__fill_8 FILLER_0_151 ();
 sky130_fd_sc_hd__fill_8 FILLER_0_159 ();
 sky130_fd_sc_hd__fill_8 FILLER_0_16 ();
 sky130_fd_sc_hd__fill_8 FILLER_0_167 ();
 sky130_fd_sc_hd__fill_2 FILLER_0_175 ();
 sky130_fd_sc_hd__fill_1 FILLER_0_177 ();
 sky130_fd_sc_hd__fill_4 FILLER_0_24 ();
 sky130_fd_sc_hd__fill_2 FILLER_0_28 ();
 sky130_fd_sc_hd__fill_8 FILLER_0_31 ();
 sky130_fd_sc_hd__fill_8 FILLER_0_39 ();
 sky130_fd_sc_hd__fill_8 FILLER_0_47 ();
 sky130_fd_sc_hd__fill_4 FILLER_0_55 ();
 sky130_fd_sc_hd__fill_1 FILLER_0_59 ();
 sky130_fd_sc_hd__fill_8 FILLER_0_61 ();
 sky130_fd_sc_hd__fill_8 FILLER_0_69 ();
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
    .Y(SELn4));
 sky130_fd_sc_hd__inv_1 xinv_seln5 (.A(DOUT5),
    .Y(SELn5));
 sky130_fd_sc_hd__inv_1 xinv_seln6 (.A(DOUT6),
    .Y(SELn6));
 sky130_fd_sc_hd__inv_1 xinv_seln7 (.A(DOUT7),
    .Y(SELn7));
 sky130_fd_sc_hd__inv_1 xinv_seln8 (.A(DOUT8),
    .Y(SELn8));
endmodule
