2AMLogic/sky130-sar-adc/layout/sar-sequencer/reports/20260917-180601-527ec73/sar_sequencer_post_route.v

module sar_sequencer (BUSY,
    CLK,
    COMP_OUT,
    DOUT0,
    DOUT1,
    DOUT2,
    DOUT3,
    DOUT4,
    DOUT5,
    DOUT6,
    DOUT7,
    DOUT8,
    DOUT9,
    PH_B0,
    PH_B1,
    PH_B2,
    PH_B3,
    PH_B4,
    PH_B5,
    PH_B6,
    PH_B7,
    PH_B8,
    PH_B9,
    PH_EOC,
    PH_SAMPLE,
    RST_B);
 output BUSY;
 input CLK;
 input COMP_OUT;
 output DOUT0;
 output DOUT1;
 output DOUT2;
 output DOUT3;
 output DOUT4;
 output DOUT5;
 output DOUT6;
 output DOUT7;
 output DOUT8;
 output DOUT9;
 output PH_B0;
 output PH_B1;
 output PH_B2;
 output PH_B3;
 output PH_B4;
 output PH_B5;
 output PH_B6;
 output PH_B7;
 output PH_B8;
 output PH_B9;
 output PH_EOC;
 output PH_SAMPLE;
 input RST_B;

 wire MUXOUT0;
 wire MUXOUT1;
 wire MUXOUT2;
 wire MUXOUT3;
 wire MUXOUT4;
 wire MUXOUT5;
 wire MUXOUT6;
 wire MUXOUT7;
 wire MUXOUT8;
 wire MUXOUT9;
 wire ORG1;
 wire ORG2;
 wire ORG3;
 wire clknet_0_CLK;
 wire clknet_1_0__leaf_CLK;
 wire clknet_1_1__leaf_CLK;

 sky130_fd_sc_hd__fill_8 FILLER_0_0 ();
 sky130_fd_sc_hd__fill_8 FILLER_0_16 ();
 sky130_fd_sc_hd__fill_4 FILLER_0_24 ();
 sky130_fd_sc_hd__fill_2 FILLER_0_28 ();
 sky130_fd_sc_hd__fill_8 FILLER_0_31 ();
 sky130_fd_sc_hd__fill_8 FILLER_0_39 ();
 sky130_fd_sc_hd__fill_8 FILLER_0_47 ();
 sky130_fd_sc_hd__fill_4 FILLER_0_55 ();
 sky130_fd_sc_hd__fill_1 FILLER_0_59 ();
 sky130_fd_sc_hd__fill_8 FILLER_0_8 ();
 sky130_fd_sc_hd__fill_2 FILLER_0_81 ();
 sky130_fd_sc_hd__fill_8 FILLER_10_0 ();
 sky130_fd_sc_hd__fill_8 FILLER_10_31 ();
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
    .D(PH_B9),
    .RESET_B(RST_B),
    .Q(PH_B8));
 sky130_fd_sc_hd__dfrtp_1 xringb9 (.CLK(clknet_1_0__leaf_CLK),
    .D(PH_SAMPLE),
    .RESET_B(RST_B),
    .Q(PH_B9));
 sky130_fd_sc_hd__dfrtp_1 xringeoc (.CLK(clknet_1_1__leaf_CLK),
    .D(PH_B0),
    .RESET_B(RST_B),
    .Q(PH_EOC));
endmodule
