2AMLogic/sky130-sar-adc/(commit log)

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2026-08-14 spec: add DR-001 recommending the 1.8 V core supply flavor (#4)
    * spec: add DR-001 recommending the 1.8 V core supply flavor
    Stands up spec/decision-records/ (adapted TEMPLATE.md) and drafts DR-001, the
    supply-flavor scoping record that issue #1 ratifies against.
    DR-001 enumerates the sky130A device menu from the installed models rather
    than from assumption, confirming there is no complementary 3.3 V enhancement
    pair (only the native, PMOS-less nfet_03v3_nvt), and recommends the 1.8 V core
    flavor with sky130_fd_sc_hd for the SAR logic. The 5.0 V g5v0d10v5
    arrangement and a numerically gf180-like 3.3 V thick-oxide arrangement are
    deferred outright; a mixed HV-front-end arrangement is deferr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
2026-08-14 fix: repair CI lint/test scripts that referenced nonexistent bandgap paths (#6)
    package.json's lint/test:compile/test:unit scripts and .github/workflows/
    ci.yml were carried over from sky130-bandgap and referenced paths (sim/bin/*,
    layout/bin/*, layout/tests) that don't exist yet in this repo, plus two GNU
    xargs invocations that fail on zero matches. Trim the scripts to what
    actually exists (bash -n loom.sh, xargs -r for empty-input tolerance), drop
    the bandgap-named flow invocations, and stub the pdk-smoke job's PDK-specific
    steps with a placeholder so it won't fail when it runs. Verified npm run
    check:ci exits 0 on a clean checkout, including with throwaway .json/.py
    files present.
    Closes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
2026-08-14 Bootstrap the sim harness (xschem + ngspice PVT + Monte-Carlo) and the klt sky130 layout flow (#7)
    * Bootstrap the sim harness (PVT + Monte Carlo) and the klt sky130 layout flow
    Stands up the two pieces of infrastructure every later result in this repo
    depends on, seeded from the sibling canaries rather than reinvented, and
    proves both of them are *falsifiable* rather than merely green.
    A. sky130 open-PDK flow
    - docs/environment-setup.md: volare PDK install (pinned open_pdks commit),
    PDK_ROOT/PDK convention, headless xschem netlisting, and the end-to-end
    smoke test, followed verbatim on the reference machine.
    - sim/xschemrc, sim/spiceinit, sim/pdk.json, sim/env.sh: the project-local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
    [smoke_test.sch]
2026-08-14 fix: assert Monte Carlo positive-arm variance and fail closed on unverifiable PDK provenance (#9)
    - mc_runner.positive_control_ok() requires the mismatch-enabled draws'
    stdev to exceed a per-measurement min_stdev floor (default 0.0), wired
    into mc_cli's exit status and write_evidence()'s Overall/record output,
    so a regression that silences MC_MM_SWITCH can no longer collapse both
    MC arms to stdev == 0 and still read as a passing negative control.
    - pdk.resolved_commit_verified() signals unverifiable PDK provenance as
    None instead of folding it into resolved_commit()'s display-string
    fallback; toolchain.check_env() now warns (not silently passes) on an
    install whose commit can't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
2026-08-16 docs: add docs/t1-gap.md mapping the ten T1 checklist items to their tracking issues (#32)
    Records the 2026-08-15 T1/bronze re-read verdict (1/10 pass, items 1, 2, 5, 6,
    8, 9 failing) as a dated snapshot in the repo, with each failing item pointed at
    the issue now tracking it and each N/A item pointed at what unblocks it. Notes
    that the sim harness and klt layout flow are not the gap, and restates the rules
    that hold over every item (no grant recorded here, no spec row relaxed,
    ratification is an operator act, staleness is failure).
    README's status list links the new file so the gap is discoverable from the
    front page.
2026-08-17 docs: split README Status bullet to reflect DR-001-ratified supply flavor (#35)
    The supply flavor (1.8 V core, pfet_01v8/nfet_01v8) was ratified
    2026-08-13 via DR-001 (#1), but README still described it as an open
    question. Split the bullet so the ratified flavor is distinguished
    from the still-DRAFT numeric rows (V_REF, LSB, kT/C noise budget,
    ENOB/INL/DNL targets), and keep DR-001's live tripwire visible.
    Closes #33
2026-08-17 spec: draft DR-003 deriving the sky130 numeric spec rows (V_REF, LSB, CDAC unit cap, comparator noise, corner scope) (#36)
    Derives, from the ratified 1.8V core rail (DR-001) and the installed sky130A
    PDK (open_pdks c6d73a35f524070e85faff4a6a9eef49553ebc2b), a proposed value
    for every numeric row #26 asked for: V_REF = VDD = 1.8V (does not trigger
    DR-002 -- stays at the rail); LSB_diff = 3.5156 mV; N=10 confirmed;
    CDAC unit cap C_u ~= 8.65 fF sized from sky130's own MIM local-mismatch
    model (A_C = 2.8 %*um, read off sky130_fd_pr__cap_mim_m3_{1,2}'s own
    mismatch term -- not gf180's literature placeholder), ~415x above the kT/C
    floor; comparator noise budget 28.86%/16.67% of LSB (baseline/stret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
2026-08-19 refactor: remove unused corner/temperature/tolerance defaults from corners.py (#49)
    default_process_corners(), DEFAULT_TEMPERATURES_C, and DEFAULT_SUPPLY_TOLERANCE
    in sim/harness/corners.py were never wired into any production call path --
    runner.run() sources process corners, temperatures, and supply tolerance from
    the testbench manifest with its own separate fallbacks. Drop the dead symbols
    and their now-orphaned unit test; default_mismatch_corners() (live, used by
    mismatch_corner_for() in mc_runner.py) is untouched.
    Closes #48
2026-08-21 design: add dynamic comparator (no preamp) + standalone testbench (#54) (#60)
    Adds design/comparator.sch, a 9-device single-tail dynamic (StrongARM-class)
    latched comparator core (nfet_01v8/pfet_01v8 only, no preamp stage), a
    standalone testbench under sim/comparator-decision/ exercising its decision
    behavior in isolation (regeneration time vs. differential input, mismatch-
    driven offset, input-referred noise), and a new decision record,
    spec/decision-records/DR-004-comparator-topology-and-noise-budget.md,
    recording the no-preamp topology decision and the provisional noise budget
    as provisional (per DR-001/DR-003, neither ratified).
    Verification performed:
    - design/comparator.sch netlists c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
    [comparator.sch]
2026-08-21 feat: differential CDAC array design source (unit cell, array, termination) (#58)
    * feat: add differential CDAC array design source (unit cell, array, termination)
    Implements issue #53's T1 CDAC sub-block: a 9-bit-per-side binary-weighted
    bottom-plate-switching array built from a documented unit cell (cap_mim_m3_1
    + single-control-line CMOS bottom-plate switch, 1.8V core devices only) plus
    a non-switching termination unit per side, sized per DR-003's provisional
    C_u derivation. DR-004 records the switching-scheme choice (conventional
    two-rail, diverging from gf180-sar-adc's MCS/Vcm scheme) and the matching
    strategy. A standalone sim/cdac-array-transfer/ testbench (with its own
    transient-bas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
    [cdac_array.sch, cdac_unit_cell.sch]
2026-08-22 fix: renumber duplicate DR-004 CDAC record to DR-005 (#82)
    spec/decision-records/ had two files claiming DR-004: the CDAC array
    design record (merged via PR #58) and the comparator topology/noise
    record (merged via PR #60). Per spec/README.md's numbering rule, since
    the comparator record merged first, the later-merged CDAC record is the
    one renumbered to DR-005 -- filename, heading, and every live-source
    cross-reference (design/cdac/README.md, cdac_array.sch,
    cdac_unit_cell.sch, sim/cdac-array-transfer/testbench/tb_cdac_array_transfer.spice).
    Append-only evidence (sim/*/netlist-snapshots/*.spice,
    sim/*/records/*.md) is left untouched per spec/README.md's "Two
    append-only trails" section.
    C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
    [cdac_array.sch, cdac_unit_cell.sch]
2026-08-22 chore: resync .github/CONFIGURATION.md from upstream Loom defaults
    Applied to the working tree by `resync-installed.sh` and then left
    uncommitted. `.github/` is on the Loom-shipped allowlist and is walked by the
    resync, so it updates with the rest — but the resync's own commit step stages
    `.loom/` only, so this file stays dirty in every repo the resync touches.
    That is not cosmetic. `fleet-resync.sh` refuses to run against a repo with
    uncommitted work under `.loom/`, `.claude/`, or `.gitignore`, and a repo left
    dirty this way can trip that guard on a later run and stop receiving upstream
    fixes entirely while still reporting as a healthy fleet member. The identical
    diff was found pending i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
2026-08-24 ratification: install the two-key reviewer variant (EE key + market key) (#50)
    Phase C2 of 2AMLogic/2am#372 (autonomous spec ratification). Installs the
    Tier-1-clean EE-key skill verbatim from 2AMLogic/2am's ratification/ee-key/,
    and the generated market-key canary variant (2AMLogic/product's
    generate-canary-variant.py output, lint-clean and selftest-passed) scoped to
    this repo's block class (sar-adc). Enables Phase C3's ratification of the
    currently-held PR through the two-key path.
    Part of 2AMLogic/2am#384 (one of six canary repos; see that issue for the
    other five).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
2026-08-24 feat: add SAR sequencer + clock/phase generation on sky130_fd_sc_hd (#59)
    * feat: add SAR sequencer + clock/phase generation on sky130_fd_sc_hd
    Adds design/sar_sequencer.sch: a 10-bit (provisional) SAR successive-
    approximation sequencer and one-hot clock/phase generator built entirely
    from sky130_fd_sc_hd standard cells (dfrtp_1, mux2_1, or3_1/or4_1, inv_1).
    A walking-one ring of 11 async-reset D flip-flops generates 10 MSB-first
    bit-trial phases plus one EOC phase from a single master CLK, with no
    external start pulse needed (SAMPLE phase is computed combinationally as
    NOT(OR of all ring stages), so the ring auto-restarts). Each SAR-register
    bit is a dfrtp_1 fed through a mux2_1 that capt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
    [sar_sequencer.sch]
2026-08-24 feat: add sampling front-end schematic and standalone transient testbench (#62)
    * feat: add sampling front-end schematic and standalone transient testbench
    Adds design/sampling_frontend.sch (per-side bootstrapped sampling switch,
    VCM reference switching, single-inverter sample/hold clocking) using only
    ratified 1.8V core devices, plus sim/sampling-frontend/'s standalone
    transient testbench and a real evidence record.
    Fixes a real subthreshold-leakage sizing bug found while verifying the
    schematic (Sa/Sd precharge/discharge devices at minimum length drooped the
    bootstrapped node enough to produce a 120mV in-sample settling error;
    L=0.15um -> L=0.5um resolves it, sub-mV settling at every tes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
    [sampling_frontend.sch]
2026-08-24 feat: top-level SAR ADC integration, symbol, and netlist regeneration path (#56) (#96)
    Wires the four sub-block schematics (sampling front end #52, CDAC array #53,
    comparator #54, SAR sequencer #55) into a new top-level schematic
    (design/sar_adc_top.sch), with a generated instantiable symbol
    (design/sar_adc_top.sym) and a mechanically regenerated, provenance-stamped,
    CI-checked full-hierarchy netlist (design/sar_adc_top.spice via
    design/regen_netlist.sh).
    - Adds ipin.sym/opin.sym hierarchical port objects to design/comparator.sch
    and design/sampling_frontend.sch (previously lab_pin-only), aligning all
    four sub-blocks on the port convention design/cdac/cdac_array.sch and
    design/sar_seq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
    [comparator.sch, sampling_frontend.sch, sar_adc_top.sch]
2026-08-24 fix: resolve sampling-frontend/CDAC-array bottom-plate reference mismatch (#97)
    Verifies (sim/sampling-cdac-handoff/) that sampling_frontend's BPREF_P/
    BPREF_N being left permanently dead-ended (sar_adc_top.sch's actual
    BPREF_P_NC/BPREF_N_NC wiring) does not corrupt TOP_P/TOP_N's sampled value:
    during SAMPLE the front end's own bootstrapped switches drive TOP_x
    low-impedance regardless of the CDAC array's real (always-driven, never
    floating) bottom-plate state, and once SAMPLE ends the front end's own
    Csamp_p/Csamp_n become inert isolated capacitors that inject no further
    current. Path (a) resolution: retire the "CDAC hands off BPREF_x" assumption
    in sampling_frontend.sch/DR-004/sar_adc_top.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
    [sampling_frontend.sch, sar_adc_top.sch]
2026-08-25 fix: root-cause and resolve sampling front-end SAMPLE-to-HOLD droop (#61) (#98)
    Adds sim/sampling-frontend/run_hold_kick.py, a six-experiment diagnostic
    that root-causes the several-hundred-mV droop DR-004 flagged as an open
    item: capacitive charge injection onto the floating {TOP_x, BPREF_x}
    island from SAMPLE/SAMPLEB's gate-drain overlap and the sampling switch's
    own gate-source overlap, confirmed by two independent methods (small-signal
    .ac extraction and a large-signal added-load sweep fit, R^2 > 0.98).
    The decisive result (Experiment 6): attaching the real CDAC array
    (design/cdac/cdac_array.sch, #53) to TOP_x exactly as design/sar_adc_top.sch
    (#56) wires it collapses the same charge-in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
2026-08-25 feat: draw the dynamic comparator sub-block layout (partial, issue #101) (#108)
    Draws all five matched-device/pair blocks for design/comparator.sch via
    `klt gen` (diff_pair/mos_array), with a deliberate, documented common-
    centroid matching strategy for the input differential pair (the acceptance-
    criteria-critical net for input-referred offset, tracked by #29) and a
    proportionate plain A/B strategy for the other, less offset-critical
    matched pairs. Each of the five blocks is independently DRC-clean.
    Composing them into one cell via `klt gen-compose` (bumping the pinned
    klayout-tools 0.2.0 -> 0.3.0 for its new bundle-routing support) currently
    routes only some legs of some nets, so the comp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
    [render-record.py]
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2026-08-25 feat: route the comparator layout by hand to DRC-clean and LVS-clean (#114)
    * feat: route the comparator layout by hand to DRC-clean and LVS-clean
    Replaces the comparator sub-block's `klt gen-compose`-routed composition
    (which reached neither a DRC-clean nor an LVS-clean verdict) with a
    hand-written floorplan + channel router emitted through `klt draw`, and
    demotes `klt gen-compose` to a placer.
    - `bin/build_layout.py` (new): computes explicit block origins on a
    mirror-symmetric floorplan and routes every net -- met1 branches, met2
    per-net trunks, mcon/via cuts, the two body-tie tap structures, the
    merged n-well and the seven met1.pin labels -- into a `klt draw` request
    plus a rout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
    [build_layout.py, render-record.py]
2026-08-25 fix: restore the six-verdict trivial-cell proof under the klt 0.3.0 pin (#111)
    * fix: restore the six-verdict trivial-cell proof under the klt 0.3.0 pin
    Re-running layout/bin/run-trivial-cell-flow.sh against klayout-tools==0.3.0
    (the pin main already carries) exits 1: verdict 2, "klt lvs matches the
    known-good reference", flips to mismatch with 46 severity:"error" entries.
    Root cause is not the bump's headline features (cap_array, gen-compose
    bundle routing -- both additive) but a second change riding along in the
    same release: 0.3.0 carries the dummy-device-suppression fix
    (klayout-tools#491/#494) that 0.2.0 predated. `klt extract --deck sky130`
    on `klt gen mos_array`'s defaults now repor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
2026-08-25 refactor: dedup render-record.py boilerplate via layout/bin/_record_common.py (#118)
    Issue #115 identified byte-for-byte-duplicated `_load_json`/`_tool_version`/
    git-commit-and-dirty/argparse boilerplate between comparator's and
    sar-sequencer's render-record.py scripts. Since the issue was filed, PR #114
    (merged minutes before #115 was created) rewrote comparator/bin/render-record.py
    to adopt the trivial-cell flow's stricter check=True-raising discipline
    (comparator now always requires full completion), so its helpers no longer
    match sar-sequencer's lenient, partial-completion-tolerant ones -- that
    divergence is intentional (see layout/bin/_record_common.py's own docstring)
    and comparator is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
    [render-record.py]
2026-08-25 feat: replace comparator wire-area symmetry proxy with real klt pex extraction (#119)
    klt extract --parasitics --pdk sky130A the composed comparator layout,
    restate the OUTP/OUTN and VINN/VINP wire-area imbalance claims in farads,
    and re-simulate the schematic-vs-extracted pick-off delta at a zero-input
    and a gain-calibration corner to derive a parasitic-driven input-referred
    offset estimate, compared against the existing device-mismatch-only offset
    record.
    klt pex itself hit two independent tool bugs on this sub-block (a
    models.lib mis-resolution on the extracted-side leg, and a sky130 MOS
    PDK-binding unit-convention bug), both filed generically at
    2AMLogic/klayout-tools (#1395, #1396) per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
2026-08-25 fix: root-cause the nightly pdk-smoke failure to xschem version drift (#120)
    * fix: root-cause the nightly pdk-smoke failure to xschem version drift (#116)
    The 2026-08-25 06:29 UTC scheduled pdk-smoke run (32817182786) failed at
    "SAR ADC top-level netlist regeneration check" -- the very first time that
    job's regen_netlist.sh --check step had ever executed in CI. Reading the
    run's log directly (gh run view --log-failed, which was not 403'd this
    session) and reproducing locally with both xschem builds pinned down the
    cause precisely: CI's pdk-smoke job apt-installs xschem (Ubuntu 24.04 ships
    3.4.4-1), which is older than sim/toolchain.json's xschem_tag pin (3.4.7).
    The older build (a) is chat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
2026-08-27 ratification: fix inaccurate market-key MANIFEST.md comp-data list (#125)
    The section listed all 4 original COMP_CLASSES entries
    (ldo, pll, sar-adc, bandgap) instead of the single comp file this repo
    actually carries in ratification/market-key/comps/ — the installer
    committed generate-canary-variant.py's raw output instead of hand-scoping
    it per canary-variant.md's install procedure.
    Not a disclosure leak (every listed filename names another public
    canary's own block class); a documentation-accuracy fix only.
    Part of 2AMLogic/2am#589
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2026-08-28 sim: aggregated characterization report tying spec rows to evidence (#30) (#132)
    Adds sim/report/generate.py + sim/report/manifest.py: generates
    docs/characterization-report.md, mapping every spec/target-spec.md Target-
    table row (including DRAFT/unratified/unmeasured rows, stated as such) to
    the specific sim/*/records/*.md and layout/*/reports/*/record.md evidence
    it rests on. Per-citation fields (Record ID, Overall/Statistical
    convention/Measured value(s), Corner matrix run, Supersedes) are extracted
    from the cited record at generation time rather than hand-transcribed.
    Mechanical freshness (npm run check:report, wired into check:ci): fails if
    a cited sim/ record has been superseded by a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
2026-08-28 spec: propose revised, evidence-derived ENOB/INL-DNL targets (DR-007, #129) (#135)
    Issue #29's Monte Carlo evidence (PR #130) showed the CDAC/comparator
    sizing as currently ratified does not meet the DRAFT INL/DNL (<=+-1 LSB,
    0.825/0.925 empirical yield vs 0.99 target) or ENOB (>9.0 bit baseline,
    8.491/7.749 bit mean/worst-case) target rows. A genuine redesign would mean
    reopening the RATIFIED CDAC unit cap (DR-003 via #27) at roughly a 9.9x
    area cost (quantified in DR-007's "Alternatives considered") -- out of
    scope for this issue. Instead, DR-007 proposes revised, evidence-derived
    candidate targets (INL/DNL <= +-2.0 LSB, ENOB >7.5/>8.0 bit baseline/
    stretch) that #29's own data actually cl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
2026-08-28 sim: dedup _run_klt_yield across run_mc.py and run_enob.py (#131) (#136)
    Extract the byte-identical tempfile/subprocess/parse/cleanup plumbing PR
    sim/enob-estimate/run_enob.py into a single evidence.run_klt_yield()
    helper, matching the same class of PR-introduced duplication already
    fixed by #115/#118 and #127/#128. Each caller keeps its own
    measurements-list construction at the call site; only the klt-invocation
    plumbing moves. Verified via a new unit test (missing-klt, timeout,
    malformed-JSON, error-key, and valid-report paths) plus a manual re-run
    of both drivers producing output identical to the pre-refactor records.
    Closes #131
    Co-auth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
2026-09-05 docs: add Chipalooza Challenge #4 (Sky130) brief proposal document (#140)
    Populates docs/chipalooza/challenge-4-proposal.md per issue #121 (Epic #542
    Phase 4B), honestly against this repo's own ratified spec and sim/ evidence:
    every spec row is marked MET/UNMET/DRAFT/BLOCKED with a dated citation, no
    row is relaxed or fabricated. Corrects the issue's own stale "1.8V digital /
    3.3V analog" rail assumption against the actual ratified spec (1.8V core
    throughout, no separate analog rail). The brief's post-layout PVT + DRC/LVS-
    clean top-level GDS sign-off bar is explicitly marked UNMET/BLOCKED on the
    already-tracked layout epic (#25/#103) rather than claimed or invented.
    Part of #121
    Co-author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
2026-09-05 layout: isolated PMOS well/tap islands for the sampling front end's Sa/Se BOOST body tie (#122) (#123)
    * layout: isolated PMOS well/tap islands for the sampling front end's Sa/Se body tie
    design/sampling_frontend.sch's DR-004 requires a non-standard PFET body tie:
    Sa_p/Se_p tie body to BOOST_P and Sa_n/Se_n to BOOST_N (nodes that rise above
    VDD during sampling), while the block's other five PFETs tie body to VDD. A
    PMOS body is not a wire -- it is the n-well the device sits in -- so honouring
    that requires three physically separate, individually tapped n-well islands.
    Issue #99 was blocked on whether that is composable at all with klt 0.3.0.
    Adds layout/sampling-frontend-wells/: the sampli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
    [build_layout.py, render-record.py]
2026-09-05 feat(champion): standing authorization for design-evidence auto-merge (#6850)
    Operator ruling 2026-09-05: Judge-approved, green-CI PRs whose entire
    changed-file set lives in design/, sim/, layout/, measurements/,
    verification/, or docs/ auto-merge without the four-axis human hold.
    Rationale: canary design evidence is fully revertible with no fleet-infra
    blast radius, and the held-PR pattern (sky130-sar-adc#123 sat mergeable for
    days as the sole blocker of a layout chain) costs more than it protects
    here. spec/ and every tool surface fall outside the patterns, so the
    exact-subset rule keeps them on the four-axis judgment automatically.
    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
2026-09-05 feat: reach clean LVS for the SAR sequencer layout (issue #102) (#141)
    Bumps klayout-tools 0.3.0 -> 0.4.0 (klayout-tools#1385's own fix) and
    switches the LVS step to `klt extract --def-pins` for clean top-level pin
    promotion on the DEF-merged GDS. That alone still left a full mismatch;
    root-caused two further issues in this repo's own files (not a klt gap):
    1. `requests/place-and-route.json` had no `power` block, so `klt
    place-and-route` only drew a row-rail obstruction, leaving VPWR/VGND as
    7 disconnected islands each instead of one global net per rail. Added a
    real PDN (tapcell + met1/met4/met5 straps, parameters from
    OpenROAD-flow-scripts' own published sky130hd PDN config).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
    [generate-lvs-reference.py, sar_sequencer.v, sar_sequencer_post_route.v]
2026-09-05 layout/sampling-frontend-wells: adopt _flow_common.sh + strict render-record helper (#144)
    run-flow.sh now sources layout/bin/_flow_common.sh and calls
    require_klt/require_pdk/new_record_id instead of reimplementing them
    inline, matching the substitution issue #139 already made for the other
    four flow scripts. The klayout-binary check stays inline since it's
    genuinely new to this flow.
    Extracts the strict _load/_git/argparse-skeleton trio duplicated
    byte-for-byte across layout/bin/render-record.py, layout/comparator/bin/
    render-record.py, and layout/sampling-frontend-wells/bin/render-record.py
    into a new layout/bin/_record_common_strict.py, imported by all three.
    Kept as a separate module f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
    [render-record.py]
2026-09-05 sim: quantify VCM drive-impedance/decoupling budget for sampling front end (#145)
    docs/chipalooza/challenge-4-proposal.md (PR #140) named an open item: every
    testbench in this repo drives VCM ideally, so no drive-impedance/decoupling
    budget existed for the shared VCM net the sampling front end's Cmswn/Cmswp
    switches tie to. This adds a single-corner (tt/27C/1.8V) sweep against the
    unmodified sampling-frontend DUT that replaces the ideal VCM source with a
    series R_source (plus optional on-die C_decouple) and measures the resulting
    differential sampled-value error, at both the DR-006-derived worst-case
    acquisition window (83.3 ns) and this repo's pre-existing 400 ns testbench
    convention.
    Resu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
2026-09-05 docs: correct stale #102 LVS status in Chipalooza #4 proposal (#147)
    Section 7 Item 1 still said the SAR sequencer layout's (#102) LVS was
    "currently blocked", left over from before #141 closed it. §3 and the
    §4 spec table already correctly cite #102 as done; this brings Item 1
    into agreement so the sole remaining blocker on #103's top-level
    assembly (and thus the brief's sign-off criterion) is #99 alone.
    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
2026-09-05 simplify comparator PEX: single `klt pex` call replaces #1395/#1396 workaround (#146) (#153)
    Both upstream klayout-tools bugs run_pex.py worked around (models.lib
    mis-resolution, sky130 unit-suffix mismatch) are fixed in the pinned
    klt==0.4.0 -- verified by re-running the old workaround against 0.4.0
    first: klt extract now emits bare-micron geometry natively, so the old
    normalize_extracted_units.py step double-converts already-bare values and
    corrupts device geometry (confirms the workaround went from unnecessary to
    actively harmful, not just redundant).
    - run_pex.py now calls `klt pex <gds> pex_request.json --deck sky130 --pdk
    sky130A --pdk-root $PDK_ROOT` directly for the re-simulate-bo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
2026-09-05 fix: remove 3 ruff F401/F841 dead-code findings (#154)
    Removes unused `re` import in generate-lvs-reference.py, unused `math`
    import in run_hold_kick.py, and an unused local `cdac_record_path`
    assignment in run_enob.py -- confirmed via manual grep that none of
    these names are referenced anywhere else in their files.
    `ruff check --select F401,F841 .` now reports zero findings (was 3).
    Closes #150
    [generate-lvs-reference.py]
2026-09-05 layout(sampling-frontend-wells): retire hand-written n-well DRC deck, klt 0.4.0 closed the gap (#155)
    klt 0.4.0's curated sky130 deck now carries nwell.width.1/nwell.space.1
    (2AMLogic/klayout-tools#1420), which inverts this sub-block's old verdict 5
    (the curated deck used to report a deliberately-illegal n-well split fixture
    "clean"; it now reports violations). Measured directly against klt 0.4.0
    (already the pin on main via #102/PR #141 -- no requirements.txt bump needed
    here).
    Retires drc/nwell_isolation.drc and the --engine klayout DRC stages it drove
    (this environment has no working `klayout` binary at all, so those stages
    were unrunnable here regardless): the old four DRC verdicts (cur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
    [build_layout.py, render-record.py]
2026-09-05 fix: stop combine_devices from folding CDAC array LVS nondeterministically (#157)
    Re-running `klt lvs` against reports/20260825-132454-51cbdd4/'s own
    committed, byte-identical cdac_array.gds/lvs-reference.spice never
    reproduces its recorded "match" verdict -- 10/10 repeat runs report
    mismatch instead, across every klt/klayout version combination tried,
    including the exact toolchain the record's own provenance block stamps.
    Root cause: options.combine_devices, needed to fold each bit's up-to-256
    physically drawn unit capacitors into one device before comparing against
    a reference that declared a single combined C card. klayout.db.Netlist.
    combine_devices() does not reliably re-sum that many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
    [generate-lvs-reference.py, render-record.py]
2026-09-05 sim: quantify CDAC-array bit-trial switch-Ron settling budget (issue #121) (#156)
    Adds sim/cdac-bit-trial-settling/, a first-pass, single-corner
    (tt/27C/1.8V) settling-time budget for the CDAC array's own bottom-plate
    switch/top-plate-node RC mechanism during a single bit's own bit-trial
    phase (design/cdac/cdac_array.sch), made possible now that both that
    schematic and design/comparator.sch exist (DR-006, written before either
    did, explicitly deferred this).
    Every one of the array's 9 per-side bit switches is the same fixed
    transistor size regardless of bit weight while the capacitor it drives
    scales binarily (1..256 unit caps) -- a two-node linear-circuit derivation
    predicts the top-plate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
2026-09-05 layout: sampling front end sub-block, DRC- and LVS-clean (#99) (#152)
    Physical layout for the whole sampling front end of this SAR ADC, drawn
    against design/sampling_frontend.sch: 24 devices (11 nfet, 9 pfet, 4 MiM
    caps) across 17 nets, verified end to end with klt's draw -> DRC -> extract
    -> LVS flow and recorded under the layout/trivial-cell/ record convention.
    Eleven verdicts, seven positive and four negative, all PASS:
    DRC clean on the composed layout and on every generated block in isolation;
    the deliberately-illegal n-well fixture reports violations naming
    nwell.space.1 on that same deck; precheck passes; extraction reports exactly
    the schematic's device population, no single-terminal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
    [build_layout.py, render-record.py]
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2026-09-05 docs: refresh Chipalooza #4 proposal for #99-#102 closure and #103 unblocking (#160)
    All four SAR ADC sub-block layout issues (#99 sampling front end, #100
    CDAC array, #101 comparator, #102 SAR sequencer) are now closed and
    DRC/LVS-clean. Update the proposal's §3 physical-readiness summary, the
    §4 spec table's post-layout-PVT row, and §7 Item 1 to reflect this and
    to note that #103 (top-level layout assembly) had its dependency
    checklist cleared by Curator on 2026-09-05 (loom:blocked removed,
    loom:curated applied) but has not yet been built — it remains the sole
    blocker for acceptance criterion 3.
    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
2026-09-06 docs: sync Chipalooza #4 proposal with #103's claim/build status (#162)
    Since PR #160 last refreshed this doc (merged 2026-09-05T23:59:52Z), #103
    (top-level layout assembly) advanced past "unblocked but not yet claimed":
    Champion promoted it to loom:issue (2026-09-05T23:47:57Z) and a Builder
    claimed it (loom:building, lease acquired 2026-09-05T23:52:56Z). Update
    §3 and §7 Item 1 to say #103 is actively being built, not merely unblocked
    and idle -- it is still OPEN with no top-level GDS evidence committed, so
    acceptance criterion 3 stays UNMET/BLOCKED, unchanged.
    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
2026-09-06 layout: seln-inverters glue macro + verified top-level assembly blocker (#103) (#166)
    Adds layout/seln-inverters/ (issue #103's own new top-level glue logic --
    the nine sky130_fd_sc_hd__inv_1 instances design/sar_adc_top.sch adds
    directly to compute SELn<i> = NOT(DOUT<i>) for the CDAC array's N-side
    switch control), placed and routed via klt place-and-route and verified
    DRC-clean/LVS-clean (re-run in this session, byte-identical verdict).
    Investigated the full top-level composition (placing/routing #99-#102 plus
    this macro per design/sar_adc_top.sch's hierarchy) and found, via direct
    inspection of cdac_array's (#100) committed GDS, that two of its pins have
    no externally-contactable landing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
    [generate-lvs-reference.py, render-record.py, seln_inverters.v, seln_inverters_post_route.v]
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2026-09-06 fix: check-promotion-landed.sh OK short-circuit didn't fire for the normal write-then-verify label ordering (#164) (#168)
    Two compounding bugs caused a real double-Builder-claim + false
    operator-only escalation on issue #103:
    1. The OK-timeline-confirmation check required the `labeled loom:issue`
    timeline event to be AFTER the newest APPROVED comment. But Step 3b's
    documented write-then-verify flow applies the label FIRST, verifies it
    with a read-back, and only THEN posts the verdict comment -- so the
    genuine, common case has the label event BEFORE the comment (by however
    long the read-back took; 16s on #103). The strict "after" comparison
    could never match this shape.
    2.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
2026-09-06 docs: sync Chipalooza #4 proposal with #165's claim status (#169)
    established "Part of #121" partial-increment pattern (eight prior merged
    increments, most recently #167).
    Live re-check this pass found #165 (the cdac_array VDD/SELp/SELn
    landing-geometry gap blocking #103) had advanced past what PR #167
    (merged 2026-09-06T01:44:32Z) described: #165 was claimed by a Builder
    (loom:building, lease acquired 2026-09-06T01:40:47Z) just before #167
    merged, so #167's "not yet claimed" wording was already stale by the
    time it landed.
    Evidence checked live this pass:
    - `gh issue view 165 --json state,labels` -> OPEN,
    ["loom:building"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
2026-09-06 docs: sync Chipalooza #4 proposal with #165's closure via PR #170 (#173)
    established "Part of #121" partial-increment pattern.
    landing-geometry gap that had re-blocked #103) closed via PR #170
    (merged 2026-09-06T02:19:15Z), advancing past #169's description of it
    as "claimed by a Builder". Updated all three references to #165 in
    docs/chipalooza/challenge-4-proposal.md (functional description §3,
    the acceptance-criteria table §4, and §7 item 1) to describe the fix
    (n-well tap for VDD, poly landing pads for the 18 SELp/SELn nets,
    DRC/LVS re-verified clean, extr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
2026-09-06 docs: sync Chipalooza #4 proposal with klayout-tools#1513's closure (#181)
    klayout-tools#1513 (the upstream `klt extract` pin-declaration gap
    blocking #103's LVS-clean verdict) closed 2026-09-06T06:45:36Z, fixed
    by klayout-tools#1515 (`--pin-source-cells`, merged the same minute).
    Not yet consumable: PyPI's klayout-tools package still tops out at
    0.4.0, the version already pinned in layout/requirements.txt -- the
    fix is merged upstream but not yet cut into a release.
    Updates §3, §4 (DRC/LVS-clean GDS row), and §7 Item 1 to replace the
    stale "open as of this pass" language with the current, narrower block
    reason (waiting on a klayout-tools release, not an open upstream
    question), and reco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
2026-09-06 fix: comparator reset-integrity topology defect (DR-004 Amendment A) (#183)
    Moves the cross-coupled NMOS latch pair's sources off hard-wired GND onto
    the input pair's own precharged drain nodes (DIP/DIN, two new CLK-gated
    PMOS precharge devices), closing the DC path that let the pre-amendment
    9-device topology's reset phase amplify corner/temperature asymmetry to
    the rails before the evaluate edge (3 of 9 ratified corners failing the
    Vindiff = 0 mV reset-integrity control, per #121's campaign).
    - design/comparator.sch: 9-device -> 11-device StrongARM arrangement.
    - Re-netlisted sim/comparator-decision/testbench/comparator_core.spice
    and re-pinned design/sar_adc_top.spice's schematic hash.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
    [comparator.sch]
2026-09-06 fix: remove dead ports field from parse_verilog_netlist (#184)
    The `ports` element of the 3-tuple returned by
    generate-lvs-reference.py's parse_verilog_netlist() was always empty
    (`return top_name, [], instances`) and immediately discarded at its
    only call site (`_unused_ports`). Match the sibling
    seln-inverters/bin/generate-lvs-reference.py's honest 2-tuple shape.
    Verified: regenerating sar_sequencer.lvs-reference.spice from the
    existing post-route netlist produces byte-for-byte identical output.
    Closes #182
    [generate-lvs-reference.py]
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2026-09-06 layout(comparator): re-draw for DR-004 Amendment A's 11-device topology (#180) (#188)
    * layout(comparator): re-draw for DR-004 Amendment A's 11-device topology (#180)
    Adds a sixth klt gen block (rstd, the M_RST_DIP/M_RST_DIN CLK-gated
    precharge pair), wires DIP/DIN into the floorplan and routing with the
    same mirror-symmetry treatment OUTP/OUTN already had, and re-routes the
    latch NMOS source terminals off the GND rail onto DIP/DIN -- matching
    the amended schematic issue #175 landed. Re-establishes a clean
    six-verdict LVS/DRC record (reports/LATEST re-pointed), re-derives both
    negative-control netlists from the amended reference, re-runs the PEX
    flow (flagging a pick-off-timing question fil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
    [build_layout.py, render-record.py]
2026-09-06 docs: sync Chipalooza #4 proposal with #180's comparator re-draw (#121) (#189)
    Issue #180 (comparator layout re-draw for DR-004 Amendment A's 11-device
    topology) closed via PR #188, which re-established layout/comparator/'s
    own LVS match and re-verified layout/sar-adc-top/ against the updated
    geometry (fresh record 20260906-101939-1250ff4, reports/LATEST). Updates
    the proposal's §3, §4, and §7 (Items 1 and 3) to cite the current
    records instead of the stale pre-#180 ones, restate the current
    device/pin counts, and note the non-gating PEX sign-flip finding
    tracked as #187.
    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
2026-09-06 layout/comparator/pex: re-derive pick-off timing for DR-004 Amendment A (#187) (#190)
    Fixes regen_probe.py's investigation driver (an interrupted prior attempt,
    inherited untracked): a str.format()/n_vectors mismatch bug meant the
    "outp"/"outn" series it measured were actually v(CLK) and the real v(OUTP),
    with the true v(OUTN) column silently dropped, producing a spurious
    sign-flipped-looking regeneration signature. After fixing both bugs, a real
    reset->evaluate transient sweep against the extracted (parasitic-loaded)
    leg confirms the root cause: the original PICKOFF_AT_NS=5.4ns instant was
    calibrated against the pre-#175 topology and is genuinely too early for
    this topology's extracted leg,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
2026-09-06 layout: dedup render-record.py main() body into _record_common.py (#192)
    sar-sequencer's and seln-inverters' render-record.py main() bodies were
    byte-for-byte identical except for the H1 title string. Extract the shared
    body into _record_common.py's render_pnr_drc_lvs_record(title, args),
    generalizing the LVS "known blocker" prose to point at "this sub-block's
    own README" instead of a hardcoded sar-sequencer path -- which fixes the
    copy-paste bug where the seln-inverters copy pointed readers at
    sar-sequencer's README for LVS provenance details.
    Closes #191
    [render-record.py]
2026-09-06 docs: sync Chipalooza #4 proposal with #187's closure via PR #190 (#194)
    Issue #187 (the comparator PEX sign-flipped extracted-side gain, flagged
    as a non-gating open item in §7 Item 3) has since closed: PR #190
    confirmed the fixed 5.4ns pick-off instant was stale for the amended
    (DR-004 Amendment A) topology's extracted leg and re-derived a corrected
    6.3ns instant, at which both legs give correctly-signed positive gains
    and the original "routing-driven offset is noise against device
    mismatch" conclusion holds on a validated, non-sign-flipped measurement.
    Restates §7 Item 3's closing paragraph accordingly, citing the new
    records (layout/comparator/reports/20260906-144802-eace0b6/,
    20260906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
2026-09-06 docs: re-trace Chipalooza #4 proposal's ENOB/INL-DNL rows to current evidence (#198)
    §4's ENOB row was one amendment stale and its verdict was overstated, and
    its INL/DNL row claimed a DR-007-candidate re-evaluation did not exist when
    one does.
    - ENOB row cited `sim/enob-estimate/records/20260828-005033-0c70212.md`
    (8.491/7.749 bit), composed from the pre-DR-004-Amendment-A comparator
    noise figure of 0.9591 mV rms — while the comparator-noise row directly
    above it already cited the amended 0.8643 mV rms figure, and the
    machine-checked docs/characterization-report.md already carried the
    re-composed 8.506/7.755 bit figures. Row now cites both the
    manifest-pinned post-amendment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
2026-09-06 refactor: drop unused json import and unused pdk-info binding (#201)
    Two ruff F401/F841 dead-code findings, no behavior change:
    - layout/sar-adc-top/bin/render-record.py: remove `import json`. The
    module only ever calls `load_json()` (imported from `_record_common`);
    the stdlib `json` module itself is never referenced.
    - sim/comparator-decision/run.py: in `run_regen_corners()`, drop the
    unused `info =` binding while keeping the `pdk.resolve_or_raise()`
    call itself. That call is a deliberate fail-fast guard, not a pure
    accessor -- it raises RuntimeError on an unresolvable PDK before the
    corner grid burns any simulator time -- and `run_regen_sweep()`
    re-resolves its own PdkInfo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
    [render-record.py]
2026-09-06 refactor(harness): dedup runner.write_evidence()'s Corner matrix run line onto corners_mod.corner_matrix_summary_line() (#202)
    runner.py's write_evidence() hand-rolled the "Corner matrix run" evidence
    bullet instead of calling the already-extracted helper (added by #127/#128
    but never migrated here), so its output silently drifted out of format
    sync with the 3 experiment drivers that already use the shared helper --
    missing the ", one-at-a-time per sim/README.md)" suffix. Call the helper
    instead, matching the shape used at the other 3 call sites.
    Closes #200
2026-09-06 sim: quantify SAR sequencer CLK-to-phase-output logic-delay budget (issue #121) (#203)
    Adds sim/sequencer-logic-delay/, a first-pass, single-corner (tt/27C/1.8V)
    propagation-delay measurement for design/sar_sequencer.sch's own walking-one
    ring sequencer: for all 11 CLK-edge-driven phase transitions (ph_b9..ph_b0,
    ph_eoc), the delay from the triggering CLK edge's 50% crossing to that
    phase's own 50% crossing. Worst case 0.3123 ns (phase b1), a 266.9x margin
    inside the DR-006-derived 83.333 ns worst-case bit-trial phase budget --
    isolating the sequencer's own logic-delay mechanism from the two other
    sample-rate contributors already probed (CDAC array switch settling,
    comparator decision delay)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
2026-09-06 sim: quantify sampling front end acquisition-window settling budget (issue #121) (#204)
    docs/chipalooza/challenge-4-proposal.md Section 7 Item 2 named the sampling
    front end's own acquisition-window timing as the fourth and last
    unquantified mechanism feeding the DRAFT sample-rate row, after CDAC
    settling, comparator decision delay, and sequencer logic delay were each
    measured in prior passes. This isolates and quantifies it: a two-pulse
    SAMPLE stimulus settles TOP_P/TOP_N to one rail-adjacent extreme, steps
    VINP/VINN to the opposite extreme while Msw is off (the worst case for a
    near-Nyquist input), then measures the second SAMPLE assertion that
    reconnects the switch to the new value.
    Find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
2026-09-06 sim: take sampling front-end acquisition-window settling to full PVT grid (issue #121) (#206)
    Extends the single-corner (tt/27C/1.8V) finding from PR #204 -- that the
    sampling front end's own acquisition of a new worst-case differential input
    value does not clear the DR-006 worst-case (12 MHz) phase budget -- to the
    full ratified PVT corner set (9 one-at-a-time points), via a new --corners
    mode on run_acquisition_settling.py mirroring sim/comparator-decision/'s own
    regen-corners campaign.
    Finding: every one of the 9 ratified corners exceeds the provisional
    differential LSB's half-step at the DR-006 budget point. Binding corner
    tt_27c_1.62v: TOP_P residual 67.19 mV (~38.2x the half-LSB, 2.9x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
2026-09-06 refactor(layout): dedup hand-transcribed PFET device table (issue #208) (#210)
    `layout/sampling-frontend-wells/bin/gen_blocks.py`'s DEVICES and
    `layout/sampling-frontend/bin/gen_blocks.py`'s PFET_DEVICES were the same
    nine-row table, hand-retyped with the trailing net columns in different
    orders (S/G/D vs D/G/S). Extract both into a shared
    `layout/bin/_pfet_devices.py` module (matching the existing
    `_geometry_common.py`/`_record_common.py` shared-module convention),
    normalized on the D/G/S order sim/'s own SPICE cards use, and update the
    consuming loops/DEVICE_KEY construction in the wells flow's
    build_layout.py/render-record.py accordingly.
    Verified byte-identical `klt gen` GDS/JSON output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
    [build_layout.py, render-record.py]
2026-09-06 refactor(harness): dedup ratified tt/27C OAT-grid construction into corners.ratified_oat_grid() (#212)
    Adds corners.ratified_oat_grid(nominal_v, tolerance, process_corners,
    temps_c), which centralizes the supply_points() + oat_grid("tt", 27.0, ...)
    chain that sim/comparator-decision/run.py (run_regen_corners,
    run_noise_corners), sim/sampling-acquisition-settling/run_acquisition_settling.py
    (run_corners), and sim/sar-sequencer-behavioral/run_testbench.py (main) each
    hand-repeated identically, aside from a local VDD/NOMINAL_SUPPLY_V naming
    difference. Verified the new helper reproduces the exact same grid (content
    and order) each driver's manual chain produced before the change.
    Closes #211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
2026-09-06 sim: take SAR sequencer CLK-to-phase-output logic delay to full PVT grid (issue #121) (#213)
    Extends the single-corner (tt/27C/1.8V) finding from PR #203 -- that
    design/sar_sequencer.sch's own walking-one ring sequencer produces a valid
    one-hot phase-select output far inside the DR-006-derived worst-case (12 MHz)
    83.333 ns bit-trial phase budget -- to the full ratified PVT corner set (9
    one-at-a-time points), via a new --corners mode on
    run_sequencer_logic_delay.py mirroring sim/comparator-decision/'s own
    regen-corners campaign and sim/sampling-acquisition-settling/'s own --corners
    mode. The single-corner default path is unchanged; --corners is purely
    additive, and netlists the DUT once and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
2026-09-07 refactor(sim): dedup ratified OAT-grid construction in sequencer-logic-delay (issue #214) (#215)
    run_sequencer_logic_delay.py's run_corners() hand-repeated the
    supply_points() + oat_grid("tt", 27.0, ...) chain that PR #212
    centralized as corners.ratified_oat_grid(); this call site landed in a
    concurrent PR (#213) developed against the pre-#212 pattern and was
    missed by #212's migration. Switch it over -- verified byte-identical
    grid via corners_mod comparison and an end-to-end --corners run (9/9
    PVT points, all 11 phase delays).
2026-09-07 sim: take CDAC-array bit-trial settling to full PVT grid (issue #121) (#216)
    Extends the single-corner (tt/27C/1.8V) finding from PR #156 -- that
    design/cdac/cdac_array.sch's own switch-Ron/top-plate settling clears the
    DR-006-derived worst-case (12 MHz) 83.333 ns bit-trial phase budget by a
    wide margin -- to the full ratified PVT corner set (9 one-at-a-time
    points), via a new --corners mode on run_bit_trial_settling.py mirroring
    sim/comparator-decision/, sim/sampling-acquisition-settling/, and
    sim/sequencer-logic-delay/'s own campaigns. This closes the last
    "single-corner only" gap among the four named sample-rate mechanisms --
    all four are now PVT-complete.
    A pre-flight probe found the si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
2026-09-07 sim: dedup remaining oat_grid stragglers onto ratified_oat_grid() (issue #218) (#219)
    run_transfer.py and run_hold_kick.py were the last two call sites still
    hand-repeating the supply_points() + oat_grid() chain that
    ratified_oat_grid() (added for #211) exists to centralize. Mechanical
    substitution, no behavior change: verified the resulting (process, temp,
    supply) corner tuples are identical before and after, both by direct
    comparison of the old/new grid-construction code paths and by re-running
    run_transfer.py's actual sim entrypoint end-to-end.
2026-09-07 sim: take VCM drive-impedance budget's bare R_source sweep to full PVT grid (issue #121) (#220)
    docs/chipalooza/challenge-4-proposal.md Section 7 Item 6 named an open item:
    the VCM drive-impedance/decoupling budget was single-corner (tt/27C/1.8V)
    only. This adds a --corners mode to run_vcm_drive_budget.py, taking the
    bare (undecoupled) R_source sweep at the DR-006 worst-case (83.333 ns)
    window to the same 9-point ratified OAT PVT grid the other Section 7 Item 2
    mechanism campaigns already use.
    Finding: unlike those other mechanisms, the single-corner figure
    understates the real worst case. The tt/27C/1.8V point reproduces the
    existing single-corner record's <= 10 kOhm budget exactly, but th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
2026-09-07 layout: dedup Rect.hwire()/vwire() onto the shared _geometry_common base (#223)
    sampling-frontend-wells and sampling-frontend each hand-rolled a byte-
    identical hwire()/vwire() classmethod pair on their own local Rect(_Rect)
    subclass. Move both onto the shared Rect base in
    layout/bin/_geometry_common.py (plus the WIRE_UM default-width constant
    their signatures depend on), drop the ~16 duplicated lines from both
    sub-blocks, and correct the two now-stale docstrings that described
    hwire()/vwire() as sub-block-specific.
    Verified byte-identical draw.request.json/compose.request.json output by
    re-running build_layout.py against each sub-block's last recorded klt-gen
    block reports, before and afte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
    [build_layout.py]
2026-09-07 layout: source _flow_common.sh in sampling-frontend's run-flow.sh (#224)
    layout/sampling-frontend/bin/run-flow.sh was the last of the eight
    layout flow scripts still hand-repeating the KLT-executable check, the
    PDK-resolvable check and the TS_UTC/SHORT_SHA record-id construction that
    layout/bin/_flow_common.sh already centralizes as require_klt,
    require_pdk and new_record_id. Source the shared helper and call those
    three functions instead, dropping 12 duplicated lines.
    Behavior is unchanged, including the error text: the helpers derive their
    message prefix from ${BASH_SOURCE[1]}, which is this script, so both
    failure paths still print "run-flow.sh: ..." and exit 1 -- verified by
    running the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
2026-09-07 sim: take VCM drive budget's legacy-window R_source sweep to full PVT grid (issue #121) (#225)
    Closes the "higher-priority next step" flagged by the prior worst-case-window
    full-grid pass: extends sim/vcm-drive-budget/run_vcm_drive_budget.py's
    --corners mode with a --window {worst,legacy} selector and re-runs the bare
    (undecoupled) R_source sweep across all 9 ratified PVT corners for the
    legacy (400 ns) testbench-convention window.
    Result is the opposite shape from the worst-case window's own full-grid
    finding: there, the single-corner tt/27C/1.8V point was the loosest corner
    and the grid tightened it 10x; here, tt/27C/1.8V is one of four corners
    already at the zero-margin floor, while a di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
2026-09-07 layout: resolve top-level SAR ADC LVS pin declaration; new combine_devices blocker found (#103) (#227)
    Wires layout/sar-adc-top/bin/run-flow.sh's LVS signoff step to
    `klt extract --pin-source-cells` (klayout-tools#1515) instead of the
    name-matching `--def-pins` mechanism, and gives the flow's own routing
    cell a globally-unique name (SAR_ADC_TOP_ROUTE, not the generic ROUTE
    every other build_layout.py flow in this repo uses) so
    `--pin-source-cells` can resolve it unambiguously once all five
    sub-block GDS files are merged. This closes klayout-tools#1513: `klt
    lvs` now reaches an exact 19/19/19 promoted/reference/matched pin
    correspondence, where none of --top-cell-pins/--pins/--def-pins could.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
    [render-record.py]
2026-09-07 sim: take VCM drive budget's worst-case-window C_decouple sweep to full PVT grid (issue #121) (#226)
    Closes the "natural next step" flagged by the prior legacy-window R_source
    --corners mode with a --sweep {rsource,decouple} selector and re-runs the
    C_decouple sweep across all 9 ratified PVT corners at the DR-006 worst-case
    (83.333 ns) acquisition window.
    Unlike the two bare R_source full-grid passes, each corner is decoupled
    against its OWN marginal R_source (marginal_r_source(), factored out of the
    single-corner path and re-derived per corner from that same corner's own
    bare sweep) rather than a value borrowed from tt/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
2026-09-07 sim: generalize mc_runner._draw_n() to a callback, dedup run_mc.py's hand-rolled loop (issue #228) (#231)
    _draw_n() was hardcoded to mc_runner's manifest-based netlist build +
    measure.parse(), so cdac-array-transfer/run_mc.py -- which needs its
    own build_netlist()/_parse_draw() -- had to hand-roll the same
    two-arm (mismatch-enabled + negative-control), same-seed-sequence
    draw loop inline instead of reusing it.
    Generalize _draw_n() to take a one_draw_fn(corner, seed, scratch_dir,
    log_name) -> Draw callback plus a describe_fn(Draw) -> str for the
    per-draw print suffix (each caller's Draw shape differs). run()
    passes a closure over its existing manifest/pdk_info build+parse
    logic, so its own c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
2026-09-08 docs: sync Chipalooza #4 proposal with PR #227's LVS pin-declaration fix (issue #121) (#232)
    PR #227 resolved the klayout-tools#1513 top-level LVS pin-declaration
    blocker (renamed the routing cell, signed off with --pin-source-cells),
    reaching an exact 19/19/19 promoted/reference/matched pin correspondence
    for the first time. That surfaced a second, distinct blocker —
    options.combine_devices has no per-subcircuit scoping across the five
    composed sub-blocks — filed at klayout-tools#1552 and already fixed
    upstream (klayout-tools#1556), but not yet in a published klayout-tools
    release. #103 remains loom:blocked, now waiting on a release newer than
    the PyPI-pinned 0.4.0 that includes both fi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
2026-09-08 sim: take VCM drive budget's legacy-window C_decouple sweep to full PVT grid (issue #121) (#233)
    * sim: take VCM drive budget's legacy-window C_decouple sweep to full PVT grid (issue #121)
    Closes the last remaining single-corner-only leg of the VCM drive-
    impedance/decoupling budget: the legacy (400 ns) testbench window's own
    C_decouple sweep, run via --corners --window legacy --sweep decouple,
    the same option combination already used for the worst-case window.
    Decoupling alone rescues all 9/9 ratified corners at this window too,
    sized per-corner against each corner's own marginal R_source. All four
    legs of this budget (bare R_source and C_decouple, at both windows) are
    now PVT-complete; do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
2026-09-08 docs(chipalooza): add klayout-tools#1557/#1560 to LVS device-match blocker citations (#234)
    Re-verified live against the forge: #103's LVS device-match blocker now
    has a third merged-but-unreleased upstream fix (klayout-tools#1560,
    commit 2d603ba5, fixing #1557) alongside #1515/#1556 — klayout-tools
    still tops out at v0.4.0 on PyPI and the repo's own tags, so none of the
    three have reached a release. Verdict unchanged: #103 stays
    loom:blocked, acceptance criterion 3 stays UNMET/BLOCKED; only the
    citation list grows from two fixes to three.
    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
2026-09-08 docs(chipalooza): track sampling front-end acquisition design-fix as issue #236 (#237)
    sim/sampling-acquisition-settling/'s full-PVT-grid campaign found the
    bootstrapped sampling switch's acquisition does not clear the DR-006
    12 MHz phase budget at any of the 9 ratified corners (bootstrap
    precharge PFET Sa's reverse-Vds off-state droop) -- the only one of
    four sample-rate mechanisms to fail the budget anywhere on the grid.
    No issue tracked the implied circuit-fix/non-uniform-phase-allocation
    follow-up, since #121 is a documentation/evidence-compilation issue,
    not a design-fix issue. Files #236 to track that follow-up and points
    Section 7 Item 2 and the sample-rate spec row at it.
    Part of #1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
2026-09-08 docs(chipalooza): correct three superseded layout-record citations (issue #121) (#242)
    Audited every layout/*/reports/LATEST pointer against what
    challenge-4-proposal.md cites and found three stale paths (cdac-array,
    sampling-frontend, sar-sequencer), each verified by diffing the
    superseded record against the current one directly. The sar-sequencer
    Power-row citation was the most material: it still pointed at the
    pre-#102-fix record reporting an LVS mismatch, contradicting the
    document's own "#102 done, LVS-clean" statements elsewhere.
    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
2026-09-08 design: fix sampling front end acquisition-window phase-budget failure (issue #236) (#246)
    design/sampling_frontend.sch's bootstrap precharge PFET Sa was gated by
    SAMPLE, a VDD-level signal, while Sa's own source is BOOST_x (driven to
    ~VIN+VDD during sampling) -- leaving V_sg = BOOST_x - VDD ~= VIN, an ON
    device discharging the boosted node throughout the sample phase instead
    of the leaky-off device the original root-cause trace assumed. Re-gate
    Sa's gate from the switch's own gate node G_{p,n} instead (already GND
    during hold via Sd, shorted to BOOST_x by Se during sampling), so Sa is
    genuinely off (V_sg ~= 0) for the whole sample phase.
    With that fixed, the common-mode reference transmiss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
    [sampling_frontend.sch]
2026-09-08 design(sampling-frontend): re-verify LVS and re-derive VCM drive budget post-#236 (#249)
    Re-derives the three artifacts issue #236's Sa gate-net move and Cmsw
    W=1um->W=16um widening invalidated: `layout/sampling-frontend/reference.spice`
    (and its three broken-* negative-control fixtures) now gate M_SA_P/M_SA_N
    from G_P/G_N and size M_CMSWN_*/M_CMSWP_* at W=16U to match
    design/sampling_frontend.sch exactly; `gen_blocks.py` carries a local
    post-#236 override on top of the still-pre-#236 shared `_pfet_devices.py`
    table (left untouched so `sampling-frontend-wells/` -- out of scope here,
    tracked as issue #248 -- keeps its own LVS match); the sub-block's
    draw->DRC->extract->LVS flow was re-run (DR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
    [build_layout.py]
2026-09-08 design(layout,sim): reconcile wells sub-block + --corners records post-issue-#236 (issue #248) (#250)
    Two independent tracks of post-#236 staleness that issue #245 explicitly
    kept out of its own scope.
    Track A -- layout/sampling-frontend-wells/ decision: TRACK, not pin.
    Recorded explicitly in that sub-block's own README. Its claim (PMOS
    body-tie domain isolation between BOOST_x and VDD) depends on neither
    field #236 changed, but leaving reference.spice pinned would mean its
    falsifiability fixtures negate a superseded netlist rather than the live
    one. So layout/bin/_pfet_devices.py's shared table now carries the
    post-#236 state (Sa_{p,n} gated from G_{p,n}, Cmswp_{p,n} at W=16um),
    reference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
    [build_layout.py]
2026-09-08 refactor(sim): dedup evidence-record provenance boilerplate in comparator-decision/run.py (#253)
    Replace the hand-rolled new_record_id() + write_netlist_snapshot[_text]() +
    pdk.resolve() preamble in all 5 write_*_evidence() functions with
    evidence.resolve_provenance(), matching the migration issues #235/#240/#244/
    #247 already applied to 8 other call sites. Drop the now-redundant
    netlist_sha computation/threading in the calling run_*() functions since
    resolve_provenance() derives the sha at write time instead.
    Closes #252
2026-09-11 sim: end-to-end full-conversion transient campaign (issue #254) -- 0/9 corners code-correct, mechanism-probe points at comparator-capture timing (#260)
    * sim(full-conversion-transient): testbench + driver for the end-to-end campaign
    Adds the experiment scaffolding for issue #254's end-to-end full-conversion
    transient campaign on the transistor-level `design/sar_adc_top.spice`:
    - `gen_full_conversion_tb.py` -- generates (and `--check`s) the committed
    stimulus/measurement fragment and owns the DR-006 timing schedule
    (`N + 2 = 12` uniform CLK periods per conversion at the worst-case
    `f_clk = 12 MHz`), the five DC differential inputs, and the ideal-code
    mapping from `spec/target-spec.m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
2026-09-11 fix: declare VPWR/VGND global so nested std cells stay powered (#261)
    design/sar_adc_top.sch instantiates design/sar_sequencer.sch as a nested
    `.subckt`, but the sequencer's sky130_fd_sc_hd standard cells reference
    VPWR/VGND as literal instance properties rather than schematic pins. With
    neither rail in the subcircuit's formal port list nor declared `.GLOBAL`,
    ordinary SPICE scoping made both rails private to the `xseq` instance, so
    the whole digital array floated whenever design/sar_adc_top.spice was
    simulated as a top-level circuit -- silently, as drifting intermediate
    voltages rather than as an error.
    Add two `global=true` label instances (lvpwr1 / lvgnd1) to the integration
    schematic, s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
    [sar_adc_top.sch]
2026-09-11 sim: node-level trace pins the SAR saturation on the comparator reset / capture-edge ordering (#259) (#262)
    * sim: add --node-trace diagnostic mode for the comparator capture-edge trace
    Issue #259 asks for a node-level trace of COMP_OUT against the bit-capture
    registers' sampling CLK edge, on the as-committed netlist, at
    tt_27c_1.62v and ff_27c_1.80v. The existing --mechanism-probe only counts
    codes and, to shift the strobe, runs a testbench-only MODIFIED netlist --
    it cannot say which edge relationship is at fault on the real DUT.
    --node-trace leaves the DUT byte-identical and appends read-only
    `.meas tran ... find v(...)` cards after the committed fragment, sampling
    CLK / COMP_OUT (OUTP)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
2026-09-11 fix: strobe the SAR comparator from CLKN so bit capture lands at the end of evaluate (#264)
    * fix(design): strobe the comparator from CLKN so bit capture lands at the end of evaluate
    design/sar_adc_top.sch tied comparator.CLK to the same top-level CLK net
    that every xbreg9..xbreg0 bit-capture register samples on. The comparator
    (design/comparator.sch) resets for the whole CLK=0 half-period and the
    registers capture on CLK's rising edge -- the edge that ENDS that reset
    half -- so every bit trial captured the comparator's post-reset "1" level
    instead of its decision, a half-period ordering fault no skew can close
    (node-level trace: sim/full-conversion-transient/records/
    20260911-103820-fd3526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
    [sar_adc_top.sch]
2026-09-11 fix: SAR trial perturbation, per-conversion clear timing, and decision-directed CDAC switching (#263) (#266)
    Fixes all three structural defects issue #263 diagnosed in the post-#257
    SAR search (no trial perturbation before each bit decision, no
    per-conversion CDAC clear, unconditional complementary SELp/SELn drive),
    plus two issues that same fix pass surfaced:
    - design/sar_sequencer.sch: PRESET<i>/DFEED<i> apply the trial
    perturbation and per-conversion clear for bits 8..0; the clear is
    gated by a new BUSY_BITS signal (excludes PH_EOC, unlike the
    pre-existing BUSY output pin) so the CDAC settles to its neutral state
    a full CLK period before the sampling switch opens, rather than rac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
    [sar_adc_top.sch, sar_sequencer.sch]
2026-09-12 Confirm common-mode-headroom root cause for ±0.78·V_REF saturation (#265) (#268)
    Adds TOP_P/TOP_N probes to run_conversion.py's node-trace infrastructure
    and a new `--cm-trace` diagnostic mode (issue #265) that traces the
    comparator's own input-pair nodes at conversions 1/5 (the two
    near-full-scale inputs that saturate/fail badly under decision-directed
    CDAC switching). The trace confirms DR-008's "Open items" leading
    hypothesis: single-side switching leaves one array side's top plate
    frozen at its raw sampled value for the whole conversion, forcing the
    active side to travel to that frozen value to converge -- for a
    near-full-scale input this droops the comparator's common mode 600-755 mV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
2026-09-12 fix: balance comparator output load and add a half-LSB quantizer offset (#270)
    Closes the mid-scale residual DR-008's open items left behind: with #263's
    first pass landed, the 9-corner campaign still read 2-3 LSB high at
    Vd = +0.00*V_REF and +0.25*V_REF, corner-invariantly.
    Root cause, measured rather than inferred: design/sar_adc_top.sch loaded
    comparator.OUTP (= COMP_OUT) with two standard-cell input pins inside xseq
    while leaving comparator.OUTN a dead-end net. In a StrongARM-class latch
    (DR-004) the evaluate phase is a regeneration race between the two output
    nodes, so that capacitance imbalance is a systematic input-referred offset
    with no device mismatch needed -- biased toward COMP_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
    [sar_adc_top.sch]
2026-09-15 docs(chipalooza): re-verify VCM drive budget post-issue-#236, refresh rules-4.html check (issue #121) (#271)
    Issue #236's sampling-frontend fix (Sa gate-net move, Cmsw W=1um->W=16um)
    invalidated the VCM drive-impedance/decoupling budget's own DUT netlist;
    issues #245/#248 (PRs #249/#250) re-derived all five records (single-corner
    plus all four full-PVT-grid legs) against the corrected netlist, and the
    proposal doc's §4 sample-rate row, §7 Item 1, and §7 Item 6 still narrated
    the pre-#236 findings as current (a materially different, looser result:
    uniform <=100 kOhm bare R_source and <=1000 pF C_decouple headroom at every
    ratified corner, vs. the pre-#236 30x corner spread and 4/9 zero-mar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
2026-09-15 docs(chipalooza): re-point §3 and §4's Area row at the current top-level layout record (issue #121) (#276)
    `layout/sar-adc-top/reports/LATEST` has read `20260908-072857-80df05e`
    since 2026-09-08 (issue #245's post-#236 re-run, PR #249), but §3 and §4's
    Area row still cited `20260907-110058-a546200` and labelled it
    "`reports/LATEST`". Both are re-pointed, with the equivalence verified
    artefact-by-artefact rather than assumed from the re-run's intent:
    - `compose.json` byte-identical between the two records (`cmp`) — the Area
    row's bounding box and 0.108 mm² figure do not move;
    - `drc.json` `violations: []` in both (differences: absolute GDS path and
    its `content_hash` only);
    - `lvs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
2026-09-15 fix(sim): index the five orphaned experiments in sim/spec-coverage.json (#279)
    `check:spec-coverage` has failed on `main` itself since these experiments
    landed: five directories under `sim/*/records/` hold committed evidence but
    appear nowhere in `sim/spec-coverage.json`, so the checker's
    `[orphan-experiment]` rule fails every open PR's headless CI job regardless
    of that PR's own diff.
    Index, not spec. No `spec/target-spec.md` value, status, or row changes; no
    record is edited (append-only); nothing DRAFT is presented as pass/fail.
    - Sample rate: `unbenched` -> `draft-informational`, with the four
    challenge-4 Section 7 Item 2 mechanism campaigns (`cdac-bit-trial-settling`,
    `sequencer-l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
2026-09-15 docs(chipalooza): cover full-conversion-transient campaign, refresh #103 blocker status (issue #121) (#273)
    - Sample rate row and new §7 Item 8: this document previously stated
    no full-hierarchy code-correctness campaign existed. sim/full-conversion-transient/
    (issue #254) does exist, found 0/9 corners code-correct on its first
    9-corner run, and drove five design fixes (#257, #258, #259, #263 x2
    via DR-008/DR-009). Two remaining root causes (#267: near-full-scale
    common-mode saturation from decision-directed CDAC switching; #269:
    ~1% CDAC absolute gain error from top-plate parasitic loading) are
    correctly loom:operator-only + loom:operator-decision -- architecture
    choices, n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
2026-09-15 docs(chipalooza): re-point §4 sign-off-bar rows at current sar-adc-top record (#282)
    Resolves the "Residual, deliberately deferred" citation gap §7 Item 1
    flagged on 2026-09-08: the two brief sign-off-bar rows (post-layout PVT,
    DRC/LVS-clean GDS) were deliberately left citing the one-record-old
    20260907-110058-a546200 report while PR #273 was concurrently editing
    those same rows for the klayout-tools v0.5.0 release. PR #273 has since
    merged and left the record ID untouched as predicted, so this pass
    re-points both rows (plus the deferred-note paragraph) to the current
    layout/sar-adc-top/reports/LATEST (20260908-072857-80df05e), verified
    byte-for-byte equivalent to the prior citation (compo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
2026-09-15 refactor(sim): dedup evidence.resolve_provenance() reinvention in run_mc.py/run_testbench.py (#284)
    run_mc.py's write_evidence() and both of run_testbench.py's record-writing
    blocks still hand-rolled the record-id/snapshot/sha/pdk_line/ngspice_line
    provenance preamble that evidence.resolve_provenance() (#235) already
    consolidates -- including a redundant second pdk.resolve() subprocess
    round-trip in run_mc.py. Replace all 3 call sites with a single
    resolve_provenance() call each, threading its ProvenanceInfo fields
    through the rest of each function.
    Verified byte-for-byte identical: on the same commit, running each
    experiment's --record path before and after this change produces the
    same ne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
2026-09-15 layout: bump klayout-tools to 0.5.0, retire sar-adc-top's SAR_ADC_TOP_KLT override (#103) (#275)
    * layout: bump klayout-tools 0.4.0 -> 0.5.0, retire sar-adc-top's SAR_ADC_TOP_KLT override (#103)
    klayout-tools v0.5.0 (published 2026-09-15) carries both fixes the
    top-level assembly flow's own env-var override was standing in for
    (#1515 `--pin-source-cells`, #1556 `options.combine_devices_per_circuit`),
    so the pin is bumped and the override retired -- run-flow.sh now runs
    entirely on the officially pinned klt.
    Re-running the full flow found DRC and the unfiltered connectivity check
    unaffected, but klt lvs does not reach a clean match and the mismatch
    count regressed from 98 to 124. Two upstre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
    [build_layout.py, render-record.py]
2026-09-15 docs(chipalooza): reflect PR #275's v0.5.0 LVS rebuild findings (issue #121) (#285)
    * docs(chipalooza): reflect PR #275's v0.5.0 LVS rebuild findings (issue #121)
    PR #275 (open, on #103) already ran the deferred klayout-tools v0.5.0
    build the proposal doc was still describing as pending. The LVS device
    match did not clear -- it regressed to 124 mismatches (from 98), root-
    caused to two new upstream gaps (klayout-tools#1876, #1878), both filed
    generically per this repo's friction protocol. Update §4's two sign-off-
    bar rows and §7 Item 1 to reflect this without moving any verdict.
    * docs(chipalooza): correct PR #275's merge status, re-point §4 citations onto reports/LATEST (issue #121)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
2026-09-15 fix(loom): guard grep no-match in champion hold-state check
    _check_champion_hold_state_staleness() in merge-pr.sh ran an unguarded
    `grep -o` under `set -euo pipefail`; a PR with comments but no
    champion:hold-state marker (the common case) made grep exit 1, which
    pipefail propagated into the plain assignment, silently killing the
    entire merge script with zero output before any merge was attempted.
2026-09-15 layout(sar-adc-top): work around klayout-tools#1876 locally, leaving #1878 as the only LVS blocker (#287)
    The top-level assembly's `klt lvs` attempt regressed when `layout/` bumped to
    the officially pinned `klayout-tools==0.5.0` (PR #275): 124 mismatches / 393
    matched nets, against a 98 / 412 pre-bump baseline. That delta was isolated
    to klayout-tools#1876 -- #1558/#1564's (correct) fix to stop writing an
    unsimulatable trailing class-name token on `C` cards also drops the capacitor
    device class from the SPICE text this flow's pre-extracted `layout.netlist`
    LVS shape round-trips through, so capacitors stop resolving to their
    reference-side counterpart by class name.
    That turns out to be reco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
    [render-record.py, restore-cap-device-class.py]
2026-09-16 layout(sar-adc-top): measure --abstract-cells black-boxing, narrows LVS to 6 mismatches, files klayout-tools#1911 (#103) (#290)
    Tries the third option klayout-tools#1878 itself proposed for #103's last
    unchecked acceptance criterion (LVS clean): treat the sub-blocks whose own
    combine_devices needs conflict (cdac_array, sar_sequencer, seln_inverters)
    as opaque black boxes via `klt extract --abstract-cells` (issue #620,
    already in the pinned klayout-tools==0.5.0 -- no version bump needed),
    compared against a matching hand-hollowed reference, instead of flattening
    everything into one combine_devices-scoped compare.
    Result against the same composed GDS as the existing 98-mismatch baseline:
    6 mi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
2026-09-16 fix(loom): guard grep no-match in champion hold-state check (#292)
    grep -o under set -euo pipefail; a PR with comments but no
    Reapplies commit 8984803, which a subsequent 'resync installed Loom
    surfaces' pass reverted because the upstream defaults/scripts/merge-pr.sh
    still ships the unguarded pipeline (tracked upstream at rjwalters/loom#7776
    and duplicates). Will need reapplying again after each resync until that
    lands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
2026-09-16 docs(chipalooza): re-point §3/§4 at #103's post-#275 LVS neutralization (issue #121) (#293)
    Two further Part-of-#103 increments landed after PR #285's last update
    (#287 neutralizes klayout-tools#1876 locally, restoring the pre-0.5.0
    98-mismatch/412-matched-net LVS baseline; #290 measures, but does not
    adopt, a 6-mismatch --abstract-cells shape pending klayout-tools#1911).
    Re-point the Area row and both sign-off-bar rows in §4, and §3's
    citation-freshness paragraph, onto the current reports/LATEST
    (20260915-234004-76f48b9) — no §4 verdict moves.
    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
2026-09-16 fix(loom): eliminate SIGPIPE/pipefail race in verify-proposal-refs.sh (#288) (#294)
    full_tree() { ... } | grep -qFx "$path" ran under set -o pipefail. When
    grep matched early it closed its end of the pipe while printf inside
    full_tree() could still be writing the rest of a large (~170KB) tree
    listing; the resulting SIGPIPE made printf exit non-zero, and pipefail
    turned that into a false pipeline failure — files that DO exist were
    nondeterministically reported MISSING.
    Replace the pipe with a here-string fed from a fully-buffered command
    substitution (grep -qFx "$path" <<< "$(full_tree)"), which has no live
    writer left for grep to SIGPIPE. Add a regression fixture (large tree,
    early-alphab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
2026-09-16 docs(chipalooza): correct klayout-tools#1876/#1878 status — both closed, one is docs-only (issue #121) (#297)
    Both upstream issues the current §3/§4/§7 Item 1 text cites as "open" have
    since closed: klayout-tools#1876 via a genuine code fix (klayout-tools#1921,
    merged but not yet in a published release — v0.5.0 predates it by 48
    commits), and klayout-tools#1878 via a documentation-only PR
    (klayout-tools#1924) that confirms, rather than closes, the underlying
    capability gap (klt extract still has no hierarchical/per-macro subcircuit
    output). No §4 verdict moves — DRC/LVS-clean GDS and post-layout PVT stay
    UNMET/BLOCKED, and #103 stays loom:blocked per its own fresh (2026-09-16)
    depe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
2026-09-16 fix(sim): migrate remaining _preamble() call sites to toolchain.deck_preamble() (issue #296) (#298)
    PR #289 (issue #205) deleted run_hold_kick.py's local _preamble() helper but
    migrated only the build_transient() call site to toolchain.deck_preamble(),
    leaving build_ac_capacitance() and build_full_load_transient() calling the
    now-undefined name -- both crash with NameError the instant the cap-extract
    or full-load experiment runs. Migrate both remaining call sites to match the
    already-fixed one, and add a regression test that calls every build_*
    deck-builder in the module so this bug class (an undefined name only
    reachable by actually calling the function) is caught by the unit-test
    stage goi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
2026-09-16 docs(chipalooza): correct §7 Item 1 / §3 stale "top-level layout does not exist" ledes, discharge deferred sampling-frontend re-point (issue #121) (#300)
    Two internal-consistency residuals in the Challenge #4 proposal doc. No §4
    spec-row verdict moves, and no new layout or simulation work is claimed.
    1. Stale headline claims, false since PR #174 (2026-09-06). §7 Item 1's
    heading read "Top-level layout does not exist (the largest gap)" and its
    lede "No assembled, DRC/LVS-clean GDS for sar_adc_top exists in this
    repo"; §3 carried the same bolded "No top-level assembled ADC layout
    (GDS) exists yet" immediately above its own "Top-level assembly has since
    landed" update. A co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
2026-09-16 fix(loom): re-apply SIGPIPE/pipefail fix in verify-proposal-refs.sh, fix dead cache (#302)
    A resync (673468c) silently reverted the c87523a fix for a SIGPIPE/pipefail
    race: `full_tree | grep -qFx "$path"` could report a false "MISSING FILE"
    when grep matched before printf finished writing the ~170KB tree listing,
    because pipefail turns printf's resulting SIGPIPE into a pipeline failure
    even though grep itself succeeded. Re-apply the here-string fix
    (`grep -qFx "$path" <<< "$(full_tree)"`), which leaves no live writer for
    grep to SIGPIPE.
    Also fix a second, independent bug in the same lines: FULL_TREE_CACHE was
    set inside full_tree(), invoked via $(full_tree) — a subshell — so the
    assign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
2026-09-16 docs(chipalooza): re-check rules-4.html publish status (issue #121) (#309)
    Fourth live re-check of https://opencircuitdesign.com/chipalooza/rules-4.html
    (prior: 2026-09-06, -08, -15) -- still HTTP 404, and the parent chipalooza/
    index's Last-Modified timestamp is unchanged since before the prior check, so
    the index itself has not been touched either. 2AMLogic/2am#542's own
    tracking table still lists Challenge #4 (Sky130, ChipFoundry) as "launches
    2026-11-09" -- unchanged across all four re-checks. No content change: this
    keeps Section 7 Item 7's "not silently assumed done" discipline current,
    same precedent as the prior three re-check entries.
    Investigated the rest of the document against c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
2026-09-16 docs(chipalooza): machine-check the proposal's citations, re-point one stale §4 row (#311)
    * docs(chipalooza): machine-check the proposal's citations, re-point one stale §4 row
    Turns the Chipalooza Challenge #4 proposal's own Test Plan line ("every
    spec-row verdict traces to a dated sim/layout record cited by path") into a
    headless CI gate, and fixes the one live instance it found.
    `docs/chipalooza/check_proposal_citations.py` (new, pure file reads -- no PDK,
    no ngspice, no network) checks four things about
    `docs/chipalooza/challenge-4-proposal.md`:
    1. every relative Markdown link target resolves;
    2. every backticked path into this repo's own top-level trees resolves too
    (not e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
2026-09-16 docs(chipalooza): record the release gate's grown contents (issue #121) (#312)
    The `klayout-tools` release gate #103 (and therefore this issue's
    acceptance criterion 3) waits on is unchanged in kind — still no release
    past `v0.5.0` on any of the three surfaces (GitHub tags, GitHub releases,
    PyPI) — but its contents have grown since the last recorded check:
    `compare/v0.5.0...main` is now `ahead_by: 79` (head `208203d6`), up from
    the `ahead_by: 61` recorded at `ad3f8363`.
    Three of the eighteen new commits touch the LVS/extract surface this
    document's §7 Item 1 tracks, and each is recorded with what it does and
    does NOT mean for this design, checked against this repo's own committed
    artef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
2026-09-16 docs(chipalooza): gate the citation checker's own coverage census (issue #121) (#315)
    The proposal's evidence gate (`check_proposal_citations.py`) checks only
    *attached* "current `.../LATEST`" claims, so the document states in prose how
    many of its claims that covers. That census was hand-written in three places
    -- the proposal's "Reproducing this table" note, the checker's module
    docstring, and `.github/workflows/ci.yml`'s inventory comment -- and all three
    went stale the first time the document grew: PR #312 (2026-09-16) added two
    pointer claims of the skipped kind, taking the document from 19 phrases to 21
    (re-derived from the two commits, not from the prose), while every copy still
    read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
2026-09-16 refactor(sim/full-conversion-transient): dedup evidence-record open/close boilerplate (#316)
    run_conversion.py's four record writers (write_record(),
    write_node_trace_record(), write_cm_trace_record(),
    write_decision_margin_record()) each repeated the same
    resolve-provenance/dump-raw-logs/start-markdown-header "open" boilerplate
    and write-file/print-confirmation/return-path "close" boilerplate. Extract
    both into sim/harness/evidence.py (open_record()/close_record()), alongside
    the resolve_provenance()/environment_block()/footer_lines() helpers it
    already provides -- keeping write_record()'s one genuine variation (the
    records/LATEST pointer update, and its dual corners+diagnostics log dump)
    a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
2026-09-17 docs(chipalooza): gate the sign-off-bar numbers, not just their citation (issue #121) (#318)
    Checks 3-5 of the proposal's evidence gate verify WHICH record a Section 4
    row cites. Nothing verified the figures the row quotes *out of* that record --
    and those are exactly what the brief's two sign-off-bar rows ("Post-layout PVT
    simulation, full ADC" and "DRC/LVS-clean GDS, full ADC, in-repo") are graded
    on: the `klt lvs` mismatch count, the three-way device/net/pin correspondence,
    the mismatch-category breakdown, the `klt drc` violation count.
    Those figures move, repeatedly. This document has already carried 98, then
    128, then 124, then 98 again as `layout/sar-adc-top/` was re-run against
    succe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
2026-09-17 docs(chipalooza): gate the I/O list against the top-level netlist (issue #121) (#319)
    Checks 3 to 9 of the proposal's citation gate all grade Section 4. Section 2
    carries the document's other mechanically checkable claim, and issue #121's
    acceptance criterion 1 states it directly -- "I/O mapped to the slot budget"
    -- but every part of it was a hand restatement of
    `design/sar_adc_top.spice`'s own `.subckt sar_adc_top` port list, verified
    only by re-reading. That netlist is regenerated from `design/sar_adc_top.sch`,
    a file this repo really does change (DR-004 Amendment A moved the
    comparator's device count; DR-008/DR-009 changed sub-block interfaces), so a
    port added, renamed, or dropped would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
2026-09-17 docs(chipalooza): gate what a §4 row fails to cite, re-grade the Power row (issue #121) (#320)
    The Power row of the proposal's §4 spec table read "BLOCKED / UNMEASURED —
    no full-block power campaign exists" and cited only the digital sequencer's
    OpenROAD PnR estimate. That had been stale since 2026-09-12:
    sim/full-conversion-transient/'s current record carries a 9-corner
    whole-ADC average-power table, sim/spec-coverage.json indexes that campaign
    under the Power row, and docs/characterization-report.md — the regenerable
    source §4 says it mirrors — writes the figures out in full.
    Every existing check passed on that row, because the defect was an
    *absence*: checks 3-9 each grade a row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
2026-09-17 docs(chipalooza): gate the five sub-block layout verdicts, not just the top level's (issue #121) (#324)
    Check 9 of the citation gate recomputes a stated DRC/LVS readout from the
    record that flow's `reports/LATEST` resolves to. The proposal stated exactly
    one such readout -- the composed `layout/sar-adc-top/` -- so the five
    sub-block flows that composition is built from were ungated: their verdicts
    lived in Section 3 as the words "DRC-clean and LVS-clean", and the one
    Section 4 row that grades on them (Digital sequencer/output register --
    physical implementation) cited `layout/sar-sequencer/README.md`, a
    hand-written file rather than a dated record, so check 3 had nothing to hold
    it to either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
2026-09-17 layout: re-run cdac-array, sar-sequencer, seln-inverters under klt 0.5.0 (#327)
    Three of the five sub-block layout sign-off records still rested on
    klt 0.4.0 while layout/requirements.txt (and the other two sub-blocks
    plus the top-level composition) pin klt 0.5.0 -- a version-parity gap,
    not a known defect. Re-ran each flow's own bin/run-flow.sh under the
    pinned klt 0.5.0, minting a new append-only dated record per flow and
    advancing reports/LATEST.
    Outcome for all three: DRC stays clean, LVS verdict/device/net/pin
    counts and mismatch categories are field-identical to the superseded
    klt 0.4.0 record -- no regression, so no klayout-tools issue was filed.
    sar-sequencer's 30/28/30 pin-count as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
    [sar_sequencer.v, sar_sequencer_post_route.v, seln_inverters.v, seln_inverters_post_route.v]
2026-09-18 docs(sar-sequencer): explain the 30/28/30 LVS pin-count asymmetry (issue #322) (#325)
    The two extra pin entries come from `klt extract`'s own net-label-merging
    pin-flagging, not the DEF PINS section or --def-pins being overridden --
    verified against this record's extract.json, sar_sequencer.def, and the
    reference .SUBCKT line. Documented as the correct sign-off figure in
    layout/sar-sequencer/README.md and re-pasted docs/chipalooza's §3/§4
    readout to cite the same root cause instead of leaving it as an open
    question. Filed generically at 2AMLogic/klayout-tools#2000.
2026-09-18 docs(chipalooza): gate the Area row's bounding box, the last hand-carried figure (issue #121)
    Checks 9 and 12 already recompute the sign-off-bar DRC/LVS numbers and the
    Power row's min/typ/max from the records those rows cite. The Area row was
    the one figure in the Section 4 table still carried by hand: it quotes
    `layout/sar-adc-top/`'s composed bounding box, and check 3 only gates *which*
    record it cites, not the numbers quoted out of it.
    That flow has been re-run five times (20260906-101939-1250ff4 ->
    20260907-110058-a546200 -> 20260908-072857-80df05e -> 20260915-213439-bf2256f
    -> 20260915-234004-76f48b9), and each re-citation records a human having
    established by `cmp` or a field-by-fiel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
2026-09-18 docs(chipalooza): gate what the composed top level is built from (issue #121) (#332)
    Checks 3-13 of the citation gate each grade a claim against the record it
    cites. None of them looks at what that record was built *from*, and nothing
    else in this repo does either: `layout/sar-adc-top/bin/run-flow.sh` resolves
    each sub-block's `reports/LATEST` at run time and copies that flow's top-cell
    GDS in, while `klt gen-compose`'s `compose.json` records no provenance for the
    geometry it composed (filed generically as klayout-tools#2065).
    So §3's five sub-block readouts (check 9, from each flow's *current* record)
    and §4's three composition-graded rows could drift apart silently. They have:
    PR #327 r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
2026-09-18 chore(ci): point ci.yml's citation-gate comment at docs/citation-gate.md (issue #330) (#335)
    The `checks` job's inventory comment carried a ~60-line per-check narrative of
    `docs/chipalooza/check_proposal_citations.py`. Since PR #329 that rationale has
    a canonical home in `docs/citation-gate.md`, one section per check, kept in step
    with the checker's own `check_document` chain by
    `sim/tests/test_proposal_citations.py`. The workflow comment was a third,
    ungated copy of the same argument -- and had already drifted: it inventoried
    checks 1-13 while the checker has grown a check 14.
    Replaced with the same shape the sibling entries for `sim/check_spec_coverage.py`
    and `layout/bin/check-klt-pin-ev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
2026-09-18 docs: update stale layout/comparator record citations (issue #331) (#334)
    * docs: update stale layout/comparator record id citations to klt 0.5.0 record (issue #331)
    Update three stale citations of 20260906-113406-2d66a6a to the current
    klt 0.5.0 record 20260915-120705-1e90b14 in layout/comparator/README.md
    (lines 19, 150, 264) and the comparator reference in
    layout/sar-adc-top/README.md:296. Add explanatory note that the post-pointer
    record 20260915-121226-1e90b14 is an earlier klt 0.4.0 run intentionally
    superseded by the klt 0.5.0 pin bump (PR #275, issue #103), not a stale pointer.
    Re-verified wire-area imbalance percentages (2.84%, 15.54%, 6.7%) unchanged
    in the current record. No modi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
2026-09-18 fix(layout): size isolated via pads to clear sky130A's metal minimum-area rules (#336)
    sky130A's own m1.6/m2.6/m3.6/m4.4a/m5.4 minimum-area rules had never looked
    at any layout in this repo: at the pinned klayout-tools==0.5.0 the curated
    sky130 deck authors 47 rules across five kinds (width, space, enclosing,
    separation, isolated) and no `area`-kind rule at all, so `klt drc` reports
    `status: "clean"` regardless of how small a metal island is. The deck gap is
    fixed upstream (klayout-tools#1989, commit 50cc29c3) but not released, and
    this repo grades against what is released.
    Measured out-of-band instead, with a new docs/chipalooza/measure_metal_min_area.py
    that reads the thresholds and layer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
    [build_layout.py]
2026-09-19 docs(layout): waive the 145 place-and-route minimum-area shapes, with an upstream filing (issue #333) (#340)
    `docs/chipalooza/measure_metal_min_area.py` re-run on the pinned toolchain
    (klt 0.5.0, klayout 0.30.12, open_pdks c6d73a35) reproduces issue #333's
    counts exactly, with no drift: sar-sequencer 112 (m1.6 96, m2.6 6, m3.6 8,
    m5.4 2), seln-inverters 33 (m1.6 18, m5.4 15), composed top 145 — the
    composition itself adding none.
    No fix is reachable from this repository. Both flows are pure
    `klt place-and-route`; their only in-repo inputs are a structural netlist and
    a P&R request. The m1.6/m3.6 shapes are the PDK's OWN tech-LEF via enclosures
    instantiated verbatim (sky130_fd_sc_hd__nom.t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
2026-09-19 ci: gate the metal minimum-area measurement in the PDK-smoke job
    docs/chipalooza/measure_metal_min_area.py (added by #326/PR #336) is the
    only thing in this repo that can see sky130A's own m1.6/m2.6/m3.6/m4.4a/m5.4
    minimum-area rules -- the pinned klayout-tools==0.5.0 deck authors no
    area-kind rule, so `klt drc` reports clean regardless -- but nothing ran it
    automatically, so the invariant #326 established had no gate holding it.
    Wires it into .github/workflows/ci.yml's PDK-gated `pdk-smoke` job, after the
    venv-setup step, with a baseline/expected-counts mechanism
    (metal_min_area_baseline.json) so the gate can tell "this repo's own
    generators regressed" (must fail) apart from "the 145 shape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
    [build_layout.py]
2026-09-19 docs(layout): correct the --abstract-cells LVS collapse diagnosis (issue #103) (#341)
    * docs(layout): correct the --abstract-cells collapse diagnosis for issue #103
    A previously-unrun ablation probe (layout/sar-adc-top/bin/probe-abstract-cells.py)
    re-measures the README's "A fourth shape measured" --abstract-cells result
    against five ablations. The 6-mismatch composite-net collapse persists even
    after supplying cdac_array's previously-missing 4th pin (23 -> 24, a full
    match) and after stripping its nwell/tap geometry -- both targeted directly
    at what klayout-tools#1911/#1934 diagnoses/fixes. Neither changes the
    collapse at all, so that upstream fix (merged but still unreleased) will not
    res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
    [probe-abstract-cells.py]
2026-09-23 layout: bump klayout-tools pin 0.5.0 -> 0.6.0 (issue #103)
2026-09-23 layout: re-measure sar-adc-top on klayout-tools 0.6.0; LVS still not clean (#103)
    Part of #103.
    klayout-tools v0.6.0 is the first release carrying 3cc085c (#2147, the
    upstream fix for #2142), which was this issue's tracked blocker. Re-ran with
    the pin bump:
    - trivial-cell proof: all six verdicts PASS (20260923-131710-fa1e0af).
    - sar-adc-top flow (20260923-131726-fa1e0af): DRC clean, connectivity
    verified, whole-request LVS field-identical to 0.5.0 (98 mismatches).
    - --abstract-cells collapse unchanged on 0.6.0. The new cdac-no-capm-via
    ablation in probe-abstract-cells.py locates the real mechanism:
    abstraction erases the MiM top plate but keeps its via, so every cap in
    the black bo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
    [probe-abstract-cells.py]
2026-09-23 layout: re-measure sar-adc-top on klayout-tools 0.6.0 -- LVS still not clean, real --abstract-cells mechanism located (#103) (#352)
    * layout: bump klayout-tools pin 0.5.0 -> 0.6.0 (issue #103)
    * layout: re-measure sar-adc-top on klayout-tools 0.6.0; LVS still not clean (#103)
    verified, whole-request LVS field-identical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
    [probe-abstract-cells.py]
2026-09-23 feat(layout): commit klt erc supply spec and report for T1 item 11 (issue #344) (#356)
    Add the structural power-delivery evidence T1 item 11 requires: a klt erc
    supply spec for sky130's stackup, a committed erc.json/record.md report
    graded against reports/20260919-050355-fb11617/sar_adc_top.gds, and the
    docs/t1-gap.md row documenting the eleventh checklist item.
    The report finds VDD/GND each resolve to one clean island (item 11 met for
    the analog rails) while VPWR/VGND each split into two disconnected islands
    (digital macros' self-contained rails, not reaching a top-level supply) --
    tracked separately as issue #355 rather than tuned away. erc.missing_tie is
    documented as not-computed (no ti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
2026-09-24 feat(sim): add comparator kickback probe testbench (issue #346) (#358)
    Adds a `kickback` mode to sim/comparator-decision/run.py that drives a
    1 kOhm series source impedance into VINP/VINN (the stimulus shape named
    by the sky130-comparator canary's cross-pollinated prior-art Finding,
    issue #346) and measures the embedded comparator's own peak pin
    disturbance across the CLK reset->evaluate transition, on this repo's
    own design/comparator.sch (DR-004 Amendment A, 11-device topology).
    The measurement is informational only -- spec/target-spec.md has no
    Kickback row (DRAFT or ratified), and none is added here. Only the
    probe methodology (series-impedance stimulus + peak-disturbance
    measurement) i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
2026-09-24 ci(layout): gate DRC-clean verdicts on curated-deck provenance (issue #121) (#339)
    Every "DRC-clean" claim this repo makes -- layout/<flow>/README.md's
    verdict tables and every Section 4/7 verdict
    docs/chipalooza/challenge-4-proposal.md grades on them -- bottoms out
    in a committed drc*.json payload whose status reads "clean". Nothing
    checked which klt drc path produced that payload, and klayout-tools#1941
    (fixed by #1951, merged 2026-09-16 but not in any published release --
    klt 0.5.0 remains latest) showed the `--engine klayout --deck-file` path
    can report a false "clean" from a deck that aborted part-way through.
    Add layout/bin/check_drc_evidence.py: a pure-file-read, PDK-free gate
    (same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
2026-09-24 docs(chipalooza): record #103's v0.6.0 re-measurement and operator escalation (issue #121) (#360)
    Section 7 Item 1's own trail stopped at 2026-09-16 (a bare klayout-tools
    release gate), and its "still `reports/LATEST`" citation had since gone
    stale across three superseding re-runs. Add an "Update (2026-09-24)"
    paragraph covering what actually happened since:
    - klayout-tools v0.6.0 published (PyPI, contains commit 3cc085c /
    klayout-tools#2142) -- the release gate this item was waiting on has
    cleared.
    - #103's PR #352 re-ran the whole sar-adc-top flow pinned to 0.6.0: DRC
    stays clean, whole-request LVS is field-identical to the 0.5.0 result
    (98 mismatches, same device/net/pin counts a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
2026-09-24 docs(chipalooza): carry the newly-graded power-delivery (ERC) gap (issue #121) (#359)
    Section 7 of the Challenge #4 proposal listed eight open items and never
    mentioned ERC at all, even though T1's eleventh checklist item (Power
    delivery, structural) was answered in-repo on 2026-09-23 by PR #356 with a
    committed, hash-pinned `klt erc` supply run -- and that run FAILS on two of
    the four declared supplies.
    Adds §7 item 9 reporting the per-supply verdict from
    layout/sar-adc-top/erc-reports/20260923-143401-1ee4ba8/: VDD and GND each
    resolve to one electrical island with no supply_short, while VPWR and VGND
    each resolve to two disconnected islands (the two standard-cell macros'
    self-contained r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
2026-09-24 feat(layout): tie VPWR/VGND into one island each, out to top-level pins (#355) (#365)
    `klt erc`'s first structural supply run on the composed top level (issue
    #344, T1 item 11) graded VPWR and VGND as two disconnected electrical
    islands apiece -- each standard-cell macro's own self-contained rail,
    reaching no top-level supply at all.
    DESIGN DECISION (spec/decision-records/DR-010): the digital VPWR/VGND
    domain stays INDEPENDENT of the analog VDD/GND domain and gets its own
    top-level pins, rather than being tied to VDD/GND in metal. One voltage
    (1.8 V, DR-001), two domains; the star point is off-die. The reasoning is
    stated as design-time reasoning from this design's own topology -- the
    seque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
    [sar_adc_top.sch]
2026-09-24 docs(spec): add a DRAFT Kickback row, proposed by DR-011 (#366)
    spec/target-spec.md has never carried a Kickback row in any status, so
    issue #346's measured baseline (73.3673 mV worst-case peak pin disturbance,
    tt/27 C, 1 kOhm series source) landed purely informational with nothing to
    be graded against -- which in turn left #349's cross-repo mitigation
    finding permanently blocked.
    DR-011 proposes that row. Its bound (<= 5 mV target / <= 2 mV stretch, into
    a 1 kOhm series source impedance at a single decision edge) is adopted
    verbatim from the sibling 2AMLogic/sky130-comparator canary's own
    DR-002-ratified row, as an explicit stated interim choice rather than a
    bound derived from this block'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
2026-09-24 docs(chipalooza): gate the ERC supply readout, the second evidence tree (issue #121) (#367)
    The Challenge #4 proposal's ERC claims — §3's `klt erc` bullet and §7 item
    9's per-supply island table — were hand-transcribed prose that no check
    could see. A `layout/` flow keeps its supply verdicts in a separate
    `erc-reports/<stamp>/` tree with its own LATEST pointer, and the citation
    gate's `EVIDENCE_PATH_RE` matches `records|reports` only, so every ERC
    citation was invisible to checks 3 and 4 however it was written.
    That drift is on this item's own record: it was written 2026-09-23 against a
    failing run (`VPWR`/`VGND` at two islands each) and re-transcribed by hand on
    2026-09-24 when issue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
2026-09-24 docs(chipalooza): grade the DRC half on the pinned deck's own area rules (issue #121) (#369)
    The "DRC/LVS-clean GDS, full ADC" row still scoped its DRC component to
    "the deck's 47 rules" plus an out-of-band minimum-area count, "until a
    klayout-tools release carries #1989's met*.area.1 rules". That release
    is pinned (0.6.0, PR #352): the cited record's own drc.json checks 52
    rules, including met1..met5 .area.1 and .holes_area.1, clean at 0
    violations. Record that, and stop leaning on the out-of-band 145-shape
    residual, which issue #363 found the measuring script overstates.
    Also correct three present-tense "98 mismatches" statements that were
    left behind when their surrounding citations were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
2026-09-24 docs(chipalooza): record klayout-tools#2396/#2398's closure-but-no-release (#370)
    * docs(chipalooza): record klayout-tools#2396/#2398's closure-but-no-release (issue #121)
    §7 Item 1 and §4's DRC/LVS-clean GDS row named klayout-tools#2396 (MiM
    top-plate short inside an --abstract-cells black box) and #2398 (well-tap
    erasure cutting off cdac_array.VDD) as open blockers on the --abstract-cells
    LVS shape. Both have since closed upstream, live-re-verified this pass
    (gh issue view 2396 2398 --repo 2AMLogic/klayout-tools): #2396 via
    klayout-tools#2433 (commit a34fd79, merged 2026-09-24T06:04:21Z) and #2398
    via klayout-tools#2434 (commit c01c50c, merged 2026-09-24T08:09:47Z).
    Neither fix is in a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
2026-09-24 fix(chipalooza): stop the metal min-area script under-merging its region (#372)
    `measure_metal_min_area.py` built its region as `kdb.Region();
    region.insert(top.begin_shapes_rec(li)); region.merge()`.
    `Region#insert(RecursiveShapeIterator)` carries each shape's GDS user
    properties into the region, and KLayout's merge is property-aware: two
    overlapping polygons whose property sets differ are never merged, and
    `Region#area` counts the overlap twice. This repo's routed GDS attaches a
    net-name property (`[[1, "VPWR"]]`, `[[1, "VGND"]]`) to every PDN strap and
    none to the via cells sitting inside it, so covered via pads stayed separate
    polygons and were reported as standalone minimum-area violati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
2026-09-24 feat(layout): draw a top-level analog GND pad, per DR-012 (#376)
    * feat(layout): draw a top-level analog GND pad and record DR-012
    `VDD` has been a top-level port of `sar_adc_top` since the block was
    written; its return never was. The block declared `.GLOBAL GND` and drew
    ground inside `comparator`, but exposed no terminal a package could bond
    it to -- the same structural gap #355 closed for the digital
    `VPWR`/`VGND` rails, one domain over, and the one DR-010's "Open items"
    named rather than absorbing.
    `klt erc` cannot catch this shape: T1 item 11 grades "does this declared
    supply resolve to exactly one electrical island", which `GND` always did,
    pin or no pin. Filed generically upstream a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
    [sar_adc_top.sch]
2026-09-24 docs(chipalooza): gate how much of Section 4 the freshness check reaches (issue #121) (#381)
    Check 3 -- the load-bearing one -- resolves "the current record" of a cited
    flow from that flow's own `LATEST` pointer, and skips a flow that publishes
    none: there is nothing to be stale against. That is correct behaviour, and
    it was stated only in `docs/citation-gate.md`. The proposal's own summary of
    the gate said the opposite, without qualification: "every row of the table
    above cites the *current* record of each `sim/`/`layout/` flow it draws on".
    It does not. Of the 21 (spec row, evidence flow) citation pairs in Section 4
    today, 7 -- spanning six rows (Resolution `N`, `V_REF`, Comparator
    input-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
2026-09-24 docs(layout): record the corrected klayout-tools#2139 reproducer re-run (issue #373) (#382)
    The upstream filing 2AMLogic/klayout-tools#2139 rested on a 99-shape
    sub-minimum-area count measured with the property-aware region merge that
    issue #363 / PR #372 identified and fixed in
    docs/chipalooza/measure_metal_min_area.py. Both flow READMEs already marked
    the filing superseded, but neither recorded what the corrected measurement
    actually says, nor that the upstream issue had since been closed.
    Re-ran #2139's own reproducer (its quoted buf_chain.v generator + pnr.json,
    in a scratch directory) through `klt place-and-route` at klt 0.5.0 -- the
    version the filing used, and the last one without th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
2026-09-25 docs(chipalooza): make the bench plan executable on the 22-port part (issue #121) (#384)
    Section 5 (the bench test plan) is the third deliverable issue #121's
    acceptance criterion 1 names, beside the I/O mapping and the spec table,
    and the only one nothing in the citation gate graded. Its own lede claims
    it is "written against this design's *current* port list (§2)". It was not.
    Three supply ports joined the block's interface on 2026-09-24 -- `VPWR`
    and `VGND` by DR-010 (issue #355), `GND` by DR-012 (issue #362), taking it
    from 19 ports to 22 -- and Section 5 still described the 19-port part:
    - Step 1 (bring-up) applied `VDD`, `VREFP`/`VREFN` and `VCM` only. Followed
    verbatim it leaves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
2026-09-25 docs(chipalooza): gate the directory list check 2's coverage rests on (issue #121) (#386)
    `docs/citation-gate.md`'s check 2 entry names, in prose, the set of top-level
    directories whose backticked paths the citation gate resolves -- that is,
    `check_proposal_citations.py`'s own `OWN_TOP_LEVEL` frozenset. The two had
    drifted: check 17 (PR #375) added `signoff` to the frozenset and left the
    sentence naming seven directories.
    That is not a stale word. A directory absent from `OWN_TOP_LEVEL` is a whole
    evidence tree whose bare backticked citations check 2 silently does not
    resolve -- exactly the hole `signoff/...` paths sat in before check 17, and
    the one `erc-reports/` sat in at checks 3/4 befo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
2026-09-25 docs(chipalooza): gate the device inventory, and find the glue the layout lost (#389)
    Check 10 grades the top cell's ports. Nothing graded what is *inside* it --
    and that gap had already cost this document two weeks of wrong prose.
    DR-008 (issue #263, PR #266, 2026-09-11) replaced the nine
    `SELn<i> = NOT(DOUT<i>)` inverters issue #56 drew at the integration level
    with eighteen decision-directed `and2_1` gates, added a nine-gate `xor2_1`
    readout recode, and DR-009 added an eight-device half-LSB quantizer-offset
    network. None of it moved a port, so check 10 had nothing to say, and
    Sections 3 and 7 went on describing the top level's glue as "the nine
    `SELn<i> = NOT(DOUT<i>)` glue inverters" ev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
2026-09-25 fix(chipalooza): scope check 17's failed-row list to tier T1 (issue #379) (#391)
    t1_readout() drew its graded-and-failed list from every report row with
    reason check_failed, while the met/total beside it are T1-only counts. A
    higher-tier row the grader ever fails for a real reason would have been
    enrolled as a T1 failure. Scope the comprehension with a named T1_TIER
    constant, let the fixture writer honour a per-item tier, and add a test
    that a failing T2 row stays out of the list (mutation-checked: removing
    the scope fails exactly that test).
    Also document, in citation-gate.md's check 17 section, the list's T1
    scope and that the cited-record clause is graded in both directions.
    No current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
2026-09-25 docs(spec): DR-014, static preamp not adopted for kickback; DR-004 §1 stands (issue #349) (#392)
    Weighs the measured comparator kickback gap (73.3673 mV vs DR-011's DRAFT
    <=5/<=2 mV) against DR-004 Decision §1's headroom rationale, and against
    cheaper mitigation classes.
    - The gap is ~95.9 % common-mode by construction: the Vindiff=0 control
    is symmetric.
    - DR-003's saturated-tail stack is over-conservative for the dynamic
    latch, which works at 1.62 V where the stack reads -66.9 mV. It is
    accurate for a static preamp. A PMOS-input flip reads -329.9 mV.
    - The sibling preamp's ~95 uW static bias against this core's measured
    27.971 uW would be about 4.4x the block's power.
    - Clock-ed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
2026-09-25 docs(chipalooza): gate the Kickback row's derived arithmetic, correct a mischaracterization (issue #121) (#393)
    The Kickback row subtracted the cited record's Vindiff=0 control peak from
    its worst-case peak and called the 3.0254 mV residual "the decision
    transient itself." Both figures are per-pin extrema (run_kickback_sweep
    tracks one max/min across VINP and VINN together), so the difference bounds
    neither the common-mode nor the differential part of the disturbance --
    DR-011's own Context/Consequences §3 read the same subtraction the same
    way, which is why this went unquestioned until now. Issue #390 is the
    follow-up that mints a record carrying the real split.
    - docs/chipalooza/challeng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
2026-09-25 docs(chipalooza): gate the currency claim a stamped citation carries (issue #121) (#396)
    The proposal's §3 `klt erc` bullet and §7 item 9 both introduced #355's
    supply fix with "the current run" and a citation of
    `erc-reports/20260924-214731-b323061` — the run that graded the GDS before
    the current one. `erc-reports/` is append-only like every other evidence
    tree here, so #362 and then #377 each minted a successor record, and
    **neither moved a single number in the island table either passage
    carries**: all four supplies stayed at one island, `erc_status` stayed
    `clean`, findings stayed 0. Both citations therefore went stale behind a
    page of correct-looking figures, and item 9's hand-writ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
2026-09-25 evidence(layout): refresh erc-supply-spec.json's stale prose and re-mint the ERC record (#380)
    * docs(layout): refresh erc-supply-spec.json's stale prose to the run of record
    The graded content -- stackup, vias, nets[].name/kind and
    ties_disclosure.kind -- is byte-identical; only _comment prose and
    ties_disclosure.reason move.
    * evidence(layout): re-mint the ERC record and replace the frozen-spec argument
    Mints erc-reports/20260924-230820-3e79547/ against the same GDS the
    superseded record graded, so the refreshed supply spec is pinned by a
    run rather than asserted: erc_status clean, 0 findings, all four
    supplies at one island each.
    run-erc.sh now prints a graded-spec subset digest -- a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
2026-09-25 docs(chipalooza): gate the ground plan's unmeasured half, record #387's split (issue #121) (#404)
    Two increments, both from a live re-verification rather than from the
    document's own prose.
    1. Section 7 Item 9 reported a `klt erc`-clean power-delivery structure and
    four qualifications of it. A fifth was owed and missing: the ground plan
    those verdicts grade -- DR-012's drawn analog ground pad, DR-013's mesh
    into it -- rests on an impedance argument neither record presents as
    evidence. DR-012 says so in its own words ("no simulation in this repo
    measures ground-return impedance, substrate coupling, or bond-wire
    inductance") and carries it as a standing open item, tracked as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
2026-09-25 docs(chipalooza): gate §8's provenance claim, and count the layout third it overstated (issue #121) (#408)
    Section 8 asserted, in prose, that "every simulation record cites its exact
    pinned toolchain versions (`sim/toolchain.json`), and every layout record
    cites the `klt` version and PDK commit it ran against". The second half was
    false when it was written: 33 of the 67 records under `layout/*/reports/` and
    `layout/*/erc-reports/` name no `open_pdks` commit at all, including every
    record of `layout/sar-adc-top/` — the flow whose DRC/LVS verdicts Section 4's
    sign-off-bar rows rest on — and `layout/cdac-array/reports/LATEST`.
    Two measured causes, neither clerical: four of the eight `layo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
2026-09-25 evidence(sim): supply-return impedance sensitivity campaign, retires DR-012's open item (issue #378) (#410)
    * test(sim): pin the supply-return campaign's deck assembly and DR-015's arithmetic
    First half of issue #378 (DR-012's own open item: "the impedance argument is
    unmeasured"). Adds the campaign, its decision record, and the tests that keep
    both honest; the evidence record follows in its own commit once the transients
    finish.
    `sim/supply-impedance-sensitivity/` runs `sim/full-conversion-transient/`'s
    committed stimulus fragment verbatim against the same committed
    `design/sar_adc_top.spice`, changing only the network between the board's star
    point and the die's four supply terminals (`V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
2026-09-25 test(layout): import-smoke gate for layout/*/bin entry points (issue #399) (#413)
    `DOMAIN_TAP_NET` has been deleted from
    layout/sampling-frontend{,-wells}/bin/gen_blocks.py as an "unused import"
    three times (#251, #383/PR #388, #394/PR #398). PR #388 landed that
    deletion on main -- four scripts broken at import time -- and every gate
    stayed green, because nothing on the PR-blocking path ever *executes*
    those modules: `test:compile`'s `py_compile` byte-compiles without
    importing, `test:unit` discovered only sim/tests, and the flows that do
    run them (run-flow.sh) are PDK-gated. PR #398 restored the name with a
    comment and an F401 noqa, which helps a reader but cannot turn CI red.
    Add sim/test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
2026-09-25 sim: mint records/LATEST for the 2 genuinely single-current-record campaigns (issue #405) (#415)
    Adds the standard two-line records/LATEST write (matching every other
    sim/ campaign's runner convention) to sim/enob-estimate/run_enob.py and
    sim/sar-sequencer-behavioral/run_testbench.py, the only two of the four
    pointerless campaigns issue #405 named that are actually single-current-
    record when checked against how Section 4 of the chipalooza proposal
    cites them.
    sim/cdac-array-transfer turned out NOT to be single-mode/unambiguous
    despite the issue's own framing: its four records are three distinct,
    non-superseding claims (ratified V_REF/LSB, and two INL/DNL Monte Carlo
    scorings) cited from tw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
2026-09-25 fix(chipalooza): skip .control block bodies in the ground-return deck scan (issue #406) (#418)
    _deck_device_cards() dropped only comments, continuations and
    dot-commands, so a .control ... .endc body's `let` line -- which has an
    inductor card's L<word> <field> <field> <field> shape -- was scanned as
    a device card. Track .control/.endc state and skip everything between
    them; extend the FixtureTree.add_sim_deck decoy set and add a direct
    _deck_device_cards test reproducing the issue's repro.
    Closes #406
2026-09-25 docs(chipalooza): repoint the census's stale ENOB record after #405's re-point (issue #121) (#419)
    PR #415 (issue #405) minted sim/enob-estimate's first records/LATEST
    pointer and re-pointed Section 4's ENOB row citation from
    20260906-173830-6f04f59 onto the new reproduction,
    20260925-090023-c3a6872. It did not update the corner-grid census
    blockquote that PR #414 had added earlier the same day, which still
    named the superseded record as one of the two "no PVT point set"
    citations -- a genuine regression the citation gate's check 28 (added
    by #414) now catches: `check_proposal_citations.py` currently FAILS on
    main, reporting the census both names a record the table no longer
    cites and omits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
2026-09-25 fix(layout): pin the resolved open_pdks commit in every record renderer (issue #407) (#420)
    layout/sar-adc-top/, layout/cdac-array/, layout/sar-sequencer/ and
    layout/seln-inverters/ record renderers (the last two via the shared
    render_pnr_drc_lvs_record) printed only the PDK *variant name* (e.g.
    sky130A), not which open_pdks install answered that ask -- unlike
    layout/comparator/ and layout/sampling-frontend{,-wells}/, which already
    resolve it via `klt pdk find --format json`. Added resolve_pdk_commit()
    to layout/bin/_record_common.py so every flow sharing that module inherits
    the same pin, and applied the same fix to the ERC record flow
    (run-erc.sh), whose `klt erc --pdk sky130` flag selects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
    [render-record.py]
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2026-09-25 feat(layout): lay out the current top-level glue bank and gate it against the schematic
    `layout/sar-adc-top/`'s composed GDS implements issue #56's top-level glue,
    which DR-008 superseded on 2026-09-11 — and no check could see it, because
    the flow's LVS reference is generated from the same netlist the layout is
    built from, so the compare agrees with itself whatever the schematic says.
    Adds `layout/top-glue/`: the 33 `sky130_fd_sc_hd` instances
    `design/sar_adc_top.spice` adds at the integration level (and2_1 x18,
    xor2_1 x9, inv_1 x3, mux2_1 x1, xnor2_1 x1, and2b_1 x1 — DR-008's
    decision-directed SELp/SELn drive and readout recode, DR-009's matched
    comparator load and half-LSB enable), pl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
    [generate-lvs-reference.py, render-record.py, seln_inverters.v, top_glue.v, top_glue_post_route.v]
2026-09-25 docs(chipalooza): drop the now-stale (not in this tree) markers for layout/top-glue
    The rebase onto origin/main brought in a #400-closure paragraph that
    asserted layout/top-glue/ (and check-schematic-parity.py) absent, verified
    against origin/main. This PR's own diff adds that very path, so check 29 of
    the citation gate now fails: the marker means "asserted absent", and the
    path exists in this branch's tree. Reworded both passages to state the path
    is present in this PR's diff but not yet in origin/main until it merges,
    keeping layout/halflsb-offset/'s marker (genuinely still absent, no open PR
    touches it) and the census sentence's rebase-freshness fix from the prior
    commit intact.
2026-09-25 docs(chipalooza): grade the renderer half of §8's provenance census (issue #121) (#423)
    Issue #407 closed at 2026-09-25T10:45Z (PR #420), which left §8's
    explanation of check 26's record census false while every number beside
    it stayed true: the paragraph still read "four of the eight layout/
    flows' record renderers resolve the commit ... and four print only the
    variant name". PR #420 fixed the other four and the ERC driver, so all
    nine record-minting entry points under layout/ now resolve the
    open_pdks commit.
    Check 26 alone cannot express that. Its census counts *records*, and
    layout/ records are append-only (CLAUDE.md), so "34 of the 67 name the
    open_pdks commit" reads identically whet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
2026-09-25 ci: arm the merge-time base-freshness guard with one required check (issue #422) (#425)
    `main` went red on 2026-09-25 (#417) because PR #414 and PR #415 were each
    green on their own stale base and semantically conflicted on merge: #415
    re-pointed Section 4's ENOB row onto a new record, #414 added a census
    enumerating those records by path. Neither branch was evaluated against the
    tree it merged onto, so citation-gate check 28 could only catch it on `main`.
    The remedy is already written. `.loom/scripts/merge-pr.sh` ships
    `_check_required_check_freshness()` (upstream Loom #8248), which refuses a
    merge when a green REQUIRED check's run predates the base tip. It resolves
    "REQUIRED" from the for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
2026-09-25 feat(sim): compute the no-gnd-pad vs package ground-pad ablation (issue #409) (#429)
    * feat(sim): compute the no-gnd-pad vs package ground-pad ablation (issue #409)
    DR-012 chose a drawn analog GND pad over bonding analog ground through the
    substrate only, and issue #409 item 2 notes that its *rejected* null option
    has never been priced against the option it chose. The `no-gnd-pad` arm
    existed but nothing in the runner turned it into a price.
    `no-gnd-pad` and `package` differ in exactly one element -- whether `GND` has
    a bond of its own; same three bonded terminals at the same R+L, same lumped
    substrate link, same stimulus -- so their difference IS the drawn pad's own
    contribution. `gnd_pad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
2026-09-25 docs(chipalooza): grade the arm axis behind §7's DR-012 retirement (issue #121) (#430)
    Section 7 Item 11 retires DR-012's "the impedance argument is unmeasured"
    open item by citation, and the sentence that bounds the retirement is a claim
    about an axis nothing in the citation gate could see: the supply-impedance
    campaign's *arms*, the supply-return networks its runner drives one DUT
    through. "DR-012's rejected `no-gnd-pad` null option is implemented but not
    run" is what makes "no priced-rejected-option claim may be read from this
    record" true -- and the day issue #409's item 2 mints the several-hour record
    that prices it, the document would still say the claim cannot be read, with
    every num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
2026-09-25 feat(sim): bounded 2-D R/L sweep for the supply-return campaign, and a cost probe that prices it (issue #409) (#432)
    * feat(sim): bounded 2-D R/L sweep mode for the supply-return campaign (issue #409)
    DR-015 fixes one assumption point for the package-style R+L and the lumped
    substrate stand-ins, and says in its own Alternatives considered that
    sweeping instead of fixing "is the better experiment" -- deferred on cost,
    and tracked as the third item of issue #409.
    This adds `--sweep`: the as-built `package` topology re-run over a bounded
    grid of per-terminal bond inductance (multiples of DR-015's value) x the
    lumped substrate link R_SUBX, at the baseline corner, plus the `ideal`
    control. A ro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
2026-09-25 fix(chipalooza): stop RENDERER_PIN_RE from counting a comment as a pin (issue #424) (#433)
    Check 30's pin predicate matched a bare `pdk find` phrase and the
    `resolve_pdk_commit` identifier anywhere in an entry point's source,
    including inside a `#` comment describing (not calling) the pin --
    run-erc.sh's own explanatory comment (issue #407) names both spellings
    in prose, so stripping its real pin call still left the entry point
    counted as pinned. Drop the unanchored `\bpdk find\b` alternative
    (unused by every real entry point) and strip whole-line comments
    before matching either remaining alternative, so only real code can
    satisfy the predicate. Adds regression coverage to TestRendererCensus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
2026-09-25 docs(chipalooza): re-verify PR #402's live label state, §7 Item 1 (issue #121) (#436)
    Part of #121: correct a stale forge-state claim rather than add new content.
    The #401/#402 sub-narrative under §7 Item 1 (added by the prior 2026-09-25
    increment) recorded PR #402 as cleared back to `loom:review-requested` at
    2026-09-25T09:30:02Z -- exactly the kind of live label sentence the paragraph
    itself warns rots on write. Re-checked live against the forge
    (`gh api repos/2AMLogic/sky130-sar-adc/issues/402/events`): since that
    timestamp, PR #402 went through a second merge-conflict rejection and Doctor
    fix cycle, reached Judge approval (`loom:pr`, 11:49:56Z), then a Champion
    critical-file hold (`lo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
2026-09-25 docs(chipalooza): give DR-014's headroom-neutral follow-on a tracker (issue #121) (#437)
    DR-014 Consequences §4 said the "no mitigation adopted" disposition would
    weaken once #390 confirmed a differential kickback component above the
    bound, and named the headroom-neutral mitigation classes (double-tail
    latch, cross-coupled neutralization, complementary-clock compensation) as
    the next thing to measure. #390 closed with exactly that confirmation
    (-10.9153 mV at Vindiff=+50 mV, ~2.2x the target), but nothing tracked the
    follow-on -- the Chipalooza proposal's Kickback row and
    sim/spec-coverage.json's tracking field both stated the open work in
    prose with no issue to point at, breaking this docu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
2026-09-25 docs(chipalooza): grade the sweep-box axis §7's DR-012 retirement leans on (issue #121) (#435)
    `npm run check:proposal-citations` was green on a pristine `main`, so this
    pass's drift had to be looked for rather than reported -- and it was in the
    one clause of the DR-012 retirement that stated an *absence*.
    **What went stale, and how fast.** §7 Item 11's residue paragraph said, until
    this pass, that "no `R`/`L` x substrate-resistance sweep exists". That stopped
    being true at 2026-09-25T15:29Z, roughly 100 minutes after the pass that wrote
    the paragraph beside it: PR #432 (issue #409, its third item) landed `--sweep`,
    a bounded 2-D box (3 bond-inductance multipliers x 3 substrate-link `R_SU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
2026-09-25 feat(sim): run the bounded 2-D R/L sweep and mint its record (issue #409) (#438)
    * feat(sim): run the bounded 2-D R/L sweep and mint its record (issue #409)
    Issue #409 item 3, and DR-015's own "Open items": the campaign's five arms
    are five networks at ONE point of DR-015's assumed magnitudes, which can show
    whether the mechanism matters at that magnitude but not where its threshold
    is. PR #432 landed `--sweep` (the box, its anchors, its record writer) and
    `--cost-probe` (what it would cost), and left the measurement owed. This
    commit pays it.
    Ten whole-ADC transients at `tt_27c_1.80v`, sequential, 3049 s of wall clock:
    the as-built `package` topology at bond inductance 0x/1x/10x of DR-015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
2026-09-25 feat(spec): measure cross-coupled neutralization and close DR-014's headroom-neutral gate (issue #434) (#441)
    DR-014 Consequences §4 conditioned the headroom-neutral mitigation-class
    measurement on #390 confirming a differential kickback component above
    DR-011's DRAFT bound; #390 closed with 10.9153 mV at Vindiff=+50 mV,
    satisfying that condition. This measures the first of the three named
    classes: cross-coupled neutralization, added to the adopted 11-device
    StrongARM-class latch as an EXPERIMENTAL, non-adopted DUT variant
    (testbench/comparator_core_neutralized.spice), sized from the input
    pair's own BSIM4 Cgd overlap term rather than fitted or reverse-engineered.
    Result: the worst-case pe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
2026-09-25 feat(sim): run the no-gnd-pad arm and price DR-012's rejected option (issue #409) (#442)
    Issue #409 item 2, and DR-015's "the one arm that would price DR-012's
    *rejected* option has not been run": the `no-gnd-pad` arm has been implemented
    and reachable since #378 but absent from every committed record, deferred on a
    cost projection (~17x the control arm per simulated ns, "several hours"). This
    commit pays the run and finds the projection was wrong.
    Three whole-ADC transients at `tt_27c_1.80v`, sequential, 1457 s of wall clock
    total: `ideal` (292 s), `package` (678 s) and `no-gnd-pad` (487 s). The arm the
    campaign called "the most expensive of all" is 1.67x the control and CHEAPER
    than the `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
2026-09-25 docs(chipalooza): record klayout-tools#2397's closure, the third of PR #352's findings (issue #121) (#443)
    §7 Item 1's 2026-09-24 update recorded klayout-tools#2396 and #2398 closing
    with their fixes pending release, and summarised the bookkeeping as "both
    upstream issues are now closed-with-fix-pending-release rather than open".
    That sentence enumerates two of the three findings PR #352 filed, so a reader
    tracking which is still open would infer #2397 is. It is not.
    Verified live: #2397 closed 2026-09-24T02:11:27Z (state_reason completed) via
    klayout-tools#2425 ("fix(lvs): case-fold circuit/device names in capacitor
    recovery map key", commit 2808823) -- earlier than either of the other tw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
2026-09-25 docs(chipalooza): record #440's decoupling-cap placement requirement in §7 Item 1 (issue #121) (#444)
    §7 Item 1 enumerates every tracked owner of the `layout/sar-adc-top/`
    gap acceptance criterion 3 waits on (#103, #387, #401, #400, PR #402).
    A fourth was filed 2026-09-25T18:06:01Z and the document had no copy of
    it: #440, which places two per-domain decoupling capacitors in the
    composed top level and re-runs `klt drc`/`klt lvs`/`klt erc` against the
    result.
    Recorded in the one section whose job is narrating tracking state, with
    what does and does not move stated from checkable facts rather than from
    either issue's text: `git grep -i cdecap origin/main -- design/ spec/`
    returns nothing, `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
2026-09-26 feat(sim): sweep the substrate return on DR-012's rejected topology (issue #409) (#445)
    DR-015 says of the `no-gnd-pad` arm -- DR-012's rejected null option -- that
    it is "*entirely* a function of `R_SUB`: with a small `R_SUB` it looks
    harmless, with a large one it looks fatal". That was an argument from one
    measured point. The 2-D `--sweep` box did not reach it: it moves a substrate
    resistance on the as-built `package` topology, where `GND` has a bond of its
    own and that resistor is a shunt beside it, and its own scope section said a
    sweep of the substrate *return* was still owed.
    `--null-sweep` is that ladder: the `no-gnd-pad` topology at 3/30/300 Ohm of
    lumped substrate return, all three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
2026-09-26 docs(chipalooza): give the on-die-decoupling gap its tracker, and gate it (issue #121) (#446)
    §7 Item 11's supply-return narrative publishes eight die-side ground-excursion
    figures (0.059 ... 111.622 mV), and every one of them is qualified
    **undecoupled**. That qualifier is not this document's gloss: DR-012's own
    Consequences attach it to its 65.237 mV figure and defer for it to "the last
    open item", and DR-010 and DR-015 carry the same item forward in the same
    words. §7's standing rule is that an open item points at the issue that already
    tracks the work -- and for this one there was no issue to point at, so the
    qualifier has travelled with every number while naming nobody.
    There is one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
2026-09-26 docs(chipalooza): grade the null-option ladder axis, correct #409's item status (issue #121) (#447)
    PR #445 (the residual of issue #409's third item) minted a fourth record for
    `sim/supply-impedance-sensitivity/` -- a `--null-sweep` ladder that moves the
    lumped substrate resistance over `3`/`30`/`300 Ohm` on DR-012's *rejected*
    `no-gnd-pad` topology, where that one resistor carries the analog ground's
    entire return current instead of shunting a bond as it does in the 2-D box
    check 32 already grades. Nothing in the proposal document mentioned it, and
    nothing in the citation gate could have noticed: a ladder record is the union
    of every existing check's blind spot -- it never becomes `records/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
2026-09-26 feat(sim): run #409's full ratified corner grid -- all five arms x nine points (issue #409 item 1) (#456)
    * feat(sim): run #409's full ratified corner grid -- all five arms x nine points
    Mints sim/supply-impedance-sensitivity/records/20260926-050045-8e62675.md
    with the indexed `--corners --record` invocation: 45 whole-ADC transients,
    every supply-return arm at every ratified OAT point, on the as-committed
    netlist that carries DR-017's on-die decoupling (a different DUT sha256
    from every earlier record of this campaign, so nothing is superseded and
    records/LATEST does not move).
    What it finds, within the one record:
    - The as-built `package` return's GND_DIE excursion is worst at the
    fast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
2026-09-26 docs(chipalooza): close #409 item 1 in §7, cite the full 9-point/5-arm grid record (issue #121) (#457)
    PR #456 minted sim/supply-impedance-sensitivity/records/20260926-050045-8e62675.md,
    running #409's ratified nine-point PVT grid across all five supply-return arms in
    one session -- and updated DR-012/DR-015 to reflect it. This document's own §7
    tracking paragraphs still called that grid "deferred" and still listed item 1 as
    staying open alongside item 4; sync them to what the record and the updated
    decision records actually say, with the exact per-arm worst-excursion figures and
    the already-filed #455 anomaly tracker cited by record rather than restated from
    memory.
    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
2026-09-26 spec(DR-017): grade the shipped decoupling value -- Amendment A refutes the 1/sqrt(C) sizing model (issue #431) (#458)
    DR-017 sized `MF = 2` without ever measuring `MF = 2` on the `package` arm,
    left that cell blank, and tracked it as #448. The measurement now exists on
    `main`: issue #409's nine-point PVT grid
    (`sim/supply-impedance-sensitivity/records/20260926-050045-8e62675.md`) ran on
    the as-shipped *decoupled* netlist -- it names DUT sha256 `6a0be472...`, which
    is `design/sar_adc_top.spice` with both `Cdecap_*` cards in -- so the shipped
    value's `package`-arm row was already committed evidence and only wanted
    reading.
    It refutes the `1/sqrt(C)` law DR-017 reasons from, in the design's f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
2026-09-26 docs(chipalooza): correct the INL/DNL row's klt-yield gap citation, file the unaddressed successor (issue #121) (#461)
    The INL/DNL row's klt-yield-gap citation (klayout-tools#1061) had not been
    re-verified live since it was written on 2026-08-25 -- unlike almost every
    other dependency this document tracks. Re-checked this pass:
    - klayout-tools#1061 is CLOSED/COMPLETED (via #1078), but that PR only fixed
    the gap's discoverability (--help text, docs callouts), not the gap
    itself; its own body already named "publish a prebuilt wheel" as the
    harder, deferred remediation.
    - A second, independent friction report on the same substantive point,
    klayout-tools#2466, was filed over a month lat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
2026-09-26 docs(chipalooza): re-verify #440/#431 tracking state in §7 Item 1 (issue #121) (#462)
    §7 Item 1's 2026-09-25 decoupling paragraph still read #440 as
    loom:blocked + loom:triage, #431 as loom:building with no open PR, and
    `git grep cdecap` as returning nothing -- all stale since PR #449 merged.
    Corrected those sentences in place to past tense, fixed the claim that
    #440's body still quotes DR-016 (only its title does now), and added a
    dated update recording the live swap: #440 curated/promoted and
    loom:building since 07:28:07Z, #431 loom:blocked on #440 since 07:24:23Z
    with only AC2 (layout) left. No §4 verdict or number moves:
    layout/sar-adc-top/reports/LATEST is still 20260924-234053-66dca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
2026-09-26 layout: place DR-017's two per-domain decoupling caps and re-verify DRC/LVS/ERC (issue #440) (#466)
    DR-017 (issue #431, PR #449) sized one `sky130_fd_pr__cap_mim_m3_1` per supply
    domain at W = L = 46.9 um, MF = 2 -> 8.870 pF each, and deliberately left
    placement to a separate pass. Neither device was in `layout/sar-adc-top/`, so
    every DRC/LVS/ERC record there described a die two devices short of the
    schematic, and DR-017's own 8798.44 um^2 / 8.14 %-of-die area budget was an
    unchecked planning assumption.
    Both capacitors are now placed and tied, and all three verdicts are re-run
    (record `reports/20260926-081248-203cca3/`, ERC record
    `erc-reports/20260926-081822-203cca3/`).
    Shape chosen: nei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
    [build_layout.py, generate-lvs-reference.py, probe-decap-sites.py, probe-ground-mesh.py, render-record.py]
2026-09-26 docs(chipalooza): correct six present-tense LVS counts left at 88, and gate the form (issue #121) (#467)
    PR #466 placed DR-017's two per-domain decoupling capacitors, minting
    `layout/sar-adc-top/reports/20260926-081248-203cca3/`: both sides of the
    compare gained the two devices (869 -> 871, 803 -> 804 matched) and the count
    moved 88 -> 89, the added entry being one further `device.unmatched`. That PR
    restated §4's machine-checked readout (check 9) and both sign-off-bar rows onto
    the new record. What it could not see is that the same count is restated in
    ordinary prose six more times -- five in §7 Item 1, one in §3's layout-record
    trail -- in forms check 9 does not match. All six still rea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
2026-09-26 sim: add the mid-scale boundary probe to the supply-impedance runner (issue #455)
    `--midscale-probe` is a diagnostic at one corner (default `fs_27c_1.80v`, the
    point record 20260926-050045-8e62675 reports a 6-LSB mid-scale move at). It
    - re-runs the committed decks of that point and of its `ideal` control and
    diffs the fresh measurements against the committed logs, parsed from the
    logs rather than transcribed from the record's tables, and
    - re-runs variants under supply-UNRELATED perturbations (a +-0.1 LSB DC
    differential input offset applied through a series source per pin, so the
    PWL schedule's breakpoints are untouched; a halved `.tran` requested step,
    which moves only the solv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
2026-09-26 sim: make the mid-scale probe's input offset free and its runs restartable (issue #455)
    Two fixes found by running the probe:
    - The +-0.1 LSB input offset was a series DC source per pin. Electrically
    identical, but it adds a capacitance-free node between two voltage sources,
    and it cost this deck more than 4x the control's wall clock -- one variant
    blew a 5400 s budget that the unperturbed deck finishes in ~900 s. It now
    shifts the LEVELS of the committed fragment's own two PWL cards instead
    (`{vdd_val*<f>}` -> `{vdd_val*<f +- offset_lsb/2^N>}`), which keeps every
    breakpoint time, the node set and the matrix exactly as the committed deck
    has them. Both invariants are asserted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
2026-09-26 sim+spec: the mid-scale code is a coin flip on a metastable MSB, not a supply-return sensitivity (issue #455)
    The ratified-grid record reported `package-r-only@fs_27c_1.80v` reading 505 on
    the `+0.00*V_REF` input against the control's 511 -- a 6-LSB move on the arm
    with 0.057 mV of die-side ground movement, while the arms with ~200x that
    excursion read 511. This is what the probe found, in five runs at that corner.
    **The control reproduces; the anomalous point does not.** Re-running
    `ideal@fs_27c_1.80v` from its own committed deck returns the committed log's
    numbers to every printed digit -- all five codes and every per-rail current to
    six significant figures. Re-running `package-r-only@fs_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
2026-09-26 fix(docs): correct the probe narrative's mechanism, run count and multiplier (issue #455)
    Judge review on #472 confirmed the simulation science, CI, spec-gate
    compliance and append-only discipline, and blocked only on committed prose
    that describes something other than what shipped. No record is edited and no
    spec row moves.
    Required fixes:
    - The README's "perturbations are supply-unrelated by construction" paragraph
    described the `±0.1 LSB` offset as a *series source per input pin* -- the
    draft `offset_vin()` explicitly abandoned for costing >4x the control's wall
    clock. It now states the shipped mechanism (shifting the LEVELS of the
    committed fragment's own two input PWL cards,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
2026-09-26 sim: add a --decap-esr ladder that drives the MEASURED decoupling-tie resistance
    `design/sar_adc_top.spice` ties DR-017's two per-domain MiM decoupling pairs to
    their rails through ideal wires; the drawn layout does not. Issue #440 measured
    those four ties at 13.837 Ohm (analog) / 13.448 Ohm (digital) per domain, ~80 %
    of it single-cut vias, and no netlist in this repo had ever carried it.
    `--decap-esr` is a bounded one-element ladder over that resistance on the
    as-built `package` topology: the `0x` rung emits no tie resistors and is the
    committed netlist card for card (asserted on the arm network AND the patched DUT
    body before the run), the `1x` rung is the layout as drawn, so the differe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
2026-09-26 layout: draw 2x2 via arrays at the four decoupling ties (issue #465)
    [build_layout.py, probe-decap-sites.py, render-record.py]
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2026-09-26 fix(#465): the ties widen EIGHT via sites, not six -- and derive the count
    Judge review of PR #473: the composer widens eight via2/via3 sites (six
    via2 + two via3 -- each met4->met2 riser passes through BOTH cut levels,
    plus the four via2 plate entries), counted independently from the
    record's own draw.request.json deltas (via2 58->76, via3 41->47 = 8 sites
    x 3 extra cuts). Six is the via2 tally. No measured number moves: ESR,
    DRC/LVS/ERC verdicts, bounding box and every hash are untouched -- this
    is the accuracy of what the records say was built.
    - `render-record.py`: the count is now DERIVED, not typed. New
    `_decap_via_array_sites()` counts the widened sites out of
    `probe-decap-sites.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
    [build_layout.py, render-record.py]
2026-09-26 fix(loom): stop worktree.sh resetting a branch back past its own pushed tip
    worktree.sh's "worktree directory already exists and is registered with git"
    fast path decided preserve-vs-reset from two inputs only: commits ahead of
    BASE_REF, and `git status --porcelain`. A worktree parked at a plain `main`
    commit is legitimately 0-ahead and clean, so it scored "stale" and the LOCAL
    branch ref was `git reset --hard`-ed back to BASE_REF -- moving it backwards
    past its own pushed tip, which on a branch with an open PR is that PR's head.
    The drift report printed 13 lines earlier ("is behind the pushed tip of
    branch ...") had already computed exactly that fact and then discarded it.
    The hazard is n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
2026-09-27 fix(#477): remove unused variable in via4-landing check
    Delete the dead local variable `y = (ry0 + ry1) / 2.0` from line 1904
    in the via4-landing validation loop inside `_check_decoupling_caps()`.
    The variable was assigned but never read anywhere in the loop, enclosing
    function, or error messages.
    Verified with `ruff check --select F841 layout/sar-adc-top/bin/build_layout.py`
    — no F841 warnings remain.
    [build_layout.py]
2026-09-27 refactor(#486): dedup run_supply_impedance.py's four record-writer table blocks
    Extract the shared record-open prologue (_open_corners_record) and three
    hand-duplicated report tables (_captured_code_table_lines,
    _rail_current_table_lines, _wall_clock_table_lines) out of write_record,
    write_sweep_record, write_null_sweep_record, and write_decap_esr_record.
    write_record's own arm/control derivation (arms_run/controls, a per-corner
    control dict) is genuinely different logic from the other three writers'
    single point-filter list + control, so the prologue helper stops short of
    it rather than forcing an incompatible signature, per the Curator's
    correction on issue #486.
    Reconciles write_decap_e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
2026-09-28 Remove unused, pin-bypassing npm script check:signoff
    check:signoff wrapped signoff/run-signoff.sh --check with an unpinned
    local `klt` (KLT="${KLT:-klt}"), unlike CI's explicit pinned override —
    a footgun a developer could mistake for check:signoff-hashes. It had
    zero callers anywhere in the repo and was never documented as an entry
    point in signoff/README.md.
    Closes #488
2026-09-28 Dedup klt-version/pdk-info provenance fetch into _record_common_strict
    The four strict-discipline render-record.py scripts each carried a
    byte-identical ~11-line block fetching `klt --version` and the
    `klt pdk find --format json` envelope with `subprocess.run(check=True)`,
    even though all four already import `_record_common_strict.py` for their
    other shared plumbing (`build_argparser_strict`, `git_field`,
    `load_json_strict`).
    Move that block into the module as `tool_version_strict()` /
    `resolve_pdk_info_strict()` -- the strict analogue of the lenient
    `_record_common.py`'s `tool_version()` / `resolve_pdk_commit()` pair, in
    the same naming and docstring style, and keeping this module's
    raises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
    [render-record.py]
2026-09-28 refactor: drop unused extra_meas parameter from hold-kick build_transient()
    build_transient() in sim/sampling-frontend/run_hold_kick.py accepted an
    optional extra_meas list that appended caller-supplied `.meas tran ... find`
    triples to the deck's fixed 22-name set. None of the function's six call
    sites in that file ever passed it -- including the two that assemble a
    kwargs dict (run_handoff(), run_dead_time()) -- and no other module calls
    this build_transient(), so the knob was never exercised.
    Removes the parameter, the `if extra_meas: meas += extra_meas` guard, and
    the caveat above TRAN_MEASURE_NAMES that only explained what a hypothetical
    future extra_meas caller would have to do. The se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
2026-09-29 Dedup render-record.py markdown sections shared by comparator/sampling-frontend/sampling-frontend-wells
    Extract the byte-identical (or near-identical) `## Provenance` header,
    `## Net correspondence (layout <-> reference)`, and `## Reported LVS
    findings` markdown blocks from the three render-record.py scripts into
    new `render_provenance_header`/`render_net_correspondence`/
    `render_lvs_findings` helpers in the shared
    `layout/bin/_record_common_strict.py` module.
    comparator's hardcoded `error_count = 0` closing sentence is replaced
    with the same `lvs.get('error_count')` interpolation the other two
    scripts already used; verified against every comparator lvs.json fixture
    in this repo's history -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
    [render-record.py]
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2026-10-01 spec: DR-019 resizes CDAC unit cap to a 5 nm-grid-legal plate (1.9000 um)
    Issue #496 asked whether sky130's 5 nm manufacturing grid is a real gate
    for the CDAC unit cap's 1898.8 nm MiM plate, or waivable. Reading the
    PDK's own shipped signoff DRC deck directly (sky130A.lydrc, open_pdks
    c6d73a35f524070e85faff4a6a9eef49553ebc2b) shows the grid/angle rule
    category (x.1b, OFFGRID=true by default) is real and active for nearly
    every metal/via layer that lands on the plate -- 46 of 48 shapes in
    #495's precheck.grid5.json census sit on checked layers. klt drc's own
    curated sky130 deck implements no such rule category at all, so its
    "clean" verdict on this geometry was never evidence of foundry-grid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
2026-10-01 layout/sar-adc-top: re-compose the top level against the current schematic
    Closes the third and last piece of #387. Until now this assembly placed
    `layout/seln-inverters/` -- the nine `SELn<i> = NOT(DOUT<i>)` inverters DR-008
    superseded on 2026-09-11 -- and `bin/generate-lvs-reference.py`'s wrapper was a
    string literal mirroring that same superseded instance list. Both sides of
    `klt lvs` therefore carried the same error, so the compare agreed with itself
    for two weeks of DRC/LVS-clean runs while agreeing with nothing the schematic
    said.
    Composition
    - `bin/build_layout.py` places `top_glue` (33 sky130_fd_sc_hd cells, PR #402)
    and `halflsb_offset` (DR-009's 8 sky130_fd_pr primitives, PR #49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
    [build_layout.py, check-composition-parity.py, generate-lvs-reference.py, probe-decap-sites.py, probe-ground-mesh.py, render-record.py]
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2026-10-01 sim/full-conversion-transient: re-run the 9-corner campaign against the resized C_u
    Append-only re-run (record 20261001-105439-c324f80, Supersedes
    20260912-002315-9aaf1ca) of the whole-ADC transient campaign against
    design/sar_adc_top.spice as resized by DR-019/#498. Same stimulus, same
    9-point ratified OAT grid, same measurement convention; the only changed
    input is the MiM plate side on C_u and on DR-009's Choff_n/Choff_p.
    Measured, not assumed:
    - Every captured code at every corner is bit-identical to the superseded
    record (e.g. tt_27c_1.80v still captures 214/383/511/641/1023 against ideal
    113/384/512/640/911), and the overall verdict is unchanged: FAIL 0/9 against
    this experiment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
2026-10-01 sim/sampling-cdac-handoff: re-run mechanism (d) over PVT against the resized C_u
    testbench/cdac_array_dut.spice is a regenerated fragment of
    design/cdac/cdac_array.sch, so DR-019's resize changes the top-plate load this
    campaign measures mechanism (d) at. Re-run on the full 9-point ratified grid:
    record 20261001-111651-d3f190d, which replaces 20260926-231457-ebf79e8 as
    records/LATEST.
    Measured, not assumed: the acquisition residual moves by +0.001 mV at the
    corners where it is nonzero (binding corner tt_27c_1.62v 0.9260 -> 0.9280 mV,
    +0.22%; tt_27c_1.80v 0.0110 -> 0.0120 mV), i.e. slightly larger, in the
    direction +0.116% more top-plate capacitance predicts. All 9/9 ratified corner
    points s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
2026-10-01 sim/cdac-array-transfer: re-run the ratified-row campaign against the resized C_u
    Append-only re-run (record 20261001-120402-d24f700, Supersedes
    20260827-213107-e13bc1e) of the campaign that grades spec/target-spec.md's
    ratified CDAC unit-cap/array-size row. The superseded record's structural check
    graded the DUT fragment against `W=L=1.8988um`/`C_u ~= 8.65 fF` -- a value the
    spec row no longer carries after DR-019.
    Measured, not assumed: structural check PASS at W=L=1.9000um with the same
    weights (1..256 + 1 termination = 512/side); monotonicity and polarity PASS at
    all 9 ratified corner points; binding corner unchanged (tt_27c_1.62v, smallest
    adjacent-code gap 0.80506 -> 0.80505 V, i.e. -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
2026-10-01 sim/cdac-array-transfer: re-run the #29 CDAC-mismatch Monte Carlo against the resized C_u
    Append-only re-run of the N=40, seed-1, tt_mm mismatch campaign against the
    DR-019-resized unit cap: record 20261001-124049-5207381, which replaces
    20260828-005006-0c70212 for the same claim (run_mc.py has no --supersedes flag
    -- see the follow-up issue; the replacement is stated in the record's Note, in
    this message, and by the ENOB record that now cites the new id).
    Same N, same seed sequence, same mismatch corner, same nominal PVT point, so
    the only changed input is the plate side. Measured, not assumed -- and this is
    the campaign where DR-019's "sigma_u improves fractionally, so every DR-003
    Item 3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
2026-10-01 sim/enob-estimate: re-compose the ENOB estimate on the re-run Monte Carlo record
    This campaign executes no ngspice of its own -- it composes a behavioral-
    accelerated ENOB estimate from the comparator-noise corner campaign, the CDAC
    mismatch Monte Carlo, and an analytic kT/C term. DR-019's resize moves one of
    those three inputs, so the record is re-composed against the re-run MC record:
    new record 20261001-124717-ba6875d (records/LATEST), replacing
    20260925-090023-c3a6872.
    Measured, not assumed: the CDAC-mismatch term's mean-case contribution goes
    2.5281 -> 2.5256 mV rms (the re-run MC's mean max|INL| 0.7191 -> 0.7184 LSB),
    total noise 2.8589 -> 2.8567 mV rms, and achieved mean-case ENOB 8.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
2026-10-01 docs+indexes: re-point every citation of a re-run record at the new one
    The six campaign re-runs in this PR's earlier commits move what this repo's
    live evidence indexes should be citing. All four of its citation gates
    (`npm run check:report`, `check:spec-coverage`, `check:proposal-citations`,
    `check:signoff-hashes`) caught the drift; this commit is what they asked for.
    - sim/report/manifest.py: the five superseded/replaced record ids re-pointed at
    their re-runs, and the Power row's #263 UPDATE note gains a #498 paragraph
    carrying the new 21.612/27.986/34.254 uW figures and the fact that no captured
    code moved. docs/characterization-report.md regenerated from it.
    - sim/spec-coverage.j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
2026-10-01 review: make the carried-through evidence reproducible and non-stale
    Addresses the four blocking items in the Judge's review of PR #503. All four
    are accuracy-of-evidence fixes; no design value and no verdict moves.
    1. layout/cdac-array/'s committed record could not be reproduced by the
    committed render-record.py. The script's precheck verdicts are appended
    (9-12) but reports/20261001-084525-79abbf8/record.md lists them interleaved
    at 2/3/6/7 -- it was minted by a pre-final version of the script. Fixed by
    re-running the ~10 s flow at the same geometry: the new record
    (reports/20261001-133221-7487784/) re-renders byte-for-byte from its own
    committed JSON envelopes, verified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
    [cdac_unit_cell.sch]
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2026-10-01 chore(tooling): update repo-skills to v0.19.5
    Fleet-wide Repo Skills rollout (2026-10-01). compute-drift's axis 6
    reported repo-skills at 11 different versions across the fleet's
    checkouts; this brings sky130-sar-adc from v0.10.0 to v0.19.5 (rjwalters/repo
    @ ff282cd), staging only the installer's own surface.
    Loom-Trace-Id: 038dce5d677bceeeca3c111787ac5b68
    Loom-Build: unknown unknown unknown
    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
2026-10-01 docs(sim): correct spec-coverage Sampling-cap note to post-DR-019 C_u
    The evidence index's Sampling cap (CDAC unit x array) note restated the
    pre-DR-019 `C_u ~= 8.65 fF` as the current ratified value, and that string
    rendered verbatim into the committed `sim/spec-coverage.md`. The ratified
    row in `spec/target-spec.md` has read `C_u ~= 8.66 fF` (1.9000 um
    grid-legal plate) since DR-019 via #496.
    Update the note to the post-resize figure and give it the same amendment
    framing the neighbouring `sim/report/manifest.py` notes use (what moved,
    when, under which decision record) rather than a bare renumber, then
    re-render the generated `.md`.
    Closes #504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
2026-10-01 layout(sar-adc-top): re-compose the top level against DR-019's resized sub-blocks
    `layout/sar-adc-top/bin/run-flow.sh` re-run so the composition embeds the
    resized `cdac_array.gds`/`halflsb_offset.gds` DR-019's grid-legal `C_u`
    plate produced (issue #498 carried the resize through `design/` and the two
    sub-block flows but deliberately left the composition on the pre-resize
    1.898 µm plate). New append-only records:
    - `layout/sar-adc-top/reports/20261001-211249-1ca34e6/` (flow; the parity
    gate and its negative control passed before it was minted)
    - `layout/sar-adc-top/erc-reports/20261001-211722-1ca34e6/` (`klt erc`
    re-run on the new GDS, plus a fresh `probe-ground-mesh.py` ablation)
    Di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
2026-10-01 docs(chipalooza): correct the per-plate growth figure to 2 nm (during evaluation)
    The §4 Area-row bullet said "a 12 nm per-plate growth"; the measured
    resize is 1.898 -> 1.900 um drawn, i.e. 2 nm per plate side, which is
    what the same bullet's own `1026 x (1.900^2 - 1.898^2)` and
    layout/sar-adc-top/README.md's parallel sentence already state. Prose
    typo only -- no readout, citation or artefact changes.
    Loom-Story: 2AMLogic/sky130-sar-adc#501
    Loom-Trace-Id: 83a056e1bc5923ca0334384882a06bf7
    Loom-Build: 0.19.602 f3a17ac8004b5fbfccdfc7a742aac710e77a06e1 clean
2026-10-02 fix(signoff): correct envelope _comment's claim about ENOB/INL-DNL grading targets
    signoff/evidence/characterization-report.generic.json's `_comment` claimed the
    characterization report grades ENOB and INL/DNL "against DR-007's (still
    unratified) candidate targets". It does not: sim/report/manifest.py grades the
    `enob` row against the pre-DR-007 DRAFT baseline (> 9.0 bit) and the `inl-dnl`
    row against the pre-DR-007 DRAFT target (<= +-1 LSB, target_yield=0.99).
    Replace that one sentence with an explicit statement of which target each of
    the two verdicts actually grades, and why those citations deliberately differ
    from spec/target-spec.md's current `DRAFT (target value, DR-007 candidate)` ro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
2026-10-02 docs(sar-adc-top): restate the ground mesh as four-legged, from the script
    `analog_ground_mesh()` has drawn a fourth member since issue #401 --
    `halflsb_offset.GND`, routed by `halflsb_leg("GND")` -- but the README's
    "The analog ground pad (issue #362) and mesh (issue #377)" section and
    `analog_ground_pad_without_mesh()`'s docstring both still described the
    pre-#401 three-legged shape.
    Geometry below is read off `analog_ground_mesh()`'s own `segments` and
    confirmed against the current record's drawn shapes
    (`reports/20261001-211249-1ca34e6/draw.request.json`): the met3
    `halflsb_column` at x 122.951 .. 123.351, y 58.9 .. 79.03 and the met1
    `halflsb_row` at y 59.03 .. 59.17, x -16.07 .. 123.2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
    [build_layout.py]
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2026-10-02 feat(comparator-decision): offset-bisect mode, separating systematic offset from a dead band
    `sim/comparator-decision/run.py` gains an `offset-bisect` subcommand that
    measures the comparator's decision boundaries over `Vindiff` directly, rather
    than inferring an input-referred offset from an early-time pick-off amplitude.
    The gap it closes (issue #515, cross-pollinated methodology from the sibling
    canary 2AMLogic/sky130-comparator, its #66 / #119 -- shape only, that repo's
    source was never inspected): every decision test elsewhere in this driver is
    sign-corrected against the applied input, so a WRONG-POLARITY decision and a
    NON-DECISION fail it identically and both read UNRESOLVED.
    `RegenCo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
2026-10-03 layout: re-instate SAR_ADC_TOP_KLT override in sar-adc-top run-flow.sh (issue #103)
    Loom-Story: 2AMLogic/sky130-sar-adc#103
    Loom-Trace-Id: 0a314641208ed8fa71752d7354ddaf28
    Loom-Build: 0.19.624 5f49564fa78ae06f8c48d5224dae9ded04200bb7 clean
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2026-10-03 docs(spec): fix DR-021 cited LSB range and Supersedes wording
    - The 2026-10-01 campaign (20261001-105439-c324f80.md) reads -0.78*V_REF
    off by +71 to +124 LSB across the 9 corners (+71 at tt_125c_1.80v), not
    101-124.
    - Supersedes line: "closes"/"discharges" -> "proposes a resolution to",
    consistent with the Status line and the DR-008 Open items pointer (the
    defect stays open until the follow-up passes the verification gate).
    Addresses Judge review on PR #526.
    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
2026-10-03 docs(chipalooza): re-file check 37, the sim/ campaign-citation census (issue #121)
    Re-files only the check-37 half of closed PR #470 against current main,
    per the operator's 2026-09-30 ruling on that PR.
    - check_proposal_citations.py: check_campaign_census (check 37) and its
    --stats sentence. Module comment rewritten for the post-#481 tree; the
    superseded half-load framing is dropped.
    - citation-gate.md: check 37 rationale, restated against the three
    campaigns that were actually uncited on main.
    - test_proposal_citations.py: TestCampaignCensus, the real-tree class,
    and the TestCoverageIndexParity.graded() helper.
    - challenge-4-proposal.md: Corners cites the two harness self-test
    r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
2026-10-03 docs(chipalooza): add DR-021 to the decision-record status readout
    Check 15 requires the proposal to state every record in
    spec/decision-records/ or none; the new DR-021 (proposed) was missing,
    failing test_proposal_citations on PR #526.
    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
2026-10-03 layout: sar-adc-top abstract-cells compare matches on klt main (#2396/#2398 fixed); on-grid placement fixes (#103)
    Promotes the --abstract-cells hollow-reference compare into run-flow.sh as
    step 7b, adds a generated hollow reference, and snaps the digital macro
    origins and escape leads onto the 0.005 um grid. Record
    20261003-000826-5b86886: DRC clean, abstract-cells LVS match.
    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
    [build_layout.py]
2026-10-03 docs(citation-gate): correct check 37 docstring's directory-mention claim (during evaluation)
    The campaign_census docstring still carried PR #470's 'a dozen places each'
    count and said the proposal named sim/sampling-frontend/'s testbench path
    repeatedly; on main it names that campaign nowhere. Aligned with the wording
    docs/citation-gate.md already uses. Comment-only, no behavior change.
    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
2026-10-03 docs(spec): add DR-021 proposing a systematic gain-error spec row for the CDAC
    Draft decision record for issue #269 (decision step only; nothing is
    implemented). Recommends option 3: specify the top-plate-divider gain
    error as a DRAFT "Gain error, systematic" row (<= 1.42 LSB span-referred,
    derived by gf180-sar-adc DR-0012's equal-share method from DR-003 Item 3's
    ratified C_u), and split -- not loosen -- the full-conversion-transient
    criterion. Rejects resizing C_u (option 1) and the comparator input pair
    (option 2): DR-009's one-unit half-LSB cell alone is 2.0 LSB, above the
    candidate at any C_u.
    Re-derives the measured gain from the committed decision-margin trace
    (20260912-011519-9aaf1c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
2026-10-03 docs(spec): renumber the CDAC gain-error DR from DR-021 to DR-022
    PR #526 landed a different DR-021 (near-full-scale common-mode droop) on
    main. Renumber this record to the next free number, DR-022: rename the
    file, update its heading and self-reference, and point the proposal's
    DR status readout entry at DR-022 after main's DR-021 entry.
    Part of #269
    Loom-Story: 2AMLogic/sky130-sar-adc#269
    Loom-Trace-Id: c1243d5f1ad458e190b015a034ba27a2
    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
2026-10-03 docs(chipalooza): re-derive the pointerless-flow prose counts and per-record claims (issue #121)
    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
2026-10-03 layout: re-measure sar-adc-top on post-#2396/#2398 klt; snap halflsb_offset onto the 0.005 um grid (#103)
    DRC clean with the ongrid rules, --abstract-cells compare match, flat compare
    still mismatch (klayout-tools#1878).
    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
    [build_layout.py]
2026-10-03 docs(chipalooza): restate the proposal against #103's 20261003-041400-571f036 record
    Re-derived from `check_proposal_citations.py --stats`, not edited to fit:
    - Section 4's four layout/sar-adc-top rows (Sample rate, Area, post-layout
    PVT, DRC/LVS) and the section 3 and section 7 hop chains now cite
    20261003-041400-571f036 as the current reports/LATEST, with
    20261001-211249-1ca34e6 recorded as superseded.
    - Sign-off-bar readout is now 68 mismatches / 66 errors. The 67 earlier
    entries recur verbatim, and the +1 is a new device.geometry_not_compared
    warning (MiM class). The present-tense "67 mismatches" claims are restated
    as 68, with the dated figures attributed to their records.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
2026-10-03 docs(chipalooza): de-stale §7 Item 8 -- #267/#269 no longer operator-decision; cite the current full-conversion record
    §7 Item 8 claimed #267 and #269 carry loom:operator-only +
    loom:operator-decision "(verified live, this pass)". The operator removed
    both labels on 2026-10-02T23:59Z / 2026-10-03T00:00Z. Record their live
    state: #267's DR-021 merged as `proposed` (PR #526); #269's DR-022 is in
    open PR #530 (changes-requested + blocked). No verdict moves.
    The same paragraph said records/LATEST still names the pre-PR #270
    20260912-002315-9aaf1ca and that no post-#270 full corner-grid record
    exists. LATEST has named 20261001-105439-c324f80 (issue #498, post-DR-009
    and post-DR-019) since 2026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
2026-10-03 docs(chipalooza): re-check rules-4.html on 2026-10-03; record republished index and challenge-4.html stub (issue #121)
    Loom-Build: 0.19.633 346aff41fad5597fb95fba4884169fca70f8d121 clean
    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
2026-10-03 feat(sim): post-layout vs schematic comparison + DR-020 half-LSB verdict in extracted offset-bisect records (#525)
    An extracted-DUT offset-bisect record previously reused schematic-only prose:
    item 5 claimed 'this repo cannot replicate a post-layout result at all yet',
    and item 1 read a resolved tt/27C offset as a measurement indictment, which
    does not hold for a layout that is not symmetric by construction.
    - Claim line, item 1 and item 5 branch on the fragment that ran; the
    schematic path's text is unchanged.
    - New 'Post-layout vs schematic' section cross-citing 20261002-203719-c898d06,
    with an explicit YES/NO on whether either shape appears and a
    TRIGGERED/NOT-TRIGGERED/UNDETERMINE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
2026-10-03 feat(sim): extracted-DUT offset-bisect prose: delay-asymmetry sign check, no negative-control claim (#525)
    On a layout that is not symmetric by construction, +V/-V decision delays need
    not match and a tt/27C offset is not a negative-control failure. For the
    extracted fragment only:
    - item 4 checks that t(+V)-t(-V) has the sign the measured offset predicts
    (_signed_delay_asymmetry, _delay_asymmetry_agrees_with_offset);
    - the subset-corner bullet points at the schematic record for the control;
    - the pick-off comparison notes it crosses a netlist class.
    Schematic-record text is unchanged (covered by a render test).
    Loom-Story: 2AMLogic/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
2026-10-03 feat(sim): post-layout offset-bisect record on klt pex extracted comparator (#525)
    tt/27C offset +0.6866 mV, ss/-40C +0.5219 mV, no resolved dead band; below the 1.7578 mV half-LSB so DR-020 is corroborated, not superseded.
    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
2026-10-03 feat(comparator-decision): per-draw decision-boundary bisection (offset-bisect-mc) (#524)
    `run.py offset-bisect-mc` runs run_offset_bisect() once per Monte Carlo
    draw at `<corner>_mm` (rndseed = seed+i), with a +-200 mV wider coarse
    scan, plus a mismatch-disabled negative control over the same seed
    sequence.
    Rebased onto main after #533: `_regen_deck`/`_bisect_probe`/
    `run_offset_bisect` carry both `dut_fragment` and `rndseed`; the MC runner
    and writer thread `dut_fragment` (`--dut` now applies to offset-bisect-mc)
    and name it via `_dut_provenance()`.
    Review fixes (PR #536):
    - raw probe logs go under `mc-draws/<record-id>/` (the .gitignore
    exception), not the ignored `offset-bisect-mc/`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
2026-10-03 docs(chipalooza): restate #267 as closed via PR #540, with DR-021 still proposed (Part of #121)
    §7 Item 8 said #267 was "still open". PR #540 (`Closes #267`) closed it on
    2026-10-03T11:30:25Z. Closing the issue did not ratify DR-021, whose Status on
    main still reads `proposed`, and no follow-up implementation issue exists yet.
    This commit restates the issue state in §7 Item 8's heading and #267 bullet,
    and in §4's Sample rate and Power rows. The decision stays unresolved and no
    verdict moves.
    Loom-Build: 0.19.649 8f615d74400808cdfb9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
2026-10-07 docs(chipalooza): record #103/klayout-tools#2722 state as of 2026-10-07 in §7 Item 1 (Part of #121)
    #2722 is curated but Champion returned NEEDS REVISION (2026-10-06), so no
    upstream fix is in flight. Clarify that v0.6.0 is the latest tag (pinned in
    layout/requirements.txt) while v0.5.0 is the latest GitHub Release; both
    predate #2722. No section 4 verdict moves.
    Loom-Build: 0.19.820 a7b306971c571e9f72731a3ad4668e07ec803018 clean
    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
2026-10-08 fix(sim): persist klt yield samples document beside report (#563)
    Loom-Story: 2AMLogic/sky130-sar-adc#563
    Loom-Trace-Id: a7b4d62d4588ed495258332d1bc4bdc1
    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
2026-10-08 fix(sim): reject non-finite SPICE measurements before conversion verdicts (#569)
    measure.parse() now drops any converted value that is not finite (an
    exponent-overflow token such as 1e999 matches the numeric regex and
    float() turns it into +-inf). A rejected value is treated like an
    unconvertible token: it does not claim the name, so a later finite
    occurrence still wins and an all-overflow name is reported by missing().
    run_conversion.decode() treats absent or non-finite code / BUSY / SAMPLE
    measurements as unavailable (no bit, no margin entry). A missing or
    non-finite required supply current is omitted, fails the point
    (all_ok=False), and -- when it carries a power term -- sets power_w to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
2026-10-08 fix(sim): render unavailable power as n/a in supply-impedance records (#569)
    run_conversion.decode() can now return power_w=None (and omit a missing or
    non-finite current from `currents`). The three average-current tables in
    run_supply_impedance.py still computed `p['power_w'] * 1e6` and would raise
    TypeError on such a point: write_record()'s per-corner table,
    _rail_current_table_lines() (both sweep writers), and
    write_decap_esr_record()'s per-rung table.
    Add _uw() (n/a for None, same convention as run_conversion's
    format_point()/write_record()) and a shared _avg_current_cells() row helper
    used by write_record() and write_decap_esr_record(). Finite output is
    byte-identical to the previous r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
2026-10-08 lint: discover tracked shell scripts for bash -n instead of a hand list (#582)
    Replaces the 17-entry bash -n chain with git ls-files discovery
    (NUL-delimited, sequential), covering the 4 previously unchecked scripts.
    Loom-Story: 2AMLogic/sky130-sar-adc#582
    Loom-Trace-Id: b6d7a3a4bd6afe6feed9f4c42377fc09
    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
2026-10-08 sim/enob-estimate: per-draw conditional ENOB samples for klt yield (#587)
    Derive one conditional analytical ENOB estimate per real CDAC MC draw from the
    source campaign's raw logs (index/seed traced), fail on missing/incomplete/
    non-finite draws, keep mean/worst headlines, mint new superseding record
    20261008-233032-8bc3d1f plus sibling samples document, refresh the proposal
    citations that track the ENOB flow's current record.
    Loom-Story: 2AMLogic/sky130-sar-adc#587
    Loom-Trace-Id: 76311078a68317f6aab2625c4cfa61dc
    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
2026-10-09 test: PDK-free deck-builder tests for cdac-array-transfer, acquisition-settling, comparator kickback/pickoff/noise (#593)
    Loom-Story: 2AMLogic/sky130-sar-adc#593
    Loom-Trace-Id: 63bf70b1348624718f094d0f971bfca8
    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
2026-10-10 signoff: fix Item 6 envelope count (five, not four/two)
    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
2026-10-10 fix(sim): tie digital-partition transient step to the edge time; retry fleet capacity refusals (#619)
    A T/100 step cap mis-captured a sign-bit register at one corner (fine step
    and unloaded deck both captured it correctly): numerical, so the step is now
    tr/10. Capacity refusals re-submit to the same batch backend; any other
    submit error still stops the campaign.
    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
2026-10-10 fix(sim): digital-partition deck uses one solver thread, 2 ns max edge; control runs alongside search (#619)
    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
2026-10-10 fix(sim): read klt's stderr error envelope so capacity refusals are retried (#619)
    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
2026-10-10 fix(sim): cap digital-partition input edges at 0.3 ns; slow edges corrupt cold-corner captures (#619)
    1-2 ns edges made tt/-40C skip ring edges and fs/27C mis-capture the sign
    bit; the same decks pass with 0.3 ns edges at coarse and fine steps alike.
    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
2026-10-10 fix: correct conversion-9 narrative to the log; restate proposal censuses (#621)
    - README, spec-coverage covers text (json + md) and the proposal ENOB row:
    the bit-4 trial (phase 5) makes its normal +0.057 V step
    (nt_c9_p5_top_p_mid = 0.860 V); TOP_P then drops ~1.37 V to -0.505 V
    later in the same phase, before the pre-capture probe. The README cites
    the log lines, and the bit-group remark is labelled as unverified
    inference.
    - Proposal censuses restated from check_proposal_citations.py --stats:
    ground-return decks 188 -> 190, provenance sim records 85 -> 86, and
    Section 4 corner-grid pairs 36 -> 37 / subset 12 -> 13 (the new record
    is listed).
    - run_conversion.py: drop the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
2026-10-11 sim: conversion-9 switching-event record; probe ring nets, D-path, solver control (#621)
    New append-only record 20261011-021527-8d0c19a (pinned ngspice-47, PDK
    c6d73a35, CI run 38104167999, --sine-trace 9 --sine-switch-trace 9;
    Supersedes 20261010-204225-57a55c1). It re-captures the same stream
    bit-for-bit (conversion 9: 960 vs ideal 522) and observes DOUT8/7/6/2
    switching 0->1 together at phase 5 +44.32 ns -- 2.65 ns after the CLK
    falling edge, with no CLK rising edge -- after which SELp8/7/6/2 move the
    P bottom plates and TOP_P leaves the rails.
    That record's ring probes came back missing: subckt ports are not
    addressable as xseq.<port> in ngspice. The probe now resolves ring ports
    to the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
2026-10-11 sim: conversion-9 root cause -- default-solver artefact; reference + control records (#621)
    Two more pinned-toolchain coherent-sine runs (ngspice-47, PDK c6d73a35,
    off-host via the opt-in coherent-sine-evidence CI job, runs 38104945213 and
    38104951015):
    - 20261011-022915-877794b (default solver settings, --sine-switch-trace 9;
    Supersedes 20261011-021527-8d0c19a; bit-identical stream). With the ring
    now probed correctly, it observes the already-rejected registers
    DOUT8/7/6 and DOUT2 switching 0->1 together, along with their own
    MUXOUT/PRESET/DFEED D-paths, at phase 5 +44.27..+44.32 ns. That is
    during the comparator's regeneration, with no CLK rising edge and ideal
    supplies. SELp8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
2026-10-11 sim: named transient solver profiles and a DC baseline solver audit (#637)
    Solver settings for the full-conversion transient become a named policy
    resolved at deck assembly (SOLVER_PROFILES: ngspice-default reference,
    reltol-gear, reltol-only, gear-only). The reference profile adds no
    .options card; every other profile is a labelled SOLVER CONTROL that is
    refused with --supersedes, --corners and the diagnostic modes, and whose
    record never moves records/LATEST (enforced in write_record too).
    --solver-audit runs the DC baseline corner under the reference profile and
    each control profile sequentially, with identical print-only accounting and
    read-only register-transition guard probes, and min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
2026-10-11 sim: DC baseline solver audit + coherent-sine single-setting controls (#637)
    Append-only evidence from the pinned off-host toolchain (ngspice-47, PDK
    c6d73a35), via the manual-dispatch CI jobs on feature/issue-637:
    - records/20261011-064547-a6dcdd7.md: --solver-audit at tt/27C/1.8V
    (run 38118730394). Reference ngspice-default reproduces LATEST's row
    bit-for-bit; no recorded failure mode moves under reltol-gear,
    reltol-only or gear-only. Power moves -1.9..-2.8%. Simulator wall-clock
    76 / 127 / 114 / 74 s.
    - records/20261011-064924-ad4bfff.md (reltol-only, run 38118797662) and
    records/20261011-064408-ad4bfff.md (gear-only, run 38118803663):
    coherent-sine controls with --sine-switc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
2026-10-11 spec+sim: DR-023 adopts reltol=1e-4 + Gear as the full-conversion solver policy (#637)
    DR-023 (proposed) decides, on the #637 off-host evidence, that every
    transient sim/full-conversion-transient/run_conversion.py assembles
    integrates with `.options reltol=1e-4 method=gear` (profile reltol-gear)
    instead of ngspice's defaults. Either setting alone removes the #621
    conversion-9 artefact; at the DC baseline corner no recorded failure mode
    moves under any profile, power moves -1.9..-2.8 %, and the like-for-like
    simulator cost is 1.66x (76 s -> 127 s). The record carries the rejected
    alternatives (keep defaults + guard, gear-only, reltol-only, tighter still,
    harness-wide default), the date/commit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
2026-10-11 sim+spec: keep pre-DR-023 records reproducible under ngspice-default (#637)
    Address the Judge review on PR #639:
    - run_conversion.py: `--solver-profile ngspice-default` (the settings of
    every pre-DR-023 record) is now accepted with --corners and every
    diagnostic mode (--mechanism-probe, --node-trace, --cm-trace,
    --decision-margin-trace). The resolved profile is threaded through each
    diagnostic runner; their records state `simulator options`, carry a
    SOLVER-CONTROL bullet under a control profile, and name the profile in
    Written by. Controls still never move records/LATEST and may not
    --supersedes (CLI and writer guards unchanged); reltol-only/gear-only
    stay limited to the bas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
2026-10-11 ci: opt-in DC reference corner campaign dispatch for DR-023 re-mint (#638)
    Adds a manual-dispatch-only full-conversion-reference-campaign job that runs
    --corners --record --solver-profile reltol-gear on the pinned ngspice/PDK,
    classifies a complete informational FAIL apart from an incomplete run,
    collects the modified tracked records/LATEST, and uploads diagnostics even on
    failure. Excludes the dispatch from pdk-smoke. The coherent-sine collector now
    records whether records/LATEST was left untouched.
    Loom-Story: 2AMLogic/sky130-sar-adc#638
    Loom-Trace-Id: 0d9f7267792fa48018c91e9fe35b24ac
    Loom-Build: 0.19.1050 abf3f7109328fd66ec77827f5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
2026-10-12 fix(layout): drop redundant and failed-env report records (PR review)
    Judge review flagged two issues:
    - CI 'Repo checks' failed at lint: the failed-env record
    20261012-113729-743bcd0 held a 0-byte pnr.json (klt aborted before
    P&R wrote output), which python3 -m json.tool rejects.
    - The PR body promised one baseline + one post-refactor record per
    block, but four additional successful reruns (sar-sequencer
    20261012-113143/113403, seln-inverters 20261012-113213, top-glue
    20261012-113234) were also committed.
    All five records were added by this PR (none exist on main), carry no
    verification value beyond the kept baseline/post-refactor pairs, and
    are removed here. The ambient-$PDK fai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
2026-10-13 fix(signoff): verify lvs environment digests even when an input hash is present
    The environment-digest leg of check_evidence_hashes.py ran only when the
    cited lvs envelope recorded NO provenance.input.content_hash (the klt 0.5.0
    shape). The pinned 0.6.0 grader records one -- role "netlist", the hash of
    the LAYOUT netlist -- so on every envelope the repo actually cites, the old
    gating skipped the environment leg entirely and the REFERENCE netlist
    silently lost its only verification. Run the leg for every lvs citation;
    on an input-hash envelope the layout check doubles as a cross-check that
    provenance.input and environment.layout_sha256 agree.
    Item 4's pin stays omitted (still decorative: che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
2026-10-17 layout(sar-adc-top): declare n-well ties[] in the ERC supply spec and mint a record that computes erc.missing_tie
    klayout-tools#2169 is fixed in the pinned klt 0.6.0, so the tool_limitation
    ties_disclosure is dropped and two n-well ties (VDD, VPWR) are declared.
    The new record grades the same GDS the sign-off manifest cites: supply
    continuity unchanged, 28 erc.missing_tie findings (26 wells, 2 with no tap
    on either rail). The p-substrate half is not declarable (klayout-tools#3750).
    Closes #677
2026-10-17 docs(erc): cite #684/#685 for the 28 missing_tie findings in the 20261017 record
    Tracks the 2 untapped wells (#684) and the 24 cross-domain flags (#685); notes
    the well-side selector exists upstream in klt v0.7.0, post-dating the 0.6.0 pin.
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2026-10-17 fix(sim): index non-SPICE digital campaigns and restate proposal censuses
    CI reached npm test once the 3.11 syntax error was fixed and failed five
    checks, all from the new sim/digital-functional and sim/digital-sta records:
    - sim/spec-coverage.json: new non_spice_campaigns section (runner, records,
    documented cold start; no ngspice pin, since none is run), checked by
    sim/check_spec_coverage.py, with tests. Their records fit neither a row
    bench nor a harness proof.
    - challenge-4-proposal.md: campaign census 17/17, provenance census 94 of 96
    with the two non-ngspice records explained, T1 readout 5 of 22, and an
    update paragraph citing both records.
    - test_proposal_citations: the sim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
2026-10-21 docs: re-point proposal citations at the open_pdks f6eeac7 re-run records
    Re-point the 12 'current LATEST' claims, restate the composition-input,
    ERC, T1 sign-off and provenance-census readouts from --stats, and cite
    issue #708's ERC re-run. The new layout records match their predecessors'
    DRC/LVS fields and counts (and composed bbox_um); only the PDK commit,
    PDK root, repo commit, paths and hashes differ. The ERC readout stays
    stale by record stamp (the graded GDS is byte-identical).
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2026-10-27 test: define check-26 sim population as all records outside non_spice_campaigns
    Per the 2026-10-23 operator ruling (item b): the pinned-record population is
    every sim/ record except those under an experiment in non_spice_campaigns,
    not 'records that name an ngspice version', so a SPICE record that omits its
    ngspice version falls short again. Adds a regression test for that case.
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2026-10-27 fix(layout): widen via1 landing pads to clear klt 0.8.0 via.5a/m2.5
    Add 0.32 um met1/met2 pads at every via1 site in the comparator,
    halflsb-offset and sampling-frontend routing; re-run those flows and
    sar-adc-top at the pinned klt 0.6.0 (new append-only records). Record
    before/after 0.8.0 counts and the poly.8 / via3.width disposition.
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2026-10-27 fix: widen met2 pads at via2 cuts to clear via2.5 enclosure
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2026-11-01 sim: add CDAC mismatch gain-error reanalysis and record (tt_mm, N=40)
    Adds a span-referred gain-error statistic to run_mc.py (--reanalyze --gain-error),
    a unit test, and a new append-only record re-parsing the committed 40 draws.
    Measured 3-sigma is ~0.028 LSB vs the analytic 1.4191 LSB at tt/27C/1.8V.
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2026-11-01 docs: cite top-plate-cpar campaign and restate proposal census numbers (#754)
    Cite sim/top-plate-cpar/records/20261101-183325-60421e38.md from the
    Gain error row; restate campaign (18), ground-return deck (211),
    provenance (95/99), freshness-coverage (30/21) and corner-grid (42/6)
    censuses from check_proposal_citations.py --stats.
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2026-11-04 docs: correct DR-025 option (b) to keep Msw_x; fix (d) rationale (#755)
    Option (b) now removes only the Csamp/BPREF/Cmsw branch (1.816-2.737 C_u);
    the sampling switch stays. Reach table, decision, cost, probable outcome
    and port-parity text re-derived: (a)+(b) residual is 1.22-1.84 LSB, over
    1.42 at all but hh/lh. Option (d) rejection restated on missing codes,
    undefined calibration block and the 'untrimmed' interpretation.
2026-11-05 fix(layout): widen sampling-frontend-wells via1 pads to clear 0.085 um adjacent enclosure
    Draw met1 and met2 pads of via + 2*0.085 um at each via1 cut. On klt 0.9.0
    composed DRC goes 51 -> 0 (met1/met2.enclosing_adjacent.via.1), LVS still
    matches. Adds before/after records and a dated note.
    Closes #783
2026-11-05 refactor(sim): share one binary-safe file-hash helper across digital run drivers
    Add evidence.sha256_bytes_file (streaming, raw bytes) and replace the four
    byte-identical private sha() copies in the digital-sta / digital-functional
    drivers with an import. Digests are unchanged (sha256 of raw bytes), so
    append-only records stay valid.
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2026-11-06 refactor: share pin-order cache resolver between schematic-parity checks
    Move the duplicated cdl_text_if_available/resolve_pin_orders into
    layout/bin/_lvs_reference_common.py, parameterised on cache path and
    _comment; top-glue and sar-sequencer keep thin wrappers.
2026-11-06 docs: add per-check drift-history and replacement-coverage table for the citation gate
    Evidence only: no check, test, CI wiring or scope-freeze text changes.
2026-11-06 chore: remove retired seln-inverters flow and correct stale 'still consumes' claims
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2026-11-06 sim: replay old netlist snapshots at the f6eeac7 pin to separate PDK effect from design drift
    Two new append-only replay-control records (sampling-frontend common_mode hold
    delta; supply-impedance package/no-gnd-pad GND_die pp) run the stored old
    netlists at the current open_pdks pin, so #810's deltas split into a PDK-only
    and a design-only part. Closes #814 Ask (a); (b) is out of scope.
2026-11-06 docs: restate proposal census for issue #814's two replay records
    The checker reported five stale census figures, not only the provenance one:
    - provenance census sim_pinned 106 -> 108, sim_records 111 -> 113 (+ Update note: both new records pin ngspice-46 and the 40-hex f6eeac7 commit; no flow newly pins it)
    - ground-return deck count 223 -> 225 (two netlist snapshots, no inductor card)
    - freshness-coverage census: sim/sampling-frontend 3 -> 4 records
    Census restatement only; no spec lines touched.
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2026-11-13 refactor: delete 9 unread module constants from layout and sim drivers
    Each of these names was assigned once and read nowhere in the tracked
    tree. Four of them also overstated what the code does by sitting beside
    live siblings: T_SAMPLE_SLOW_NS implied a slow-clock window WINDOW_CONFIG
    never sweeps, FIXED_NETS implied a net list the hold-kick analysis never
    iterates, and MET4_VIA4_ENC_UM / CAPM_SPACE_UM sat in a DRC-rule block
    whose other members are asserted against.
    Removed:
    - layout/comparator/bin/build_layout.py: L_DIFF
    - layout/sar-adc-top/bin/build_layout.py: MET4_VIA4_ENC_UM, CAPM_SPACE_UM
    - sim/cdac-array-transfer/run_mc.py: ANALYTIC_GAIN_SIGMA_UNIT_PCT
    - sim/digital-partition/digit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
2026-11-13 refactor(layout): drop sampling-frontend's duplicate step-down and FET param helpers
    `layout/sampling-frontend/` carried its own byte-identical copies of two
    helpers issue #495 had already lifted into `layout/bin/`, staged there until
    that flow's next re-run. That flow has re-run twice since, and the double
    maintenance was already paid once (`8c00f826` made the same via1 landing-pad
    edit in both copies), so this completes the fold-in the code itself documented.
    - `build_layout.py`: import `step_down_to_met1` from `_geometry_common`,
    repoint both call sites, delete the 80-line local `_step_down_to_met1`, and
    drop the eight constants that lose their last reader with it
    (L_VIA2/L_MET3/L_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
2026-11-13 docs(layout): repoint two sar-adc-top comments at the shared MET3_VIA_INSET_UM (during evaluation)
    The constant no longer exists in layout/sampling-frontend/bin/build_layout.py
    after the issue #845 fold-in; comment-only, no drawn geometry change.
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2026-11-13 sim: add a VINP/VINN source-impedance budget campaign via klt sim
    No sim/ testbench put a series source impedance on the signal inputs:
    full_conversion_tb_fragment.spice drives them from ideal PWL sources and
    sim/vcm-drive-budget/'s only series element is on VCM. This adds
    sim/input-drive-budget/, which sweeps a series R_source on each of VINP
    and VINN and reports the largest swept value whose sampled differential
    error still stays within 1.0 and 0.1 provisional LSB, at the ratified
    9-point PVT grid and at both acquisition windows the sampling-frontend
    campaigns use (DR-006 worst-case 83.333 ns and the legacy 400 ns).
    The DUT is the unmodified sampling front-end fragment, read in place. The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
2026-11-13 fix(sim/report): plot max|DNL| from the committed draw logs, at the record's own sigma
    Judge finding 1: the INL figure, sim/README.md and the proposal all said the
    CDAC Monte Carlo campaign's per-draw max|DNL| samples "were never committed".
    That is false. The campaign's 40 raw draw logs are tracked at
    sim/cdac-array-transfer/mc-draws/20261001-124049-5207381/draw_*.log, and the
    experiment's own pure parser turns them into per-draw max|DNL| that reproduces
    the record's table exactly (mean 0.7828, sigma 0.3080, min 0.3275, max 1.9716).
    Only the yield report's persisted *samples* document points at a scratch path,
    which costs the figure nothing.
    So max|DNL| is now plotted as a distribution rat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
2026-11-13 refactor(layout): share one instance-compare core between the two std-cell parity gates
    `layout/top-glue/` and `layout/sar-sequencer/`'s `check-schematic-parity.py`
    ran the same compare algorithm on two separately-maintained copies -- the
    sequencer gate's own docstring calls itself "the sequencer counterpart" of the
    glue gate. #801 moved the pin-order *cache* half into
    `layout/bin/_lvs_reference_common.py` and left the compare half duplicated, so
    a fix to how one gate resolves an omitted supply pin or reports a drifted net
    silently missed the other. These are the gates `klt lvs` cannot substitute for
    (its reference descends from the same Verilog), so drift inside them is
    exactly the failure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
2026-11-13 docs(chipalooza): scope the VCM headline to the error its records budget
    Second-review blocking point: §2.2.3's `VCM` row led with "No
    low-resistance requirement", which drops the qualifier its own cited
    records carry. The four records budget exactly one quantity — the
    sampled differential error — and the headline declared the pad to have
    no resistance requirement at all.
    - Headline now says the requirement is absent *on the sampled
    differential error*, and states the common-mode level at the pad is
    not budgeted.
    - Row now reports the `VCM(end)` observation from the two decoupling
    records at 100 kΩ / `C_decouple = 0`: 1.566–1.747 V at eight corners
    and 0.919 V at `tt_125c_1.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
2026-11-13 sim: record the VINP/VINN source-impedance budget at 9 corners, both windows
    Runs the campaign on the batch fleet and mints its first record. 9/9
    corners complete at both acquisition windows; no budget is right-censored
    and none is "none found", so every figure is a measured point of the
    sweep rather than a bound.
    At the DR-006 worst-case (83.333 ns) window the 1-LSB budget is 1 kOhm at
    eight corners and 300 ohm at the binding corner tt_27c_1.62v; the 0.1-LSB
    budget runs 100 ohm to 1 kOhm. At the legacy (400 ns) window every corner
    ties at 10 kOhm and 3 kOhm. So the input pads are roughly an order of
    magnitude more demanding than the VCM pad the sibling campaign measured,
    and the worst-case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
2026-11-13 docs(input-drive): state the measured 1 kOhm result instead of "at every corner"
    Judge feedback on PR #857 (blocking): the proposal's new issue #847 paragraph
    said the DRAFT Kickback row's 1 kOhm "is at or beyond this mechanism's own
    1-LSB budget at every corner". That is true under the record's budget
    definition but states less than the record measured, and reads as "1 kOhm has
    no headroom anywhere".
    At R_source = 1000, worst-case window, control-relative, the committed record
    (corners/20261113-110421-e03343e) reports eight corners inside the 1-LSB tier
    (worst -0.1804 LSB at ss_27c_1.80v) and one outside it (-1.6682 LSB at
    tt_27c_1.62v). Say that instead, in the proposal and in the PR body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
2026-11-13 refactor: route four PDK-root lookups through sim/harness/pdk.resolve()
    `probe-decap-sites.py`, `_lvs_reference_common.py`,
    `measure_metal_min_area.py` and `extract-cell-models.py` each hand-rolled
    their own "where is sky130A?" search, with the roots typed in as literals.
    They now call `sim/harness/pdk.resolve()`, which reads the search roots and
    the variant from `sim/pdk.json` -- the one definition the pin-drift gate
    (`toolchain.check_env()` via `pdk.resolved_commit_verified()`) inspects, and
    the one `layout/comparator/pex/run_pex.py` already uses. A re-pin is now a
    `sim/pdk.json` edit, not four literal edits (cf. 7e426b55).
    Each site keeps its own `--pdk-root` override, its own "is the fi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
2026-11-13 refactor(sim): fold ten inline toolchain gates into toolchain.preflight()
    Ten `sim/` driver entry points each re-implemented this module's
    documented exit-code convention inline after calling `check_env()` --
    status 3 -> SKIP/exit 0, status 1 -> FAIL/exit 1, otherwise report the
    warnings and proceed. The copies had drifted into three spellings
    (`SKIP: ngspice/PDK not available (...)` vs `SKIP: ngspice or the pinned
    PDK is not installed on this machine.`, `WARNING:` vs `warning:`), and
    two of them -- `run_bit_trial_settling.py` and `run_transient.py` --
    never read `check.warnings` at all. On a machine with an xschem version
    mismatch, or a PDK install whose commit provenance cannot be verified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
2026-11-13 refactor(sim): one klt_sim submit helper for the four batch campaign drivers
    The four drivers whose corner grid is a `klt sim` request each carried a
    private copy of the same write-request / run-`klt sim` / read-report block,
    and the copies had drifted to three different fleet-capacity policies:
    `reference-drive-budget` and `input-drive-budget` passed
    `--wait-for-capacity`, `digital-partition` set `batch.capacity_wait_s` plus
    its own retry loop, and `top-plate-cpar` passed nothing at all, so a
    `batch_no_capacity` refusal there was a hard campaign failure.
    Add `sim/harness/klt_sim.py` with one `submit()`, one `submit_argv()`, one
    `SubmitError` and one `run_info()`, and port all four drivers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
2026-11-13 refactor(sim): split run_conversion.py into per-campaign modules
    `sim/full-conversion-transient/run_conversion.py` held seven campaigns in
    one 4757-line module. Move each campaign's constants, measure-card
    builders, decode helpers and record writer into its own module under
    `full_conversion_campaigns/`, mirroring the layout `comparator_campaigns/`
    (#613) and `supply_impedance_campaigns/` (#848) already use. The driver
    stays the CLI entry point (610 lines: docstring, argument parser, `main()`
    and the re-exports external importers read).
    `common.py` holds what two or more campaigns use. A name-reference pass
    over the original put three blocks there that the issue's sketch had placed
    with a si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
2026-11-13 fix(vcm-drive-budget): exclude the control row so find_budget() can report "none found"
    `find_budget()` filtered over every row including the sweep's own control
    row. Both `run_sweep()` and `run_decouple_sweep()` seed their baseline from
    their first row, so that row's `diff_err_lsb` is identically zero by
    construction and passed every threshold -- the function could not return
    `None`, and every caller branch reporting "none found" / "unrescued" /
    "< smallest nonzero tested" was unreachable. A verdict whose failing side
    cannot fire is not evidence.
    - `find_budget()` now skips `rows[0]` and is annotated `dict | None` (it
    returns a row, not a float). The exclusion is positional rather than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
2026-11-13 refactor: retire --mechanism-probe from the full-conversion runner
    The comparator-strobe mechanism probe ran the DUT twice at the baseline
    corner -- as committed, and on a testbench-only copy whose comparator
    strobe was re-pointed to a half-period-delayed clock -- and the pair was
    the control. Commit c54c9566 (#264) made the design strobe the comparator
    from CLKN, which both answered the question the probe asked and broke the
    probe: its deck-patching branch anchored on the literal instance-line
    prefix `xcmp VDD CLK `, which `xcmp VDD CLKN ...` no longer matches, so
    the delayed variant raised and the mode produced nothing. Both README
    cold-start campaign commands named the flag and the probe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
2026-11-13 docs(challenge-4): restate vcm rescue counts under the post-#874 convention
    PR #876 made `find_budget()` exclude the sweep's control row and stopped
    counting a corner whose marginal `R_source` is `marginal_r_source()`'s
    fallback as "rescued". The committed records are append-only and keep
    their original wording, but the proposal narrated several of them in
    sentences that only hold under the old convention.
    Restated, each with the derivation read off the cited record's own table
    (no simulation; no file under `sim/*/records/` changes):
    - Legacy-window bare `R_source` (`20260907-090200-7768162`): the four
    binding corners are stated as "no positive budget found" — no nonzero
    swept resist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
2026-11-13 fix(vcm-drive-budget): drop the ">= X pF" claim and check the tt/seed agreement before saying "reproduces"
    Two interpretation sentences written into every new vcm-drive-budget
    record stated more than the run observed. Both are now built by pure
    helpers next to find_budget(), so their wording is unit-testable without
    ngspice.
    - single_corner_decouple_rescue_note(): the single-corner C_decouple note
    in main() said "a decoupling capacitor of >= X pF ... recovers
    differential error", where X is find_budget()'s result -- the LARGEST
    swept value that passed. It now reports that value as the largest swept
    C_decouple confirmed to work, not a floor, and carries the same
    "not monotonic in C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
2026-11-13 test: pin the balance-dummy anchor against the committed netlist
    Judge on PR #883: `TestStripBalanceDummies` claimed a stale anchor "must
    fail here at the commit that moves the netlist", but all four of its tests
    called `_strip_balance_dummies()` with inline literals, so a schematic
    regeneration that renamed or dropped `xdum_mux_n` / `xdum_xnor_n` left them
    green. The claim was unsupported for guard 1 and would have landed in the
    tree.
    Takes the Judge's preferred option: add the committed-netlist counterpart,
    mirroring what guard 2 already has in
    `test_sequencer_port_map_comes_from_the_netlist`. It calls
    `_strip_balance_dummies(fc_common.dut_text())` -- which refuses unless
    design/sar_adc_t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
2026-11-13 sim: run the vcm-drive-budget PVT grid as one klt sim request
    `run_vcm_drive_budget.py --corners` solved its grid as an in-process
    `ngspice` loop -- one subprocess per (corner, swept value), 72 solves for
    the worst-window bare sweep and 117 for its decouple sibling. The host rule
    in CLAUDE.md forbids a hand-launched grid on a shared dispatch worker, so
    the four full-PVT-grid records this mode minted could not be re-run at all.
    Both `--corners` legs are now ONE `klt sim` request per invocation,
    submitted through `sim/harness/klt_sim.py` (which passes
    `--wait-for-capacity 600`), one unit per corner and every swept value an
    `analysis_steps[]` entry inside that unit -- the pattern
    `sim/input-dr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
2026-11-13 fix(harness): scan klt stderr for the error envelope instead of parsing it whole
    `klt` writes its error envelope to stderr, but not alone: install warnings
    and per-job progress lines come first. Both readers of that stream assumed
    it was pure JSON, so against the real shape neither saw the envelope.
    In `klt_sim.submit()` the fallback `json.loads(err)` raised, and the refusal
    was reported as "returned no JSON report" (a client malfunction) quoting the
    PDK-install warning -- while the fleet had actually said `batch_no_capacity`.
    Worse, `capacity_retries` is gated on a DECODED envelope, so a capacity
    refusal arriving behind a warning line skipped the retry path entirely: the
    one policy the mod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
2026-11-13 chore: drop dangling worktree:return npm script
    The `worktree:return` entry in package.json pointed at
    `./.loom/scripts/worktree-return.sh`, which has never been tracked in
    this repo and is not present on disk, so `npm run worktree:return` could
    only ever fail with "not found". Nothing in the tree invoked it: the only
    other occurrence of either name is the backlog line in WORK_PLAN.md
    describing this cleanup, and the `check:ci` chain does not reference it.
    Upstream Loom retired `scripts/worktree-return.sh` in rjwalters/loom
    #13118 (PR #13160) and lists it in `defaults/.loom-retired.list`, and
    `install.sh` only seeds `package.json` when the target repo has none — so
    no resync re-adds this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
2026-11-14 chore(signoff): re-mint item-9 attestation after the top-plate-cpar edit
    `signoff/evidence/item-9.attestation.generic.json` pins a content hash for
    every path its inventory lists, and `checks[9]` hashes
    `sim/top-plate-cpar/run_top_plate_cpar.py` -- the driver this PR edits. Dropping
    the unread `TRACED_RANGE_V` constant shifted that file's sha256, so the
    committed envelope no longer matched a fresh mint and `check:signoff-attest`
    (`signoff/mint_attest_envelopes.py --check`, part of `check:ci`) failed.
    Re-minted with `python3 signoff/mint_attest_envelopes.py`. The script rewrote
    all nine envelopes; exactly one line in one file differs from what was
    committed:
    checks[9].content_hash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
2026-11-14 fix(vcm-drive-budget): derive record interpretation sentences from the data
    The two --corners record writers emitted seven interpretation sentences as
    unconditional string literals. Each asserted a finding, but none was a
    function of the data printed beside it, so no measurement could make the
    writer withhold it -- the shape CLAUDE.md's "Verification is the product"
    rule exists to prevent, and the third instance of it in this file after
    #874 and #882.
    Three of the seven are now rendered by pure helpers:
    - bare_budget_spread_note() renders the worst-to-best spread clause from
    the ratio and the censoring facts. The old literal appended "the bare
    R_source budget is **not** corner-invarian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
